steveamena/Graduacion/Solución/Diseño Mecánico/Transportadores/Transportador 3D Creativa.jpeg

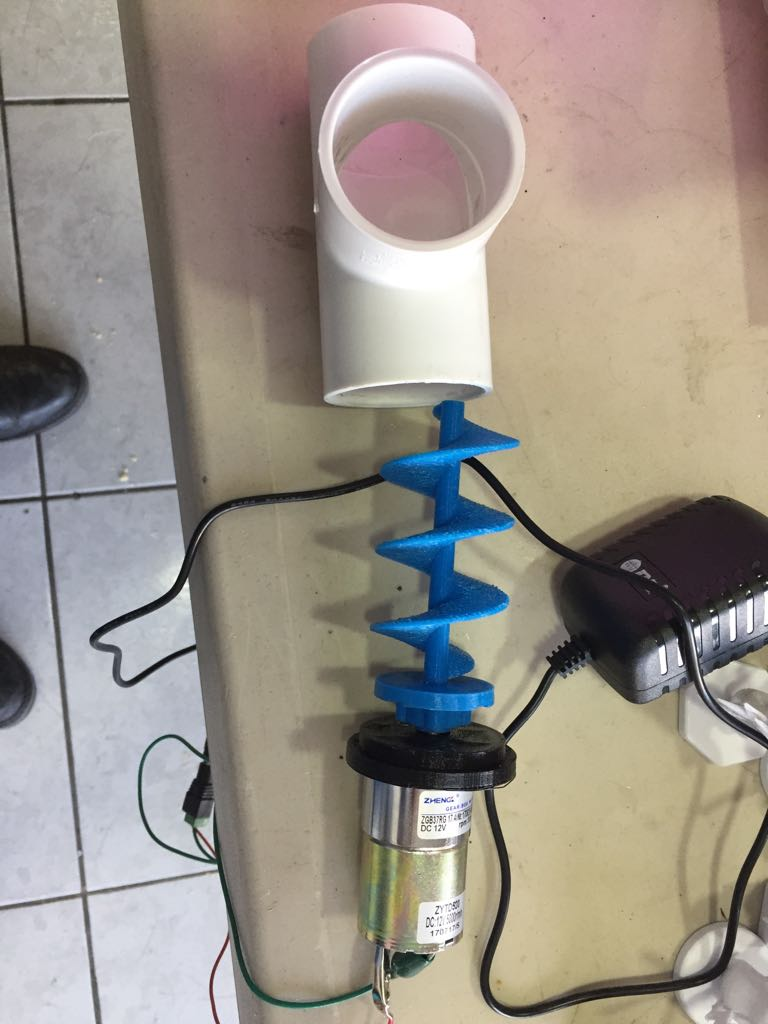
Solución/Diseño Mecánico/Transportadores/Transportador 3D Creativa.jpeg
