steveamena/Graduacion/Render1.JPG

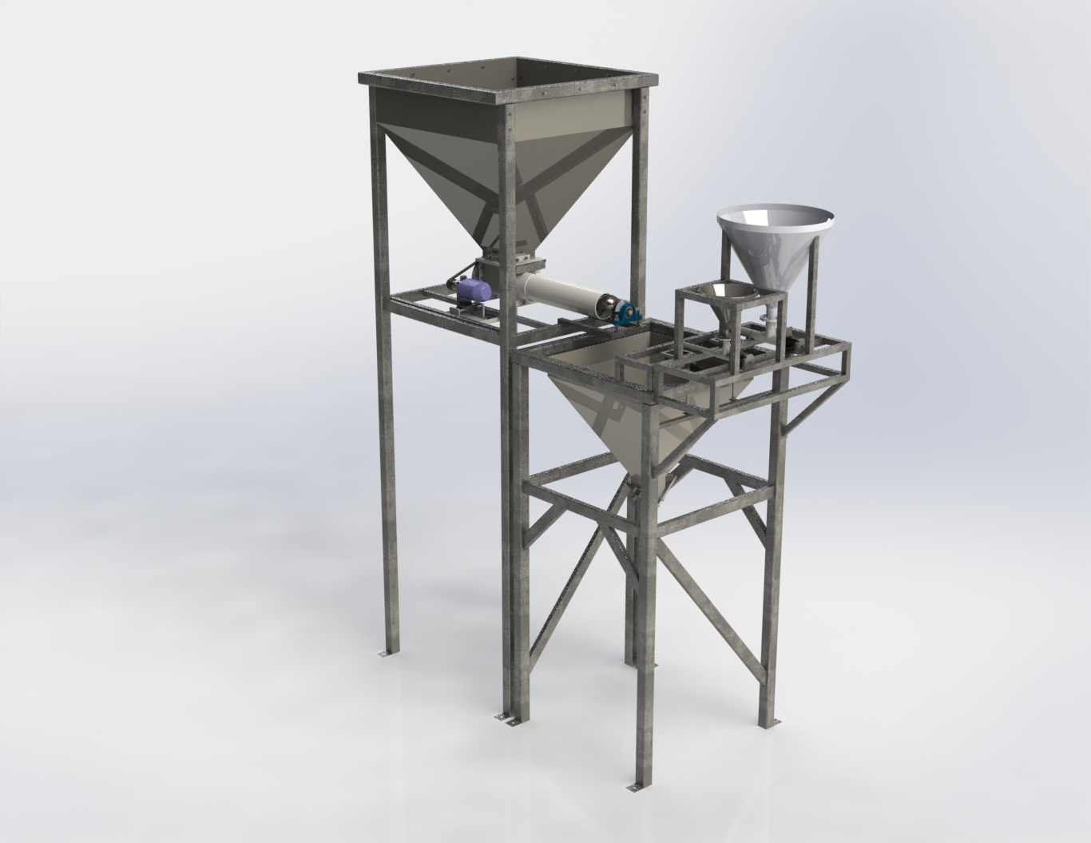
Render1.JPG
