steveamena/Graduacion/Solución/Diseño Máquina/LEEME.txt

Esta carpeta contiene los acrhivos CAD generados a partir del 
1 de Mayo de 2019.
