steveamena/Graduacion/Solución/Diseño Mecánico/Esclusas/Levadura Masas.pdf

Mass properties of asmLevEsc Configuration: Default
Coordinate system: -- default --

Mass = 52.49 grams

Volume = 47289.30 cubic millimeters

Surface area = 36973.46 square millimeters

Center of mass: ( millimeters )
X = -5.60
Y = 2.73
Z = 73.47

Principal axes of inertia and principal moments of inertia: ( grams * square millimeters ) aTken at the center of mass.
Ix = ( 0.46, 0.89, 0.00) | Px = 21502.87
Iy = (-0.89, 0.46, 0.01) | Py = 50477.72
Iz = ( 0.01, 0.00, 1.00) | Pz = 55048.71

Moments of inertia: ( grams * square millimeters )
aTken at the center of mass and aligned with the output coordinate system. Lxx = 44404.78 | Lxy = 1793.48 | Lxz = -33.11
Lyx = 1793.48 | Lyy = 27576.00 | Lyz = 0.20
Lzx = -33.11 | Lzy = 0.20Lzz = 55048.51

Moments of inertia: ( grams * square millimeters ) aTken at the output coordinate system.
Ixx = 328162.01 | Ixy = 10991.09 | Ixz = -21614.01
Iyx = 10991.09 | Iyy = 312585.08 | Iyz = 10535.84
Izx = -21614.01 | Izy = 10535.84 | Izz = 57083.81
