steveamena/Graduacion/Solución/Diseño Mecánico/Diseños conceptuales/README.txt

Carpeta contiene los diseños generados cuando se
discutieron los diseños conceptuales iniciales. 
-------------------------------------------------
Se tuvo una reunión con Don Héctor y Don Miguel para 
discutir y decantarse por uno en particular.

Propuesta 1: 	Diseño que al final fue usado como base
		para la propuesta que se ha trabajado 
		hasta el momento.
Propuesta 2: 	Diseño utilizado con cintas transportadora
Propuesta 3:	Cada alimento se pesa por separado
		y se deposita en cada recinto por separado.
--------------------------------------------------
Propuesta final:Se mejoró la propuesta 1 seleccionada
		para su presentación con el ingeniero
		Evelio experto en plantas.
		
Propuesta	Para evitar el problema del contenedor 
contenedores	de concentrado fuera tan alto, se diseñó
ángulo:		una basuca para desde el piso hasta la parte
		más alta.
		Además, para evitar tornillos sin fin de o vibradores
		se pensó en dosificar la levadura por volumen.

Propuesta	Una vez conceptualizado la idea desde su primera etapa		
prototipo	se pensó en realizar un diseño con las mejoras propuestas
construcción	para de una vez pasar a la etapa de construcción. Al final este 
		diseño no fue construido.
