steveamena/Graduacion/Solución/Diseño Mecánico/Tolva Romana/README.txt

Carpeta que contiene los diseños generados para la construcción
del modelo de la tolva romana en hierro 26 esmaltado.
