steveamena/Graduacion/Solución/Diseño Mecánico/Transportadores/README.txt

Esta carpeta contiene los intentos de hacer los tornillos sin
fin en impresión 3D.

Al final descartada la idea de hacerlo así.
