steveamena/Graduacion/Anteproyecto/Versión segundo semestre/Carta de aceptación.docx

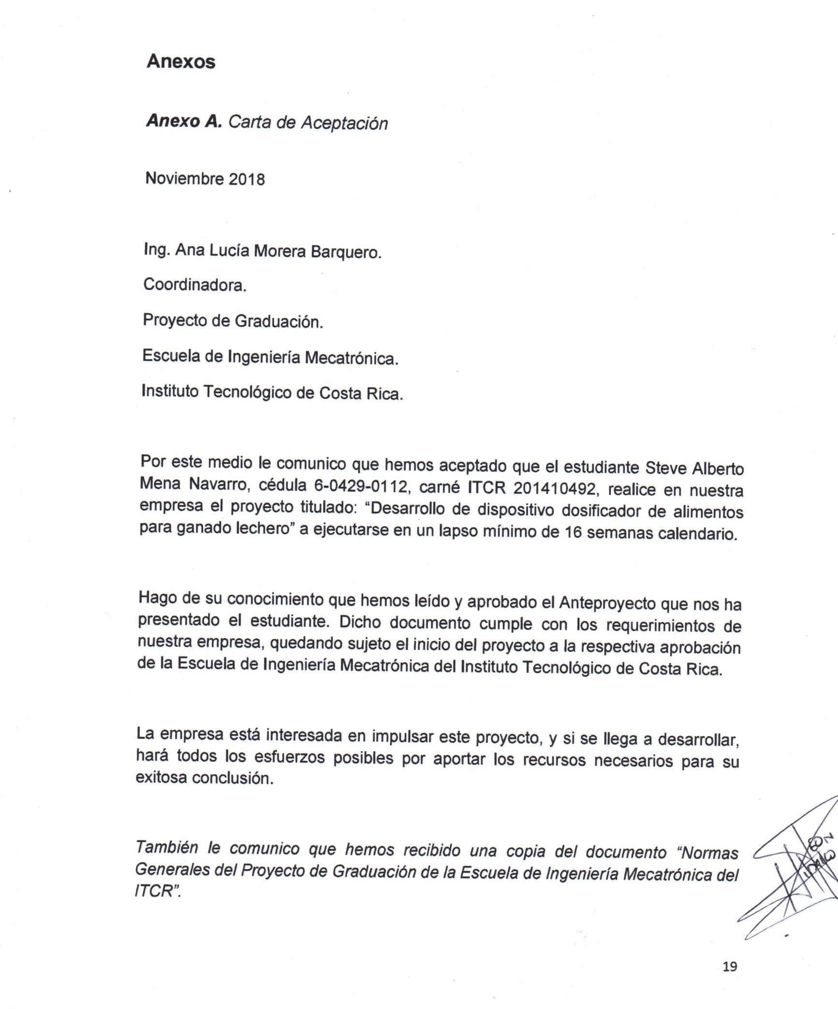
[picture p9: figure]
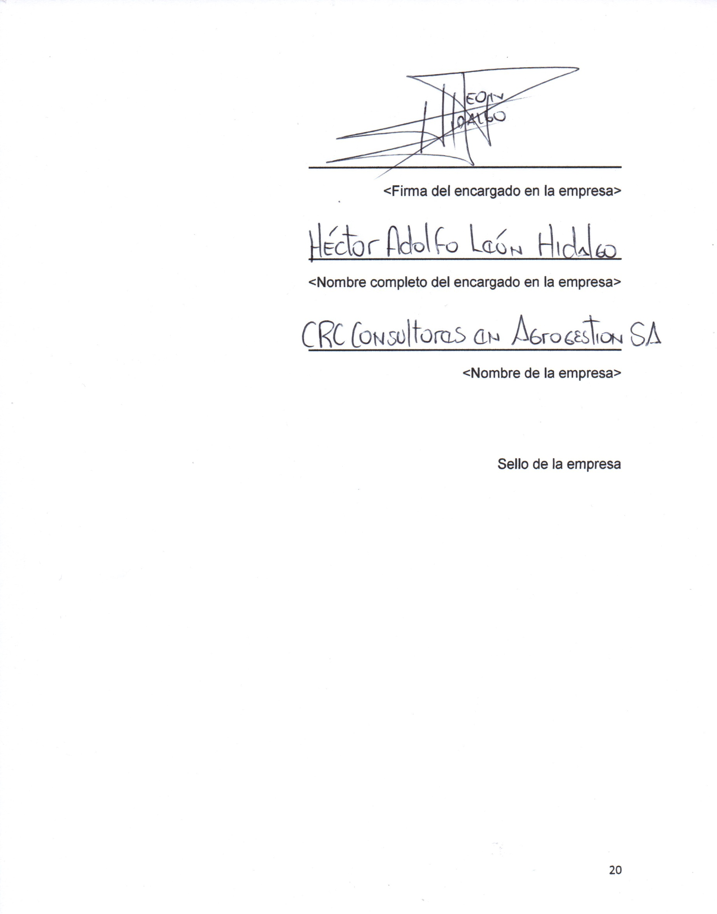
[picture p10: figure]
