steveamena/Graduacion/Anteproyecto/TEC Anteproyecto 21.pdf

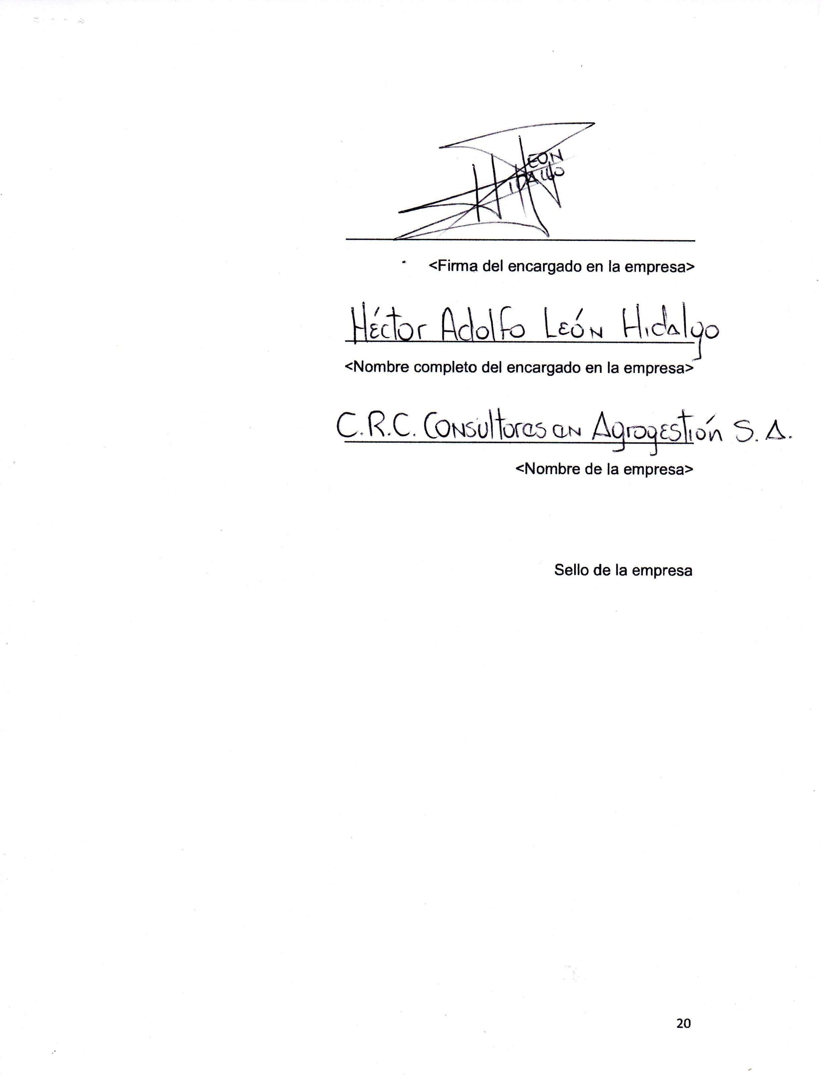
[picture p29: page 1]
