steveamena/Graduacion/Solución/Diseño Mecánico/Calculo de tolvas.xlsx

Sheet: Cálculo contenedor Concentrado
Hoja de excel requerida para calcular los tamaños de las tolvas contenedoras de alimento
El calculo se realizó con la densidad del material más pequeña encontrada.
Steve Mena Navarro
2018-11-29 | Esta es una nueva versión con unos requerimientos nuevos para el concetrado
2019-02-07 | Se realizón una revisión de los requerimientos para la tesis de graduación. Se adjunta la foto de la pizarra en el cual se tomó el diseño de esta tolva
Concentrado |  |  | Proceso de cálculo
Se va a calcular el tamaño de la tolva, con las restricciones de: |  |  | 1 | Calcular volumen requerido
1 | El volumen debe ser el requerido por un factor de seguridad |  |  | Volumen (cm3) | 1150000
2 | La cantida de material debe minizarse. |  | 2 | Calcular volumen con FS
3 | Se va a variar la altura del cuadrado, y el lado del cuadrado |  |  | Volumen (cm3) | 1380000
 |  |  | 3 | Realizar todo el proceso de cálculo tolva contenedora
 |  |  |  | Parámetros a encontrar
Parámetros |  |  |  | (a) Lado Mayor | (b) Altura del cono | © Altura del prisma | (d) Apertura de salida
Angulo (°) | 30 |  |  | 148.125946 | 119.4820141 | 20.49963802 | 10.16
Ángulo (rad) | 0.5235987756 |  |  | Ecuación 1
Apertura del tubo (cm) | 10.16 | cm |  | Volumen prisma | Area Mayor | Area Menor | Volumen pirámide | Volumen total
Densidad del material (g/cm3) | 0.44 |  |  | 449788.6234 | 21941.29589 | 81.07319666 | 930211.482 | 1380000.105
Masa requerida (g) | 506000 | Esto es 10 qq + 10% |  | Ecuación de volumen
FS | 1.2 |  |  | Objetivo | -0.1054130641
Alimento por vaca (g/vaca) | 6000
Vacas totales (vaca) | 50 |  |  | Mantener el ángulo deseado°
 |  |  |  | Objetivo | 9.748646335e-11
 |  |  |  | Minimizar la cantidad de material
 |  |  |  | Objetivo | 55822.25368

Sheet: Cálculo contenedor CC
Hoja de excel requerida para calcular los tamaños de las tolvas contenedoras de alimento |  |  |  |  |  |  |  |  |  |  |  | Hoja de excel requerida para calcular los tamaños de las tolvas contenedoras de alimento
El calculo se realizó con la densidad del material más pequeña encontrada. |  |  |  |  |  |  |  |  |  |  |  | El calculo se realizó con la densidad del material más pequeña encontrada.
Steve Mena Navarro |  |  |  |  |  |  |  |  |  |  |  | Steve Mena Navarro
2018-10-15 |  |  |  |  |  |  |  |  |  |  |  | 2018-11-29 | Esta nueva versión se realizó con las nuevas especificaciones dadas
CitroCon |  |  |  |  |  | Proceso de cálculo |  |  |  |  |  | CitroCon |  | Proceso de cálculo
Se va a calcular el tamaño de la tolva, con las restricciones de: |  |  |  |  |  | 1 | Calcular volumen requerido |  |  |  |  | Se va a calcular el tamaño de la tolva, con las restricciones de: |  | 1 | Calcular volumen requerido
1 | El volumen debe ser el requerido por un factor de seguridad |  |  |  |  |  | Volumen (cm3) | 400000 |  |  |  | 1 | El volumen debe ser el requerido por un factor de seguridad |  | Volumen (cm3) | 400000
2 | La cantida de material debe minizarse. |  |  |  |  | 2 | Calcular volumen con FS |  |  |  |  | 2 | La cantida de material debe minizarse. | 2 | Calcular volumen con FS
3 | Se va a variar la altura del cuadrado, y el lado del cuadrado |  |  |  |  |  | Volumen (cm3) | 520000 |  |  |  | 3 | Se va a variar la altura del cuadrado, y el lado del cuadrado |  | Volumen (cm3) | 480000
 |  |  |  |  |  | 3 | Realizar todo el proceso de cálculo tolva contenedora |  |  |  |  |  |  | 3 | Realizar todo el proceso de cálculo tolva contenedora
 |  |  |  |  |  |  | Parámetros a encontrar |  |  |  |  |  |  |  | Parámetros a encontrar
Parámetros |  |  |  |  |  |  | (a) Lado Mayor | (b) Altura del cono | © Altura del prisma | (d) Apertura de salida |  | Parámetros |  |  | (a) Lado Mayor | (b) Altura del cono | © Altura del prisma | (d) Apertura de salida
Angulo (°) | 30 |  |  |  |  |  | 101.1873873 | 81.03173435 | 14.10608457 | 7.62 |  | Angulo (°) | 30 |  | 104.142905 | 83.59128779 | 14.46926636 | 7.62
Ángulo (rad) | 0.5235987756 |  |  |  |  |  | Ecuación 1 |  |  |  |  | Ángulo (rad) | 0.5235987756 |  | Ecuación 1
Apertura del tubo (cm) | 7.62 |  |  |  |  |  | Volumen prisma | Area Mayor | Area Menor | Volumen pirámide | Volumen total | Apertura del tubo (cm) | 7.62 |  | Volumen prisma | Area Mayor | Area Menor | Volumen pirámide | Volumen total
Densidad del material (g/cm3) | 0.345 |  |  |  |  |  | 144430.6107 | 10238.88734 | 45.60367312 | 296247.0081 | 440677.6189 | Densidad del material (g/cm3) | 0.345 |  | 156929.9684 | 10845.74466 | 45.60367312 | 323070.0316 | 480000
Masa requerida (g) | 138000 |  |  |  |  |  | Ecuación de volumen |  |  |  |  | Masa requerida (g) | 138000 |  | Ecuación de volumen
FS | 1.3 |  |  |  |  |  | Objetivo | 79322.38113 |  |  |  | FS | 1.2 |  | Objetivo | -1.222360879e-09
Alimento por vaca (g/vaca) | 2000 |  |  |  |  |  |  |  |  |  |  | Alimento por vaca (g/vaca) | 2000
Vacas totales | 50 |  |  |  |  |  | Mantener el ángulo deseado° |  |  |  |  | Vacas totales | 50 |  | Mantener el ángulo deseado°
 |  |  |  |  |  |  | Objetivo | 1.691091711e-12 |  |  |  |  |  |  | Objetivo | 0
 |  |  |  |  |  |  | Minimizar la cantidad de material |  |  |  |  |  |  |  | Minimizar la cantidad de material
 |  |  |  |  |  |  | Objetivo | 26071.07726 |  |  |  |  |  |  | Objetivo | 27602.84626
Modo 1 Dada una altura, calcular un lado |  |  |  | Modo 2: Dado un lado, calcular una altura
Altura deseada |  |  |  | Altura inicial
9 | cm |  |  | 16.46038685 | cm
Volumen deseado |  |  |  | Volumen deseado
5597 | cm3 |  |  | 5597 | cm3
Angulo deseado (respecto a la vertical) |  |  |  | Angulo deseado (respecto a la vertical)
30 | ° |  |  | 25 | °
0.5235987756 | rad |  |  | 0.436332313
Lado inicial |  |  |  | Lado deseado
7.668492943 | cm |  |  | 10.22384276 | cm
 |  |  |  | Razon aurea
 |  |  |  | 1.61
Area menor | Area mayor | Volumen total | Error | Area menor | Area mayor | Volumen total | Error
58.80578402 | 326.1924168 | 1570.491903 | 4026.508097 | 104.5269608 | 654.0832668 | 5597.000838 | -0.0008377049635

Sheet: Cálculo de fuerza
Material | Adicional |  | Cálculo de presión
Densidad |  |  | Exponencial | Factor | Factor 2
533 | kg/m3 |  | -0.2574444357 | 0.2269754223 | 3312.455114
Coef. Fricción
0.25 | adim |  | Total
Gravedad |  |  | 751.8458984 | Pa
9.72 | m/s2 |  | Fuerza
Altura |  |  | 7.858816677 | N
0.1646038685 | m |  | 0.8011026175 | kgf
Lado mayor |  | Dimátero hidráulico
0.2557505165 | m | 0.2557505165
K
0.4 | adim
Lado menor
0.1022384276

Sheet: Calculo tolva romana
Determinación de volumen de la tolva romana |  |  |  |  |  |  |  |  | Cálculo de tolva romana versión 2
En esta hoja se intentó determinar el tamaño de la tolva romana, sujeto a 7 ecuaciones contemplando el factor de seguridad. |  |  |  |  |  |  |  |  | Esta parte de la hoja de calculo pretende es para hacer el diseño de la tolva con las modificaciones pertinentes.
Los cálculos previos están en la hoja del 1 de Octubre, consecutivo 5. |  |  |  |  |  |  |  |  | 2018-10-18
Verificación realizada el 5/4/2019 por S Mena |  |  |  |  |  |  |  |  | Verificado por S Mena | 2019-04-05
Tolva general |  |  |  |  | Tolva mineral |  |  |  | Tolva que recoge todos los puntos
Volumen deseado |  | Factor de seguridad |  | Volumen total | Volumen deseado |  | Factor de seguridad | Volumen total | Espeficicaciones de diseño |  |  | Parámetros a determinar |  |  | Parámetros de diseño
13939 | cm3 | 1.3 |  | 18120.7 | 160.6 | cm3 | 1.3 | 208.78 | 1. La tolva tiene que sostener hasta 15 kg del alimento más ligero. |  |  | a (cm) | Largo de la boca de ingreso |  | Masa concentrado (g) | Masa del concentrado a contener
 |  |  |  |  |  |  |  |  | 2. Debe alojar 4 celdas de carga |  |  | b (cm) | Largo de la boca de salida |  | Masa adicional (g) | Masa del adicional
Parámetros a encontrar |  |  |  |  | Parámetros a encontrar |  |  |  | 3. Debe minizar la cantidad de material necesario. |  |  | c (cm) | Altura de la parte recta |  | Densidad conc. (g/cm3) | Menor Densidad del concentrado menos denso según los datos de DP
a | b | c | d |  | a | b |  |  | 4. El ángulo de reposo del material debe ser de 60° con las paredes |  |  | d (mm) | Altura de la parte menor |  | Densidad adic. (g/cm3) | Menor Densidad del adicional según Evelio
41.47045797 | 20.73922138 | 12.42693967 | 10.36961069 |  | 5.050985283 | 8.182596159 |  |  | 5. El actuador debe estar a 90° |  |  |  |  |  | Masa total permitida (g) | Masa máxima que es capaz de soportar la tolva
Ecuación 1 |  |  |  |  | Ecuación 1 |  |  |  | 6. Debe ser simétrico. |  |  | h (cm) | Altura de la parte cónica de la tolva |  | Angulo vertical (°)
Volumen cubo | Area Mayor | Area Menor | Volumen pirámide |  | Volumen cubo |  |  |  | 7. La apertura debe ser de 10 cm. Para entrar en un tubo de 5 in sanitario.
1601.366843 | 1719.798885 | 154.4288297 | 16519.33316 |  | 208.7580945 |  |  |  | 8. El factor de seguridad es de 1,5
Objetivo | 5.115293789e-08 |  |  |  | Objetivo | 0.0219055258 |  |  | Proceso de cálculo
 |  |  |  |  |  |  |  |  | Paso 1 |  |  |  |  | Paso 2
Ecuación 2 |  |  |  |  | Ecuación 2 |  |  |  | Determinar el volumen máximo y la masa de cada uno de los alimentos guardando una proporción entre el adicional y el concentrado |  |  |  |  | Determinar los parámetros de diseño.
Objetivo | 0 |  |  |  | Objetivo | 3.803179993e-12 |  |  | Se aplicó SOLVER PARA DETERMINAR LA MASA MÁXIMA DE CADA ALIMENTO. |  |  |  |  | Determinar las ecuaciones de diseño
 |  |  |  |  |  |  |  |  | Se fijó la masa total como ecuación y se fue variando la cantidad de concentrado |  |  |  |  | Paso 2.1
Ecuación 3 |  |  |  |  |  |  |  |  | el volumen final se tomó como citerio de diseño |  |  |  |  | Convertir el ángulo a radianes
Objetivo | 0 |  |  |  |  |  |  |  |  |  |  |  |  | Angulo vertical (°) | 30
 |  |  |  |  |  |  |  |  | Entrada |  |  |  |  | Angulo vertidal (rad) | 0.5235987756
 |  |  |  |  |  |  |  |  | Relación (con./adic.) | 3
 |  |  |  |  |  |  |  |  |  |  |  |  |  | Parámetros
 |  |  |  |  |  |  |  |  | Tabla con resultados |  |  |  |  | a (cm) | b (cm) | c (cm) | d (cm) | h (cm) | Area mayor (cm2) | Area Menor (cm2)
 |  |  |  |  |  |  |  |  |  | Masa (g) | Densidad (g/cm3) | Volumen (cm3) |  | 60 | 10 | 8 | 5 | 43.30127019 | 3600 | 100
 |  |  |  |  |  |  |  |  | Conc. | 11250.006 | 0.44022 | 25555.41775
 |  |  |  |  |  |  |  |  | Adic. | 3750.002 | 0.295 | 12711.87119 |  | Minimización de material (ecuación objetivo) (cm2)
 |  |  |  |  |  |  |  |  | Total | 15000.008 | 0.3919798977 | 38267.28893 |  | 9120
 |  |  |  |  |  |  |  |  | Volumen de diseño | 22500.012 |  | 57400.9334 |  | Delta
 |  |  |  |  |  |  |  |  | F.S. | 1.5 |  |  |  | Volumen requerido (cm3)
 |  |  |  |  |  |  |  |  |  |  |  |  |  | -5263.753841
 |  |  |  |  |  |  |  |  |  |  | Volumen | 62664.68724
 |  |  |  |  |  |  |  |  |  |  | Delta | 9.17015374
 |  |  |  |  |  |  |  |  |  |  | Masa nueva | 24563.29769
 |  |  |  |  |  |  |  |  |  |  | Delta | 9.17015374

Sheet: Calculo de esfuerzos tolva
Objetivo: Calcula espesor de pared para la tolva romana.
Calculo de esfuerzos en la tolva asumir concentrado como material, despreciar el resto.
Steve Mena Navarro
2019-02-20
Comentario: Se utilizó el método de Jannsen para cálculo de esfuero en Parte A y C, mientras que el código europeo para el esfuero en B
Método Jannsen | http://www.dietmar-schulze.de/spanne.html
Norma Europea: | http://fgg-web.fgg.uni-lj.si/~/pmoze/esdep/master/wg15c/l0200.htm
Parte A: |  |  |  |  | Parte b |  |  |  |  | Cálculo de pandeo
Constantes del sistema |  |  |  |  | Constantes del sistema |  |  |  |  | Constantes del sistema
Constante | Valor | Unidad |  |  | Cb | 1.2 |  |  |  | h | 0.5001158906 | m
g | 9.81 | N/kg |  |  | alfa | 0.524 | rad | Equivale a 30° |  | a1 | 0.1 | m
densidad | 529.86 | kg/m3 | Se utilizó el promedio mayor de los datos de DT y MP, concentrado Lechera NPP |  | pv0 | 398.7574986 | Pa |  |  | a2 | 0.6 | m
Área | 0.343396 | m2 | Primero se diseñó por volumen y luego se verificó. |  | L | 50.01158906 |  |  |  | E | 200000000000
Perímetro | 2.344 | cm |  |  |  |  |  |  |  | k | 1
angulo fricción | 0.3 |  | http://citeseerx.ist.psu.edu/viewdoc/download?doi=10.1.1.1033.4612&rep=rep1&type=pdf |  |  |  |  |  |  | Cálculo de b eq
lambda | 0.5 |  | Asumido | http://www.dietmar-schulze.de/spanne.html | Calculo de presiones |  |  | Cortante |  | b eq | 0.2501158906
z | 0.08 | cm |  |  | p1 | 508.4573873 | Pa | 309.1629075 | Pa
 |  |  |  |  | p2 | 358.7154425 | Pa |  |  | Calculo de t
 |  |  |  |  | p3 | 522.0856377 | Pa | Esfuerzo von Mises |  | 72784293.43
Cálculo de esfuerzo horizontal |  |  | Calculo esfuerzo cortante |  | Pperpendiular | 1030.543025 | Pa | 1161.363008
1 Calcular factores |  |  | 61.67507457 | Pa |  |  |  |  |  | Espesor
2461.710349 | Pa |  |  |  |  |  |  | Esfuerzo de descarga |  | 2.931719728e-05
 |  |  |  |  |  |  |  | 2322.726016
Calcular exponencial
0.9190080387
Calcular esfuerzo
199.3787493 | Pa
0.0001993787493 | Mpa

Sheet: Cálculo contenedor
Determinación de volumen de los contenedores
En esta hoja se intentó determinar el tamaño de los contenedores para cada alimento sujeto a 3 ecuaciones contemplando el factor de seguridad.
Los cálculos previos están en la hoja del 1 de Octubre, consecutivo 6.
Concentrado |  |  |  |  | CitroCon
Volumen deseado |  | Factor de seguridad |  | Volumen total | Volumen deseado |  | Factor de seguridad |  | Volumen total | Volumen deseado |  | Factor de seguridad |  | Volumen total
253376.9231 | cm3 | 1.3 |  | 329390 | 163284.6154 | cm3 | 1.3 |  | 212270 | 704.7 | cm3 | 1.3 |  | 329390
Parámetros a encontrar |  |  |  |  | Parámetros a encontrar |  |  |  |  | Parámetros a encontrar
a | b | c | d |  | a | b | c | d |  | a | b | c | d
92.04049826 | 41.02024913 | 30 | 10 |  | 66.95278367 | 28.47639183 | 46.13175477 | 10 |  | 77.05655347 | 33.52827673 | 54.31580831 | 10
Ecuación 1 |  |  |  |  | Ecuación 1 |  |  |  |  | Ecuación 1
Volumen cilindro | Area Mayor | Area Menor | Volumen pirámide |  | Volumen cilindro | Area Mayor | Area Menor | Volumen pirámide |  | Volumen cilindro | Area Mayor | Area Menor | Volumen pirámide
199603.9164 | 8471.45332 | 100 | 129786.1308 |  | 162415.3725 | 4482.675241 | 100 | 49854.59761 |  | 253300.0578 | 5937.712432 | 100 | 76089.94258
Objetivo | -0.04713864543 |  |  |  | Objetivo | 0.02989572255 |  |  |  | Objetivo | -0.0003638823691
Ecuación 2 |  |  |  |  | Ecuación 2 |  |  |  |  | Ecuación 2
Objetivo | 0 |  |  |  | Objetivo | 0 |  |  |  | Objetivo | -6.394884622e-13
Ecuación 3 |  |  |  |  | Ecuación 3 |  |  |  |  | Ecuación 3
Objetivo | 71.02024913 |  |  |  | Objetivo | 0 |  |  |  | Objetivo | 0
Mineral |  |  |  |  | Levadura
Volumen deseado |  | Factor de seguridad |  | Volumen total | Volumen deseado |  | Factor de seguridad |  | Volumen total
253380 | cm3 | 1.3 |  | 329394 | 704.7 | cm3 | 1.3 |  | 916.11
Parámetros a encontrar |  |  |  |  | Parámetros a encontrar
a | b | c | d |  | a | b | c | d
41.47045797 | 20.73922138 | 12.42693967 | 4 |  | 10.51551509 | 4.652559944 | 7.537147109 | 4
Ecuación 1 |  |  |  |  | Ecuación 1
Volumen cilindro | Area Mayor | Area Menor | Volumen pirámide |  | Volumen cilindro | Area Mayor | Area Menor | Volumen pirámide
16785.40152 | 1719.798885 | 16 | 13146.45913 |  | 654.5728306 | 110.5760576 | 16 | 261.5329842
Objetivo | 299462.1394 |  |  |  | Objetivo | 0.004185262984
Ecuación 2 |  |  |  |  | Ecuación 2
Objetivo | -8.426939674 |  |  |  | Objetivo | 3.144151606e-13
Ecuación 3 |  |  |  |  | Ecuación 3
Objetivo | 21.17059897 |  |  |  | Objetivo | 0

Sheet: Dimensionado tolva mineral
Hoja de excel requerida para calcular los tamaños de las tolvas contenedoras de alimento
El calculo se realizó con la densidad del material más pequeña encontrada.
Steve Mena Navarro
2018-11-29
Mineral |  |  | Proceso de cálculo
Se va a calcular el tamaño de la tolva, con las restricciones de: |  |  | 1 | Calcular volumen requerido
1 | El volumen debe ser el requerido por un factor de seguridad |  |  | Volumen (cm3) | 16064.25703
2 | La cantida de material debe minizarse. |  | 2 | Calcular volumen con FS
3 | Se eligió utilizar tolvas con forma circular en acero inoxidable |  |  | Volumen (cm3) | 19277.10843
 |  |  | 3 | Realizar todo el proceso de cálculo tolva contenedora en este caso será una tolva cónica
 |  |  |  | Parámetros a encontrar
Parámetros |  |  |  | (a) Diámetro mayor | (b) Altura del cono | © Altura del prisma | (d) Apertura de salida
Angulo (°) | 30 | Medido repecto a la vertical |  | 43.97529644 | 35.88401933 | 0 | 2.54
Ángulo (rad) | 0.5235987756 |  |  | Ecuación 1
Apertura del tubo (cm) | 2.54 | cm |  | Volumen prisma | Area Mayor | Area Menor | Volumen cono | Volumen total
Densidad del material (g/cm3) | 1.245 |  |  | 0 | 1518.823936 | 5.067074791 | 19277.10843 | 19277.10843
Masa requerida (g) | 20000 |  |  | Ecuación de volumen
FS | 1.2 |  |  | Objetivo | -2.92857294e-09
Alimento por vaca (g/vaca) | 100
Vacas totales (vaca) | 50 |  |  | Mantener el ángulo deseado°
 |  |  |  | Objetivo | 0
 |  |  |  | Minimizar la cantidad de material
 |  |  |  | Generatriz | 41.43529644
 |  |  |  | Area cónica | 3027.513723
 |  |  |  | Area total | 3027.513723

Sheet: Dimensionado tolva levadura
Hoja de excel requerida para calcular los tamaños de las tolvas contenedoras de alimento
El calculo se realizó con la densidad del material más pequeña encontrada.
Steve Mena Navarro
2018-11-29
Levadura |  |  | Proceso de cálculo
Se va a calcular el tamaño de la tolva, con las restricciones de: |  |  | 1 | Calcular volumen requerido
1 | El volumen debe ser el requerido por un factor de seguridad |  |  | Volumen (cm3) | 704.2253521
2 | La cantida de material debe minizarse. |  | 2 | Calcular volumen con FS
3 | Se eligió utilizar tolvas con forma circular en acero inoxidable |  |  | Volumen (cm3) | 1408.450704
 |  |  | 3 | Realizar todo el proceso de cálculo tolva contenedora en este caso será una tolva cónica
 |  |  |  | Parámetros a encontrar
Parámetros |  |  |  | (a) Diámetro mayor | (b) Altura del cono | © Altura del prisma | (d) Apertura de salida
Angulo (°) | 30 | Medido repecto a la vertical |  | 18.38506955 | 14.79610426 | 0 | 1.3
Ángulo (rad) | 0.5235987756 |  |  | Ecuación 1
Apertura del tubo (cm) | 1.3 | cm |  | Volumen prisma | Area Mayor | Area Menor | Volumen cono | Volumen total
Densidad del material (g/cm3) | 0.71 | g/cm3 |  | 0 | 265.4730477 | 1.327322896 | 1408.45029 | 1408.45029
Masa requerida (g) | 500 |  |  | Ecuación de volumen
FS | 2 |  |  | Objetivo | 0.0004139712655
Alimento por vaca (g/vaca) | 10 | g/cm3
Vacas totales (vaca) | 50 |  |  | Mantener el ángulo deseado°
 |  |  |  | Objetivo | -6.75015599e-14
 |  |  |  | Minimizar la cantidad de material
 |  |  |  | Generatriz | 17.08506955
 |  |  |  | Area cónica | 528.2914496
 |  |  |  | Area total | 528.2914496
