steveamena/Graduacion/Solución/Diseño Mecánico/Transportadores/Calculo de cilindros.xlsx

Calculo del tambor para el concentrado |  |  |  |  | Calculo del tambor para el adicional
Variable | valor | Unidad |  |  | Variable | valor | Unidad
Masa requerida | 25.00 | g |  |  | Masa requerida | 5.00 | g
Densidad requerida | 0.66 | g/cm2 |  |  | Densidad requerida | 0.54 | g/cm2
Volumen requerido | 37.82 | cm3 |  |  | Volumen requerido | 9.33 | cm3
Medidas calculadas |  |  |  |  | Medidas calculadas
Radio | 2.89 | cm |  |  | Radio | 1.95 | cm
Diametro | 5.78 | cm |  |  | Diametro | 3.90 | cm
Diámetro | 2.27 | in |  |  | Diámetro | 1.54 | in
Multiplo más cercano | 2.25 | in |  |  | Multiplo más cercano | 1.50 | in
Medidas comerciales |  |  |  |  | Medidas comerciales
Radio del tubo | 2.50 | in |  |  | Radio del tubo | 2.00 | in
Ancho del cilindro | 2.00 | in |  |  | Ancho del cilindro | 1.50 | in
Volumen total | 2.45 | in3 | 40.22 | cm3 | Volumen total | 1.00 | in3 | 16.39
Diámetro varilla calibrada | 0.50 | in |  |  | Diámetro varilla calibrada | 0.50 | in
Volumen del cuarto de la varilla | 0.10 | in3 |  |  | Volumen del cuarto de la varilla | 0.07 | in3
Volumen neto del cuarto de cilindro | 2.36 | in3 | 38.61110991 | cm3 | Volumen neto del cuarto de cilindro | 0.93 | in3 | 15.18046682
Masa neta por descarga | 25.52 | g |  |  | Masa neta por descarga | 8.14 | g
