steveamena/Graduacion/Solución/Diseño Mecánico/Esclusas/Adicional/Calculo de tolva de adicional.xlsx

Sheet: Cálculo por volumen
Modo 1 Dada una altura, calcular un lado |  |  |  | Modo 2: Dado un lado, calcular una altura
Altura deseada |  |  |  | Altura inicial
9 | cm |  |  | 16.46038255 | cm
Volumen deseado |  |  |  | Volumen deseado
5597 | cm3 |  |  | 5597 | cm3
Angulo deseado (horizontal) |  |  |  | Angulo deseado (horizontal)
30 | ° |  |  | 25 | °
0.5235987756 |  |  |  | 0.436332313
Lado inicial |  |  |  | Lado deseado
7.668492943 | cm |  |  | 10.22384684 | cm
 |  |  |  | Razon aurea
 |  |  |  | 1.609998938
Area menor | Area mayor | Volumen total | Error | Area menor | Area mayor | Volumen total | Error
58.80578402 | 326.1924168 | 1570.491903 | 4026.508097 | 104.5270442 | 654.0832703 | 5597.000428 | -0.0004282342798

Sheet: Cálculo de fuerza
Material | Adicional |  | Cálculo de presión
Densidad |  |  | Exponencial | Factor | Factor 2
533 | kg/m3 |  | -0.2574443678 | 0.2269753698 | 3312.455123
Coef. Fricción
0.25 | adim |  | Total
Gravedad |  |  | 751.8457266 | Pa
9.72 | m/s2 |  | Fuerza
Altura |  |  | 7.858821146 | N
0.1646038255 | m |  | 0.801103073 | kgf
Lado mayor |  | Dimátero hidráulico
0.2557505172 | m | 0.2557505172
K
0.4 | adim
Lado menor
0.1022384684
