steveamena/Graduacion/Anteproyecto/Old Versions/Steve Mena Navarro Anteproyecto Final 20.pdf

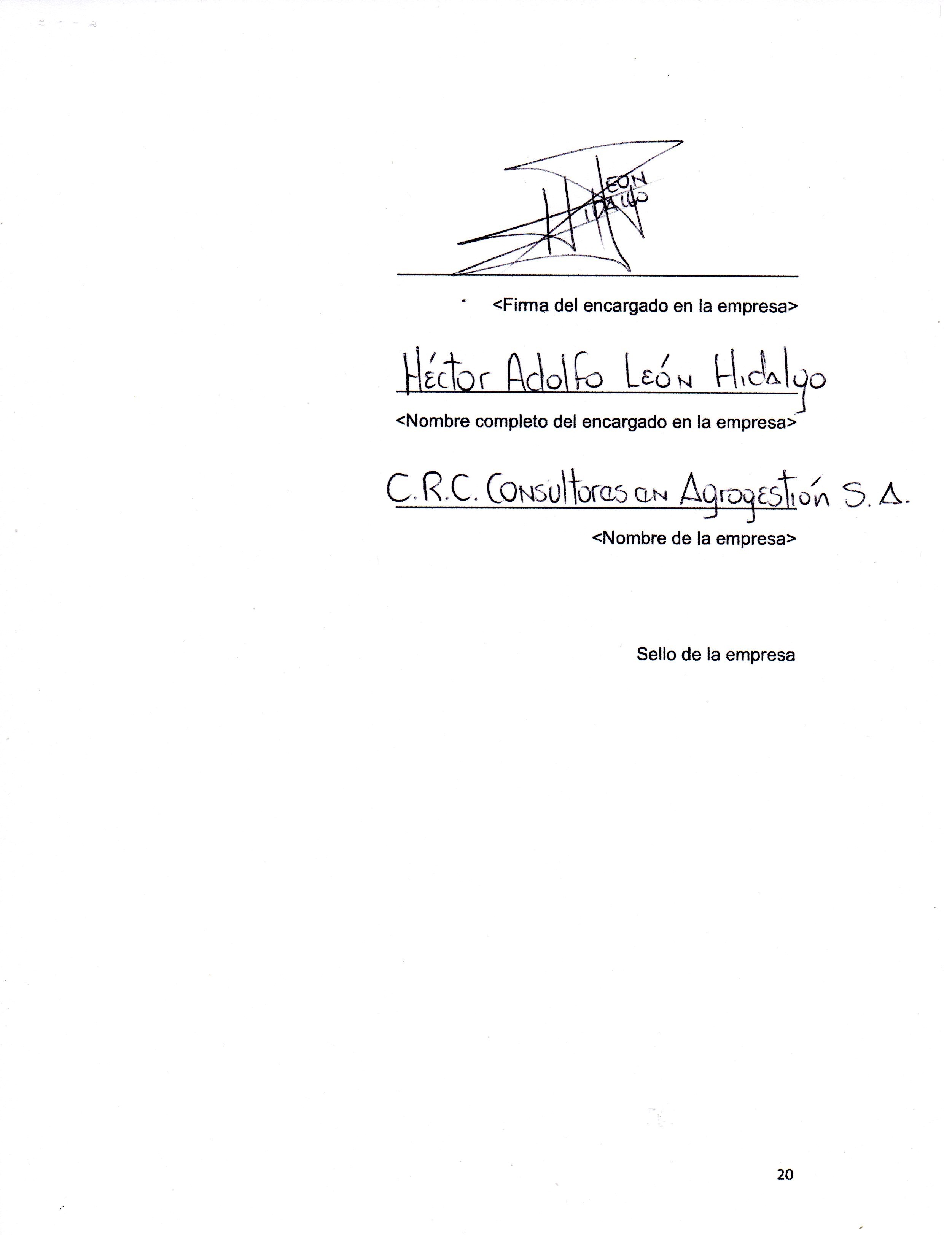
[picture p32: page 1]
