steveamena/Graduacion/Documentación/Conexión de internet.PNG

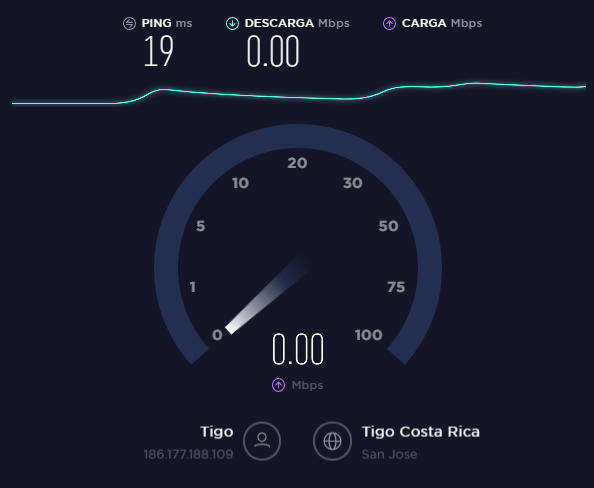
Documentación/Conexión de internet.PNG
