steveamena/Graduacion/Proyecto Graduación.bmp

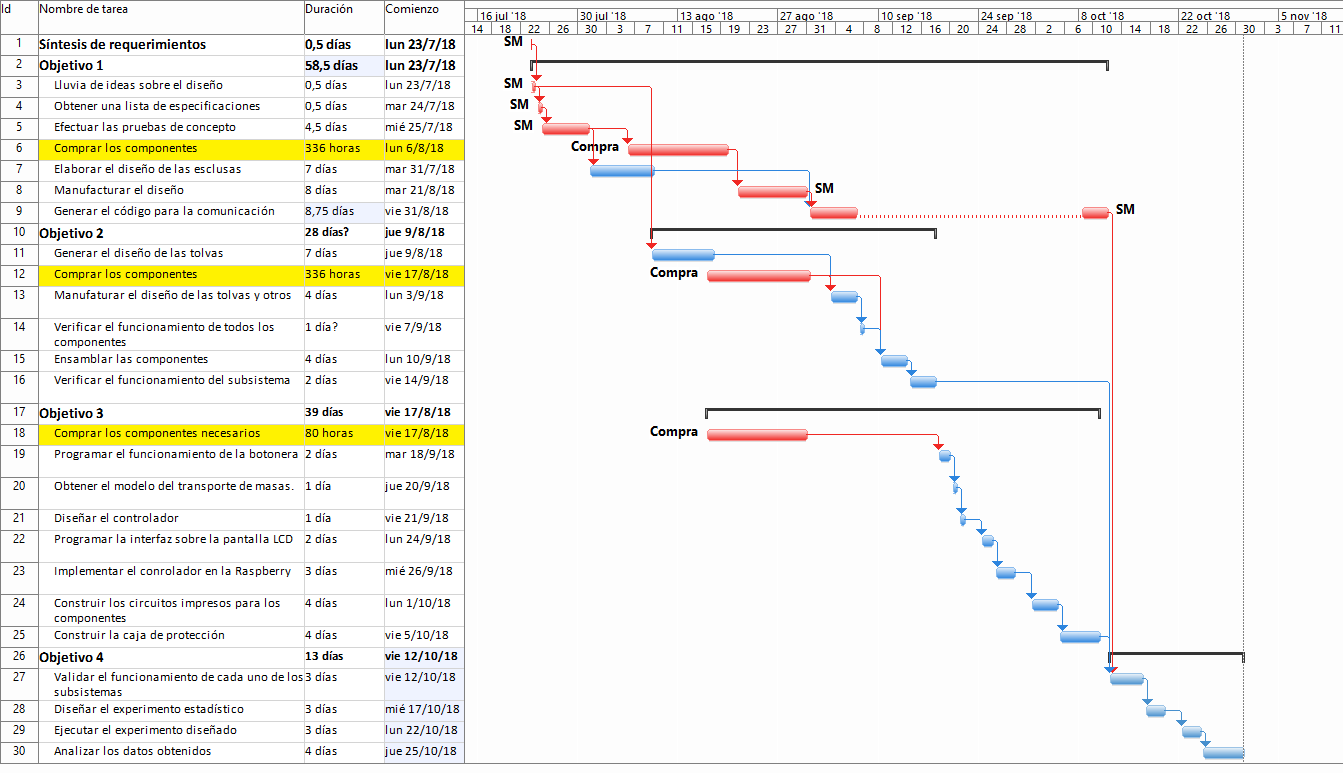
Proyecto Graduación.bmp
