steveamena/Graduacion/Requerimento Alimento Empresa.PNG

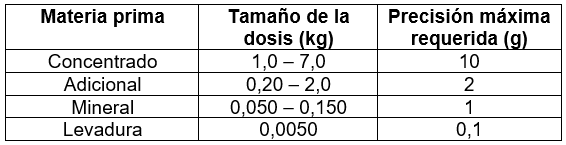
Requerimento Alimento Empresa.PNG
