steveamena/Graduacion/Solución/Diseño Mecánico/Transportadores/200um-Solid-Honeycomb.PNG

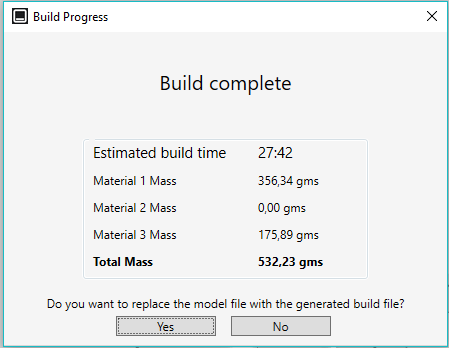
Solución/Diseño Mecánico/Transportadores/200um-Solid-Honeycomb.PNG
