steveamena/Graduacion/Solución/Diseño Mecánico/Transportadores/200um-Strong-Cross.PNG

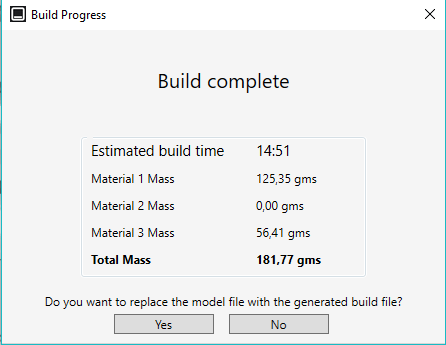
Solución/Diseño Mecánico/Transportadores/200um-Strong-Cross.PNG
