steveamena/Graduacion/Solución/Diseño Mecánico/Transportadores/Concentrado/Impresion 3D/TSF 1 200 um Solid Honeycomb.PNG

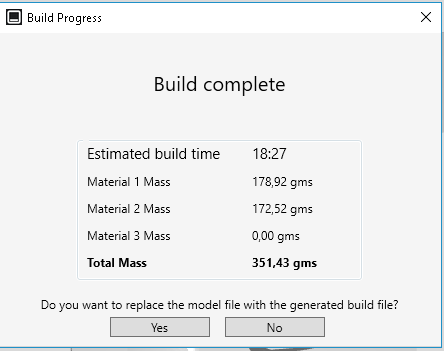
Solución/Diseño Mecánico/Transportadores/Concentrado/Impresion 3D/TSF 1 200 um Solid Honeycomb.PNG
