steveamena/Graduacion/Solución/Diseño Mecánico/Transportadores/Concentrado/Impresion 3D/TSF 1 300 um SOlid Honeycomb.PNG

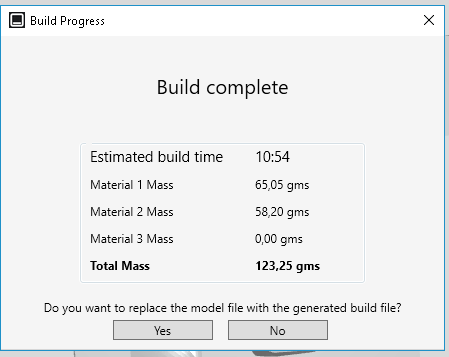
Solución/Diseño Mecánico/Transportadores/Concentrado/Impresion 3D/TSF 1 300 um SOlid Honeycomb.PNG
