steveamena/Graduacion/Solución/Diseño Mecánico/Transportadores/Concentrado/Impresion 3D/TSF 2 300 um Solid honeyComb.PNG

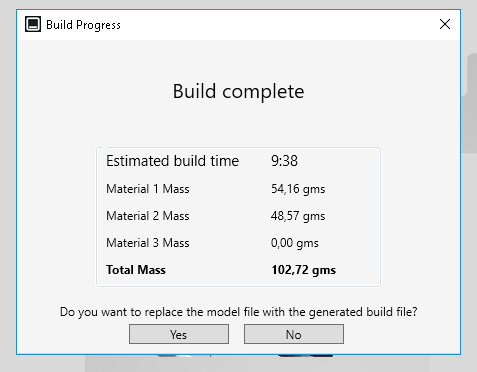
Solución/Diseño Mecánico/Transportadores/Concentrado/Impresion 3D/TSF 2 300 um Solid honeyComb.PNG
