steveamena/Graduacion/Solución/Diseño Mecánico/Transportadores/Concentrado/Impresion 3D/TSF 3 300 Solid Honeycomb.PNG

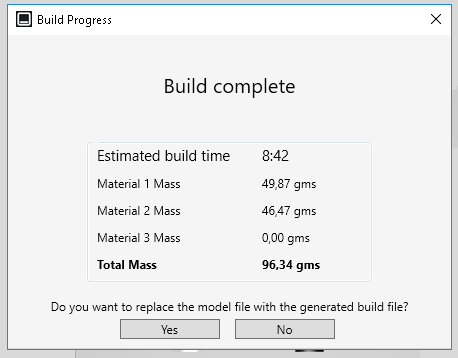
Solución/Diseño Mecánico/Transportadores/Concentrado/Impresion 3D/TSF 3 300 Solid Honeycomb.PNG
