steveamena/Graduacion/Solución/Diseño Mecánico/Diseños conceptuales/Propuesta 2/Idea 2.SLDASM

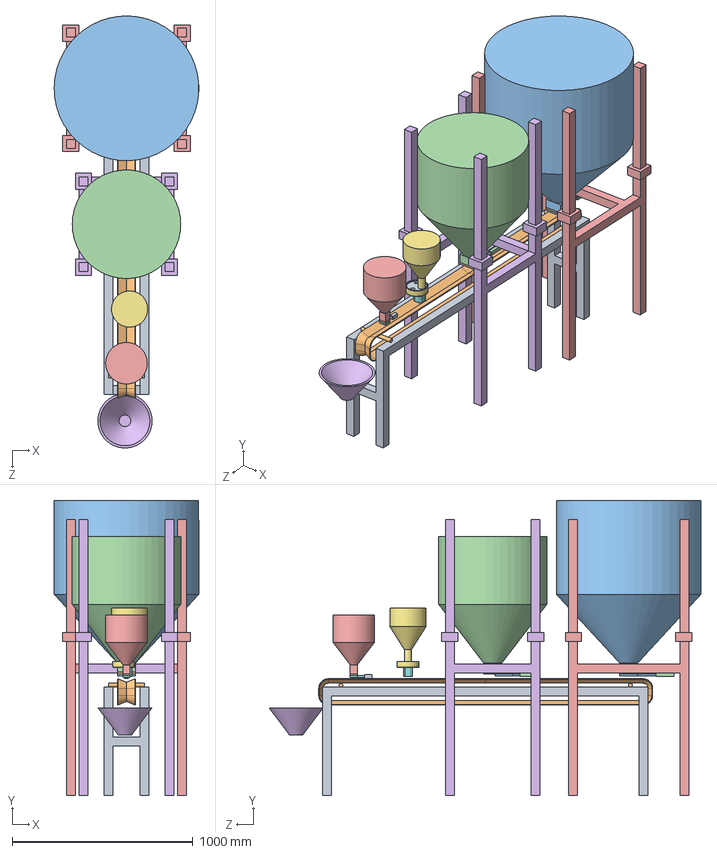
[picture p42: CAD file, 2018-11-02]
Solución/Diseño Mecánico/Diseños conceptuales/Propuesta 2/Idea 2.SLDASM
800.0 x 1633.0 x 2387.5 mm
Soporte Banda
Banda Transportadora
Tolva Concentrado
Tolva Adicional
Tolva Mineral
Cono
Tolva Levadura
Stepper Motor
Carrete Medidas Levadura
Compuerta Fija x 2
Compuerta Deslizante x 2
Piston x 2
Bastidor concentrado
Bastidor adicional
Compuerta Fija Pequeña
Compuerta Deslizante Pequeña
Piston pequeño
