steveamena/Graduacion/Solución/Diseño Mecánico/Diseños conceptuales/Propuesta 3/Idea 3.SLDASM

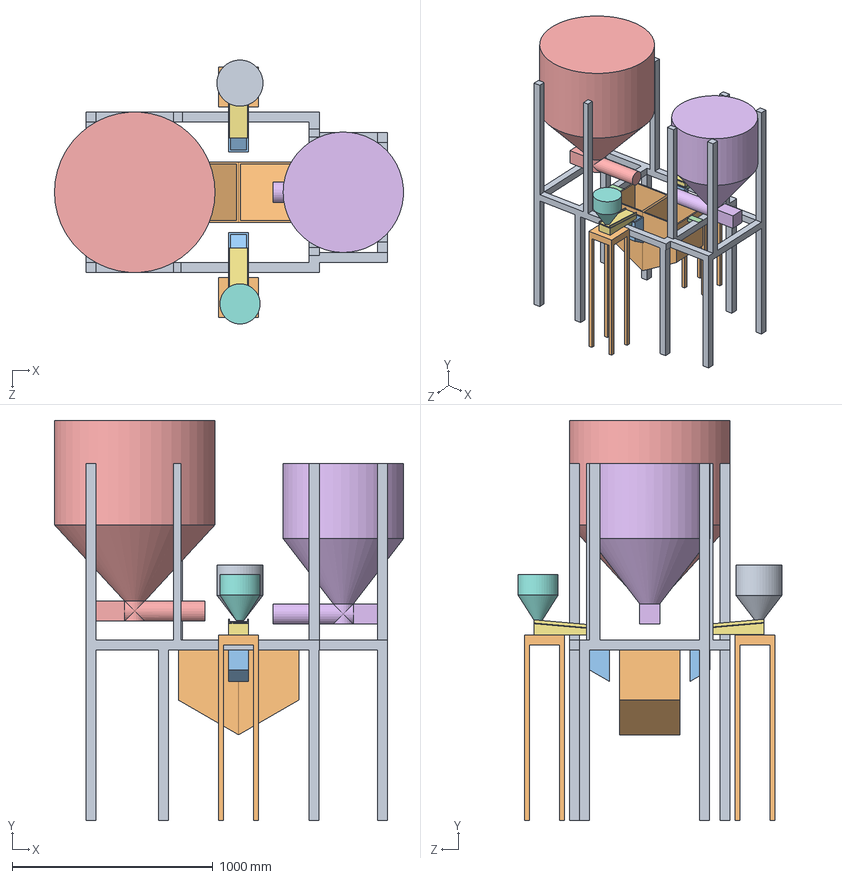
[picture p43: CAD file, 2018-11-02]
Solución/Diseño Mecánico/Diseños conceptuales/Propuesta 3/Idea 3.SLDASM
1739.2 x 1992.7 x 1314.9 mm
Mesa de Trabajo
Esclusa Concentrado x 2
Esclusa Mineral x 2
Celda de Carga x 4
Tolva Concentrado
Tolva Adicional
Vibrador x 2
Tolva Levadura
Tolva Mineral
Mesa Vibrador x 2
