steveamena/Graduacion/Solución/Diseño Mecánico/Diseños conceptuales/Propuesta prototipo construcción/Dosificador Citrocon/Tornillo sin Fin Citrocon.SLDASM

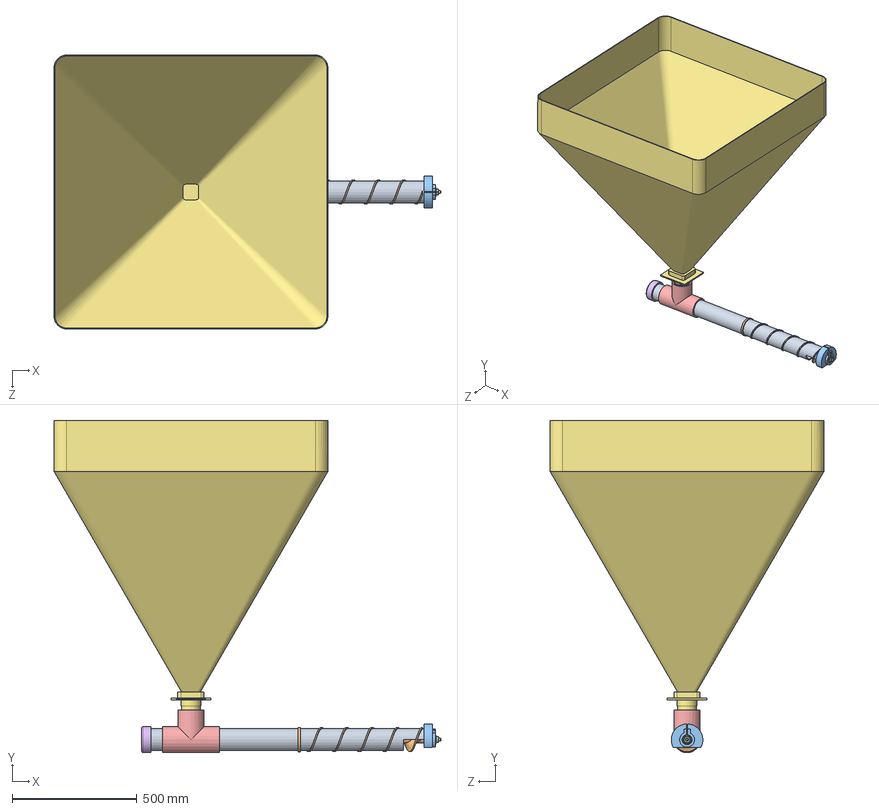
[picture p45: CAD file, 2019-02-25]
Solución/Diseño Mecánico/Diseños conceptuales/Propuesta prototipo construcción/Dosificador Citrocon/Tornillo sin Fin Citrocon.SLDASM
1552.0 x 1333.0 x 1098.6 mm
Tubo Principal 3in
YAR 203_12-2F-24 CC
Union Tee SCH40 3 in
Tapa PVC 3 in SCH40
Tolva Adicional
