steveamena/Graduacion/Solución/Diseño Mecánico/Diseños conceptuales/Propuesta prototipo construcción/Dosificador Mineral/Asm Dosificador Mineral.SLDASM

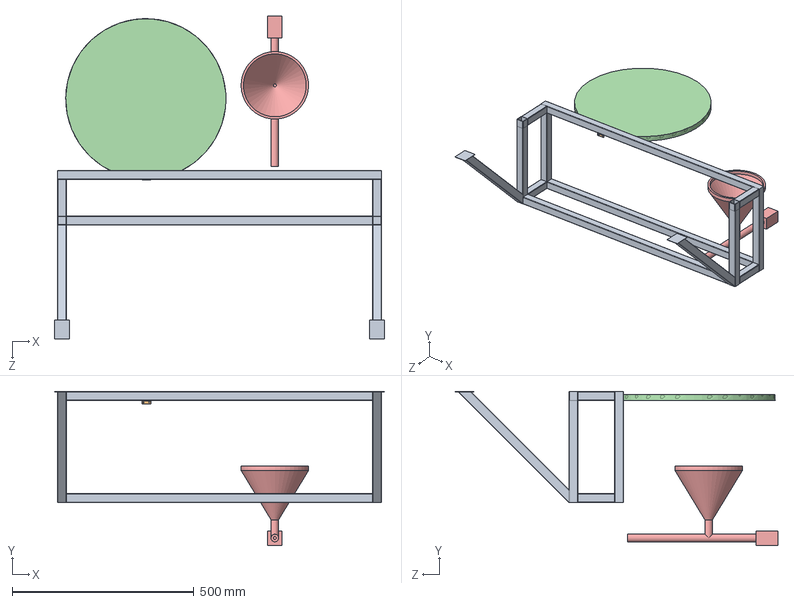
[picture p46: CAD file, 2019-04-17]
Solución/Diseño Mecánico/Diseños conceptuales/Propuesta prototipo construcción/Dosificador Mineral/Asm Dosificador Mineral.SLDASM
907.5 x 423.4 x 887.5 mm
Bastidor Mineral
Hinger1
Hinger2
Tapa
Tolva Levadura
