steveamena/Graduacion/Solución/Diseño Mecánico/Diseños conceptuales/Propuesta prototipo construcción/Tolva Romana/Asm Tolva Romana.SLDASM

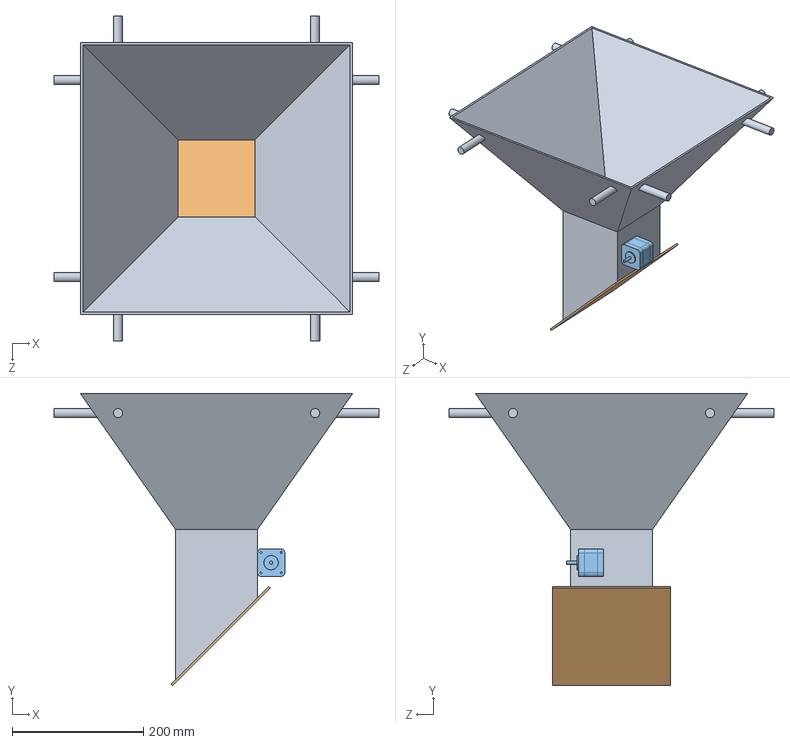
[picture p47: CAD file, 2018-11-02]
Solución/Diseño Mecánico/Diseños conceptuales/Propuesta prototipo construcción/Tolva Romana/Asm Tolva Romana.SLDASM
494.7 x 444.7 x 494.7 mm
Tolva Romana
Base Romana
Stepper Motor
