steveamena/Graduacion/Solución/Diseño Mecánico/Esclusas/Mineral/asmMinEsc.SLDASM

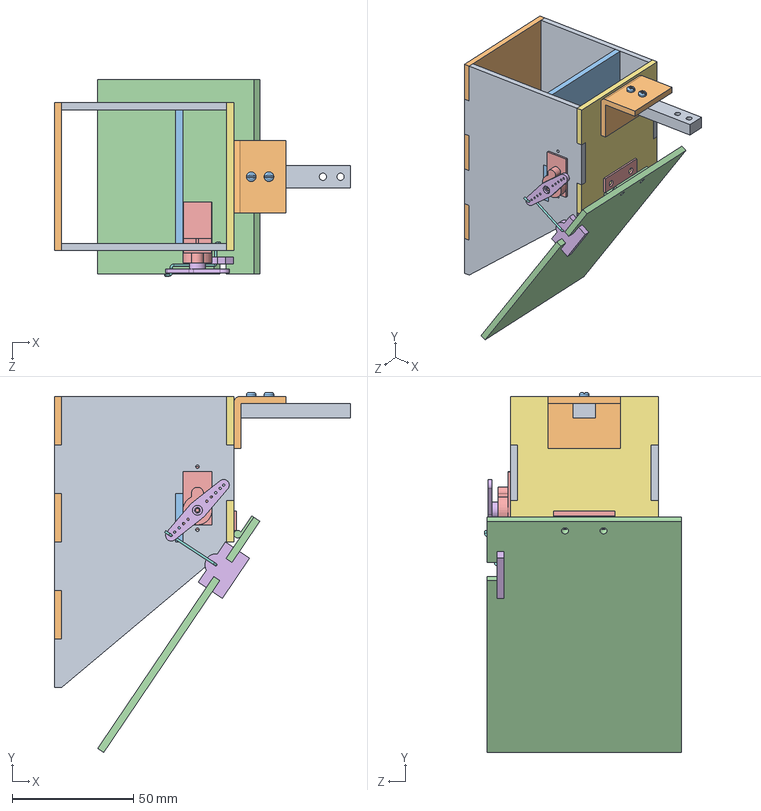
[picture p48: CAD file, 2019-02-25]
Solución/Diseño Mecánico/Esclusas/Mineral/asmMinEsc.SLDASM
122.2 x 148.4 x 81.0 mm
MinEscLateral x 2
MinEscFrontal
MinEscAtras
MinEscCompuerta
micro servo
ServoHorn
MinEscAtras2
MinEscPin
MinEscLoadCell
MinEscSoporte
pan slot head_am x 2
Hinger1
Hinger2
