steveamena/Graduacion/Solución/Diseño Máquina/Esclusas finos/E Min Esclusa.SLDASM

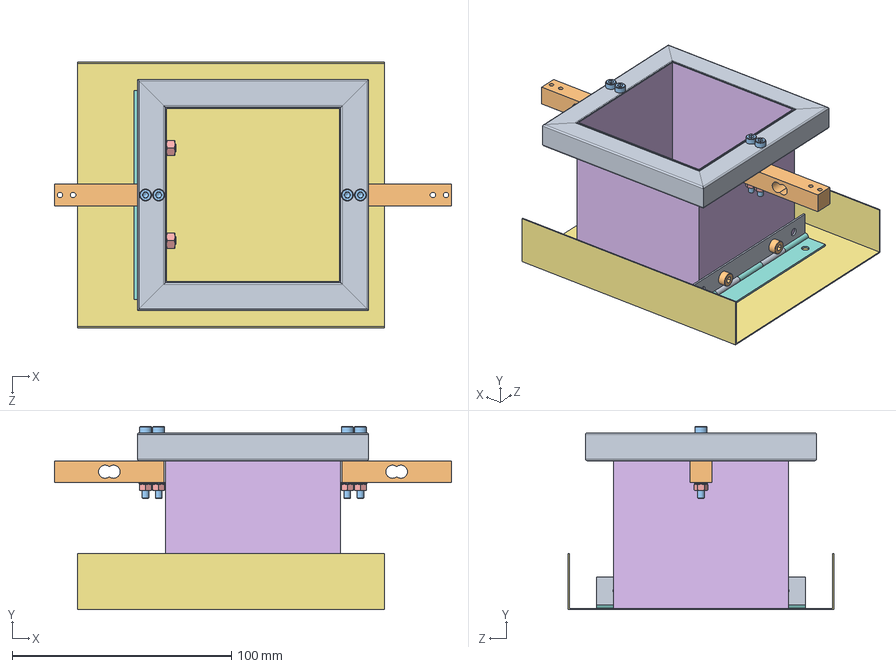
[picture p49: CAD file, 2019-05-14]
Solución/Diseño Máquina/Esclusas finos/E Min Esclusa.SLDASM
181.0 x 83.6 x 121.2 mm
Min Bastidor
uxCell x 2
socket head cap screw_am x 4
spring lock washer 2_din2 x 4
hex nut style 2_am x 6
Min Contenedor
Min Tapa
Hinge1
Hinge2
socket head cap screw_iso x 2
