steveamena/Graduacion/Solución/Diseño Máquina/Tolvas Romana/Cilindro/Piston.SLDASM

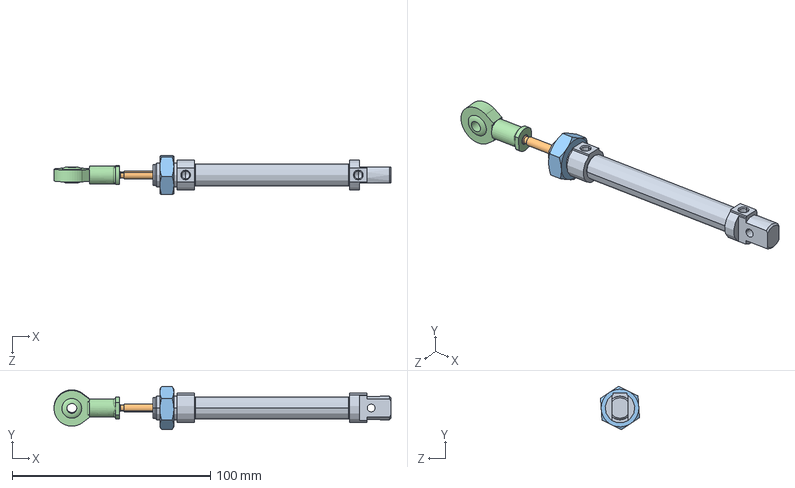
[picture p50: CAD file, 2019-05-08]
Solución/Diseño Máquina/Tolvas Romana/Cilindro/Piston.SLDASM
169.9 x 21.9 x 19.7 mm
16N2A10A050 Cilindro
16N2A10A050 Piston
Tuerca Piston
Rotula para vástago
