steveamena/Graduacion/Solución/Diseño Mecánico/Diseños conceptuales/Propuesta final Contenedores Angulo/A General Angulo.SLDASM

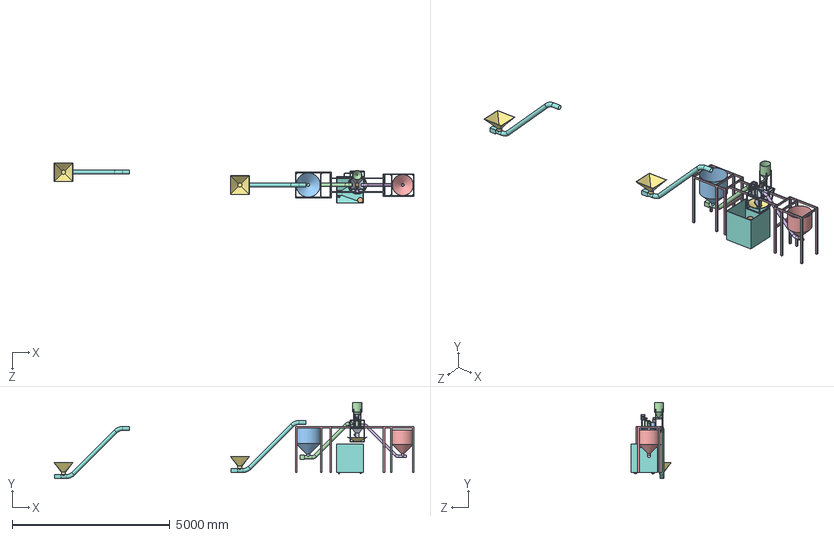
[picture p51: CAD file, 2018-11-02]
Solución/Diseño Mecánico/Diseños conceptuales/Propuesta final Contenedores Angulo/A General Angulo.SLDASM
11395.3 x 2408.8 x 1281.3 mm
Tolva Romana
Base Romana
Stepper Motor
Tolva Mineral
Vibrador
Contenedor Levadura
Superior Marco
Superior Stop
Tolva Levadura
Bastidor
Almohadilla x 4
LevCelCarga
Armazon Angulo
Celda de Carga x 5
Cono
BaseCarro
Ruedas x 4
Tolva Concentrado Angulo
TSF Angulo
Tolva Adicional Angulo
TSF Angulo Adicional
Recibidor x 2
Basuca x 2
TSF Mineral
Esclusa Mineral
Tubo mineral
Tubo Levadura
