steveamena/Graduacion/Solución/Diseño Mecánico/Diseños conceptuales/Propuesta final Contenedores Angulo/Adicional/A Adicional Angulo.SLDASM

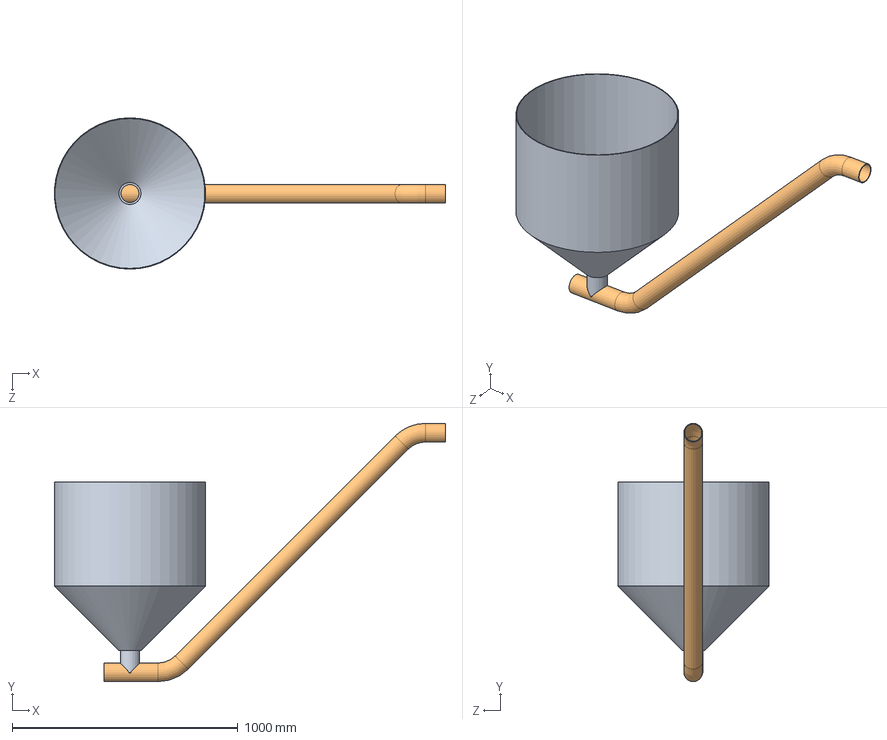
[picture p52: CAD file, 2018-11-02]
Solución/Diseño Mecánico/Diseños conceptuales/Propuesta final Contenedores Angulo/Adicional/A Adicional Angulo.SLDASM
1730.5 x 1143.2 x 669.6 mm
Tolva Adicional Angulo
TSF Angulo Adicional
