steveamena/Graduacion/Solución/Diseño Mecánico/Diseños conceptuales/Propuesta prototipo construcción/Alternativa levadura/Dosificadora Levadura.SLDASM

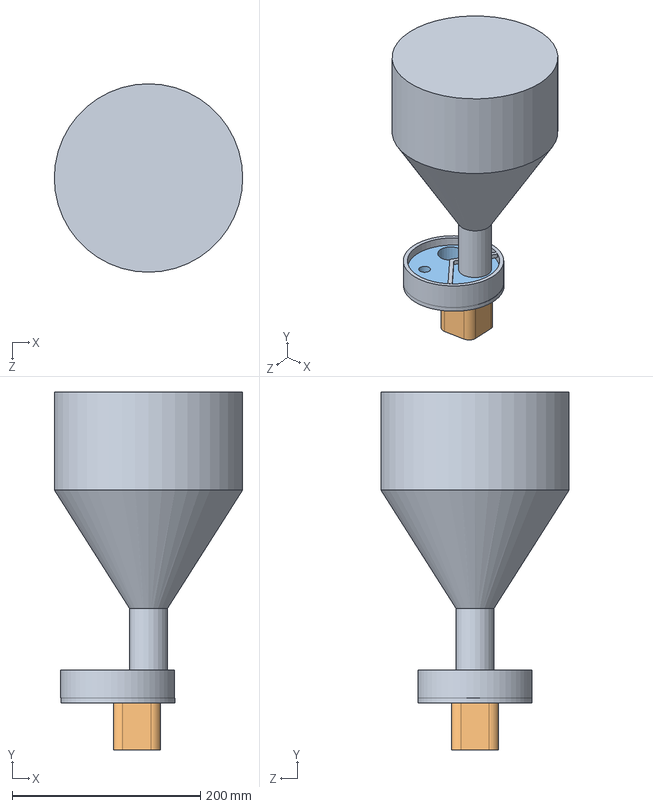
[picture p53: CAD file, 2018-10-02]
Solución/Diseño Mecánico/Diseños conceptuales/Propuesta prototipo construcción/Alternativa levadura/Dosificadora Levadura.SLDASM
200.0 x 380.0 x 200.0 mm
Tolva Levadura
Stepper Motor
Carrete Medidas Levadura
