steveamena/Graduacion/Solución/Diseño Máquina/Concentrado/A Concentrado.SLDASM

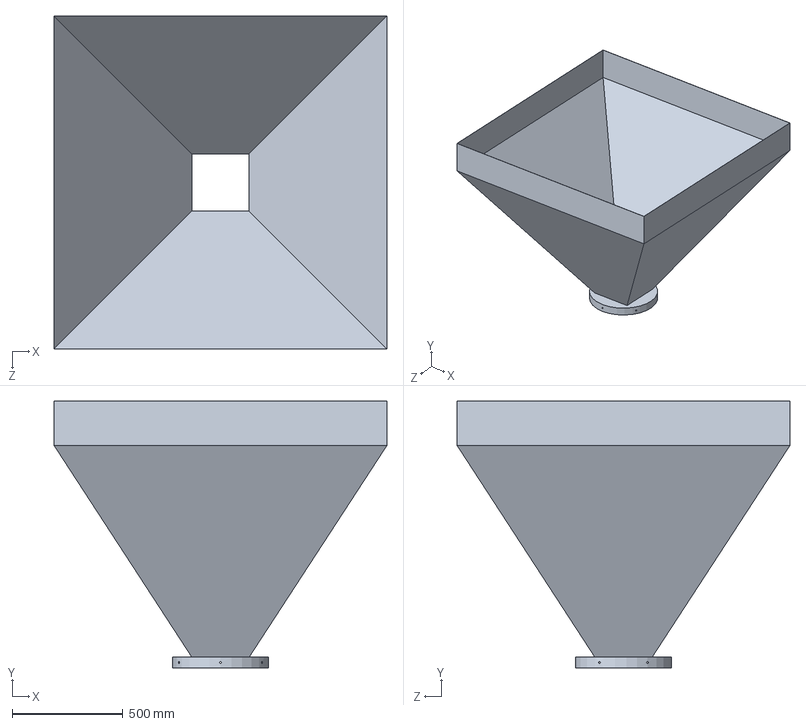
[picture p54: CAD file, 2019-05-12]
Solución/Diseño Máquina/Concentrado/A Concentrado.SLDASM
1500.0 x 1202.6 x 1500.0 mm
