steveamena/Graduacion/Solución/Diseño Máquina/Tolvas Romana/Cilindro/Piston 3 & 4.SLDASM

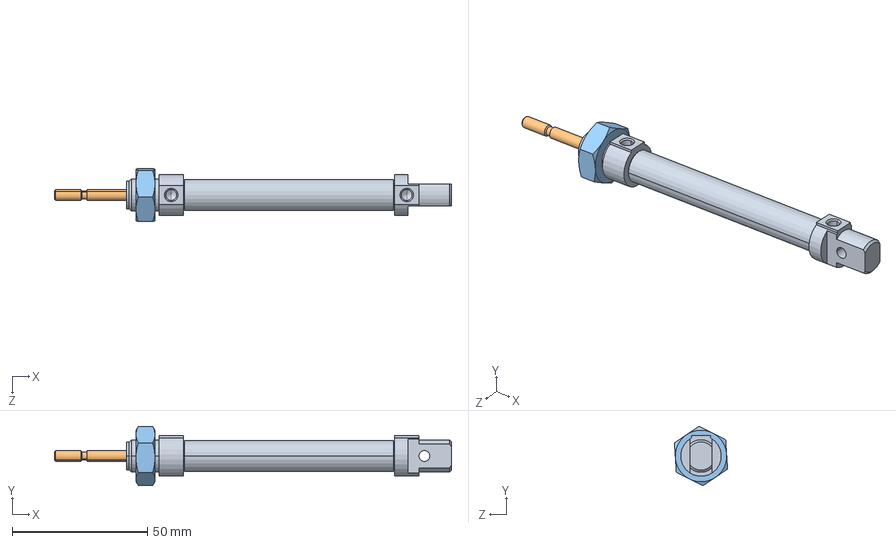
[picture p55: CAD file, 2019-05-08]
Solución/Diseño Máquina/Tolvas Romana/Cilindro/Piston 3 & 4.SLDASM
146.6 x 21.9 x 19.7 mm
16N2A10A050 Cilindro
16N2A10A050 Piston
Tuerca Piston
