steveamena/Graduacion/Solución/Diseño Mecánico/Diseños conceptuales/Propuesta prototipo construcción/Mesa de trabajo.SLDASM

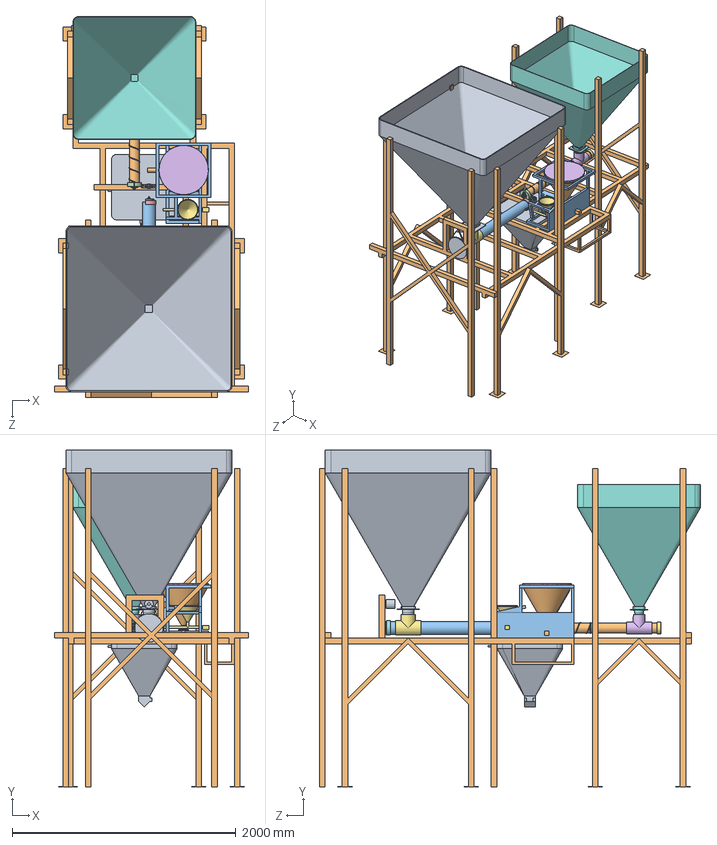
[picture p56: CAD file, 2019-02-25]
Solución/Diseño Mecánico/Diseños conceptuales/Propuesta prototipo construcción/Mesa de trabajo.SLDASM
1738.2 x 3012.5 x 3406.2 mm
Tolva Romana
Bastidor
Tubo Principal
Union Tee SCH40 4 in
Tapa PVC 4 in SCH40
Tolva Concentrado
Tubo Principal 3in
YAR 203_12-2F-24 CC
Union Tee SCH40 3 in
Tapa PVC 3 in SCH40
Tolva Adicional
10 kg Load cell
Tolva Mineral
Bastidor Mineral
Hinger1
Hinger2
Tapa
Tolva Levadura
Motor Polea
