steveamena/Graduacion/Solución/Diseño Mecánico/Diseños conceptuales/Propuesta prototipo construcción/Suministrador/A Suministrador.SLDASM

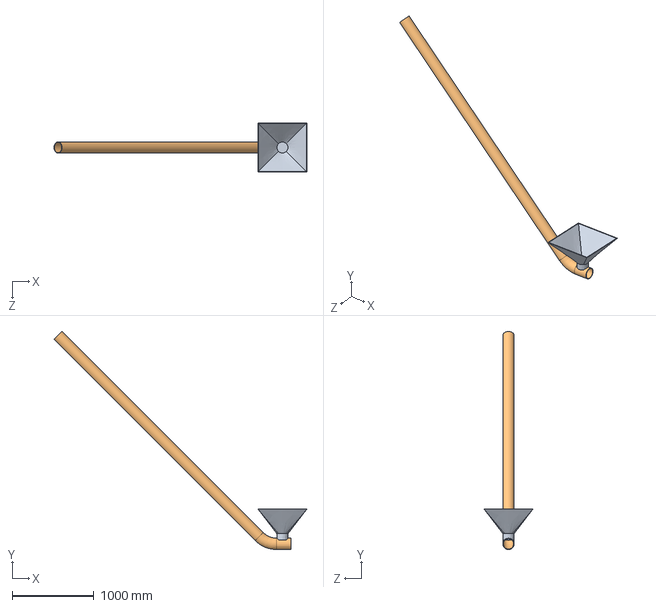
[picture p57: CAD file, 2018-10-03]
Solución/Diseño Mecánico/Diseños conceptuales/Propuesta prototipo construcción/Suministrador/A Suministrador.SLDASM
3089.9 x 2664.8 x 600.0 mm
Recibidor
Basuca
