steveamena/Graduacion/Solución/Diseño Mecánico/Diseños conceptuales/Propuesta prototipo construcción/UberCow/A UberCow.SLDASM

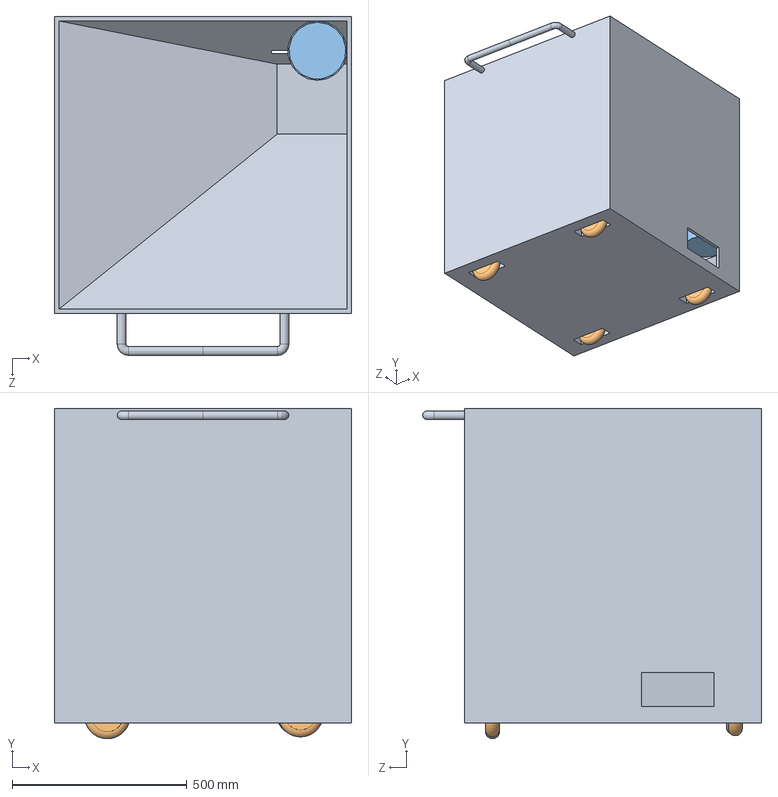
[picture p58: CAD file, 2018-10-03]
Solución/Diseño Mecánico/Diseños conceptuales/Propuesta prototipo construcción/UberCow/A UberCow.SLDASM
850.0 x 945.3 x 969.7 mm
BaseCarro
Ruedas x 4
Tubo Contenedor
