steveamena/Graduacion/Solución/Diseño Máquina/Tolvas Romana/Hinge/HingeAsm.SLDASM

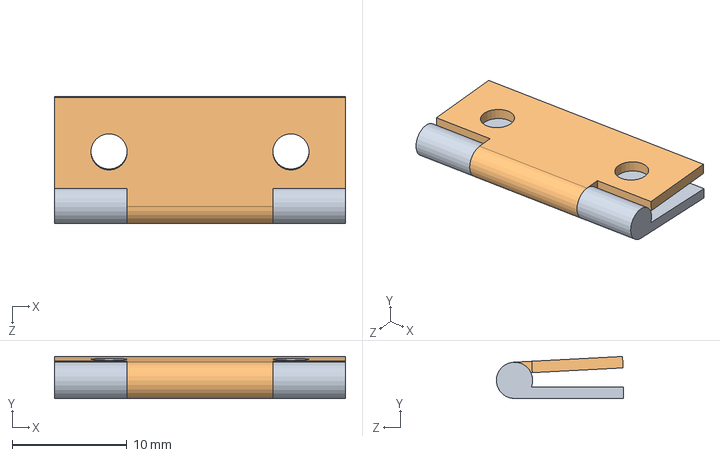
[picture p59: CAD file, 2019-03-11]
Solución/Diseño Máquina/Tolvas Romana/Hinge/HingeAsm.SLDASM
25.4 x 3.67 x 11.1 mm
Hinger1
Hinger2
