steveamena/Graduacion/Solución/Diseño Mecánico/Diseños conceptuales/Propuesta 1/Idea1.SLDASM

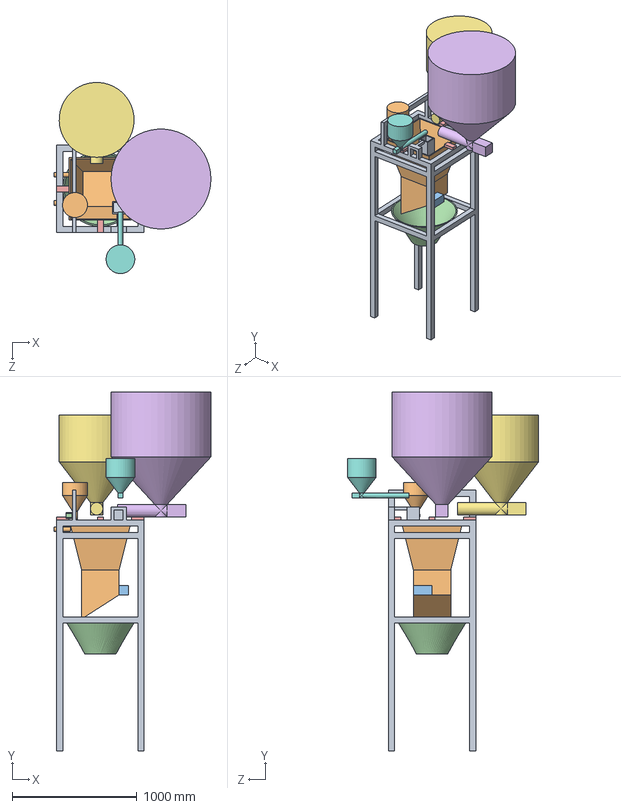
[picture p60: CAD file, 2018-10-02]
Solución/Diseño Mecánico/Diseños conceptuales/Propuesta 1/Idea1.SLDASM
1256.3 x 2874.9 x 1530.8 mm
Bastidor
TolvaGeneral
MotorCompuerta
Cono
Celda de Carga x 4
Tolva Concentrado
Tolva Adicional
Tolva Mineral
Esclusa Mineral
Tolva Levadura
Tambor Rotatorio
Stepper Motor
