steveamena/Graduacion/Solución/Diseño Mecánico/Diseños conceptuales/Propuesta 2/Piston/Piston Ensamble.SLDASM

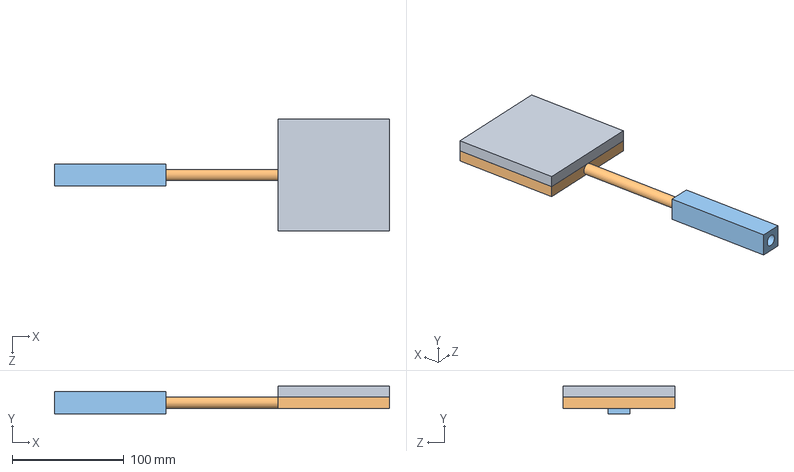
[picture p61: CAD file, 2018-10-02]
Solución/Diseño Mecánico/Diseños conceptuales/Propuesta 2/Piston/Piston Ensamble.SLDASM
300.0 x 25.0 x 100.0 mm
Compuerta Fija
Compuerta Deslizante
Piston
