steveamena/Graduacion/Solución/Diseño Máquina/Esclusas finos/A Hinge.SLDASM

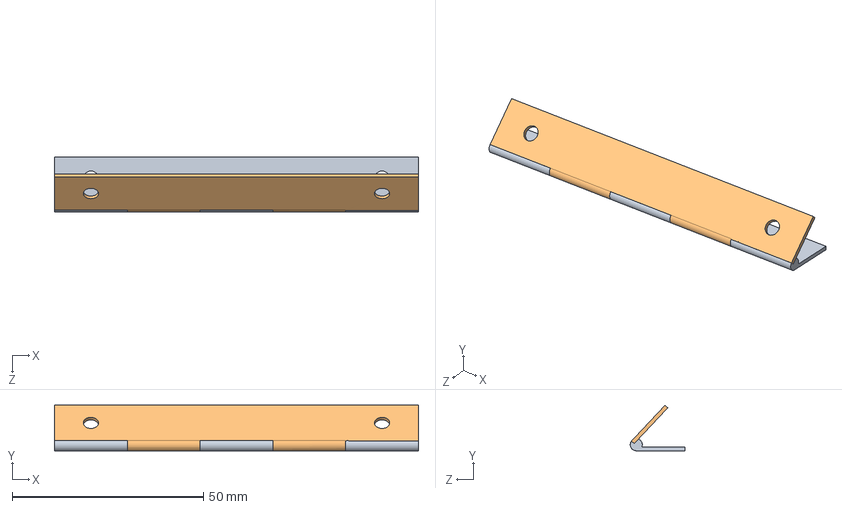
[picture p62: CAD file, 2019-05-12]
Solución/Diseño Máquina/Esclusas finos/A Hinge.SLDASM
95.3 x 11.9 x 14.3 mm
Hinge1
Hinge2
