steveamena/Graduacion/Solución/Diseño Máquina/Tolvas Romana/HingeAsm.SLDASM

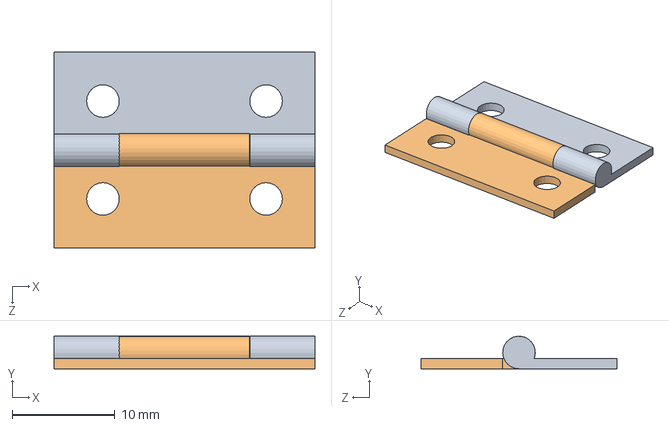
[picture p63: CAD file, 2019-05-08]
Solución/Diseño Máquina/Tolvas Romana/HingeAsm.SLDASM
25.4 x 3.17 x 19.1 mm
Hinger1
Hinger2
