steveamena/Graduacion/Solución/Diseño Mecánico/Caja Neumatica/Esclusa mineral.SLDASM

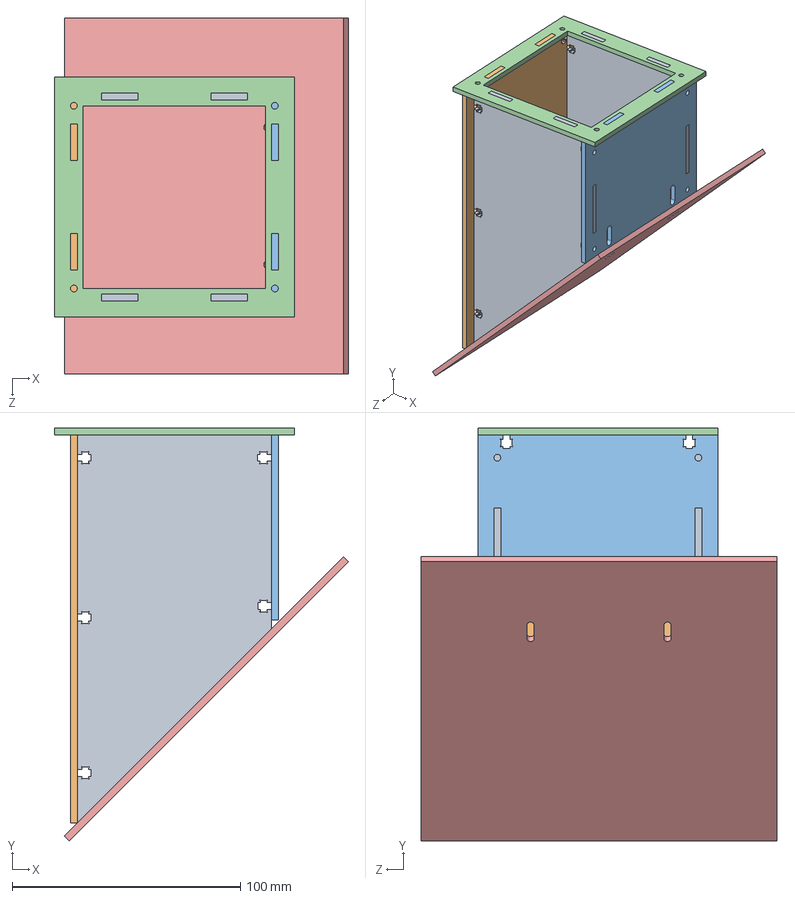
[picture p64: CAD file, 2019-02-25]
Solución/Diseño Mecánico/Caja Neumatica/Esclusa mineral.SLDASM
128.8 x 180.8 x 156.0 mm
Frente x 2
Derecha
Izquierda
Superior
Piso
