steveamena/Graduacion/Solución/Diseño Mecánico/Diseños conceptuales/Propuesta prototipo construcción/Dosificador concentrado/Tornillo sin Fin Concentrado.SLDASM

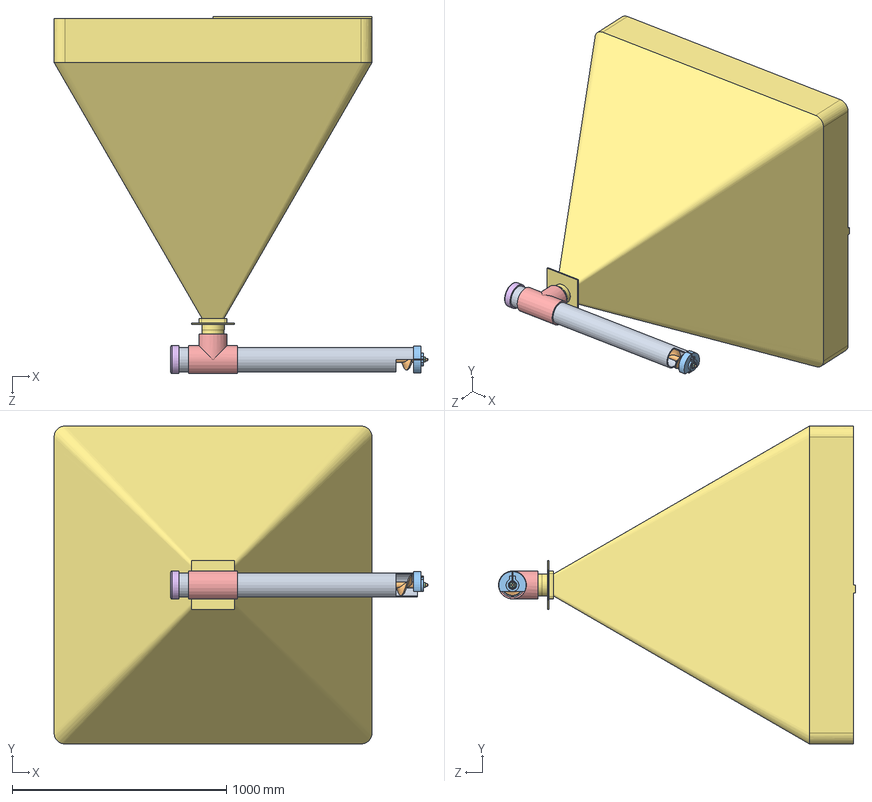
[picture p65: CAD file, 2019-02-25]
Solución/Diseño Mecánico/Diseños conceptuales/Propuesta prototipo construcción/Dosificador concentrado/Tornillo sin Fin Concentrado.SLDASM
1744.5 x 1483.6 x 1665.9 mm
Tubo Principal
TSF Concentrado
YAR 203_12-2F-24
Union Tee SCH40 4 in
Tapa PVC 4 in SCH40
Tolva Concentrado
