steveamena/Graduacion/Solución/Diseño Mecánico/Esclusas/Concentrado/asmConc.SLDASM

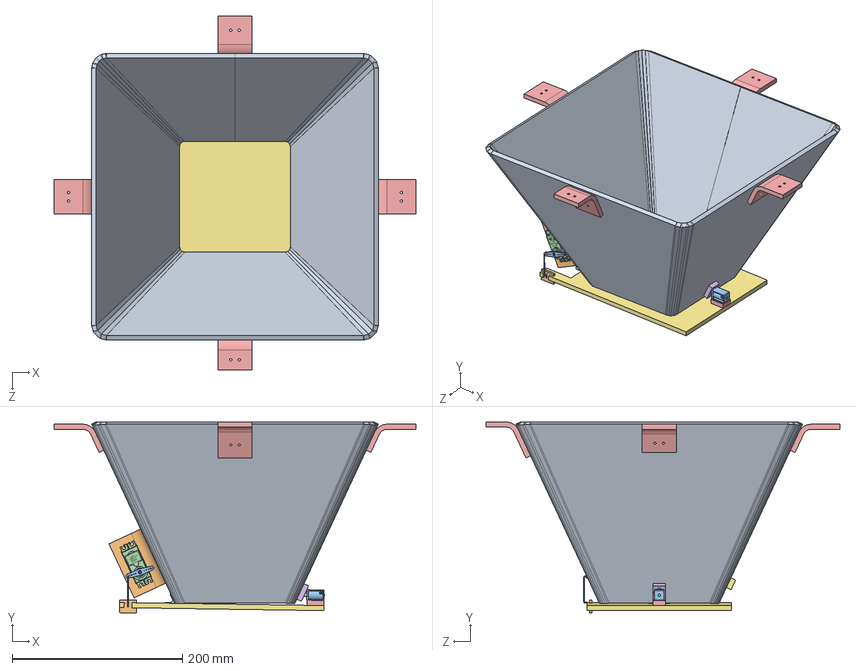
[picture p66: CAD file, 2018-09-04]
Solución/Diseño Mecánico/Esclusas/Concentrado/asmConc.SLDASM
424.5 x 224.3 x 415.7 mm
EscConc
EscConcSujecionServo
ServoHorn
EscConcServo
EscConcSoporteCelda x 4
EscConcPin
EscConcCompuerta
Hinger1
Hinger2
MinEscUnion
Solenoid A Body
Solenoid A Shaft PLastic Tip Wide
EscConcSoporteSolenoide
EscConcIngresoSolenoide
EscConcUnionTolva
