steveamena/Graduacion/Solución/Diseño Mecánico/Transportadores/Concentrado/Tornillo sin Fin Concentrado.SLDASM

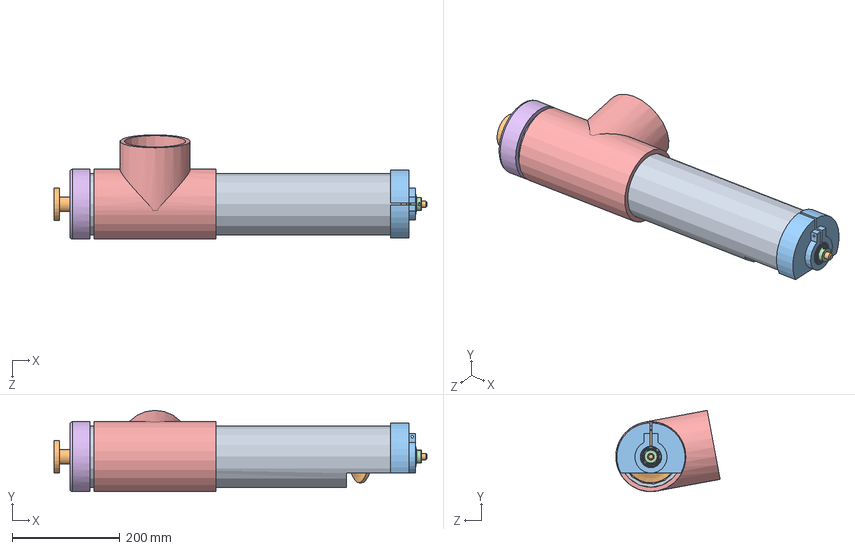
[picture p67: CAD file, 2018-11-02]
Solución/Diseño Mecánico/Transportadores/Concentrado/Tornillo sin Fin Concentrado.SLDASM
694.0 x 151.3 x 194.1 mm
Tubo Principal
TSF Concentrado
Tapa Tubo
YAR 203_12-2F-24
Union Tee SCH40 4 in
Tapa PVC 4 in SCH40
