steveamena/Graduacion/Solución/Diseño Mecánico/Esclusas/Caja Rosita/EnsamblajeCaja.SLDASM

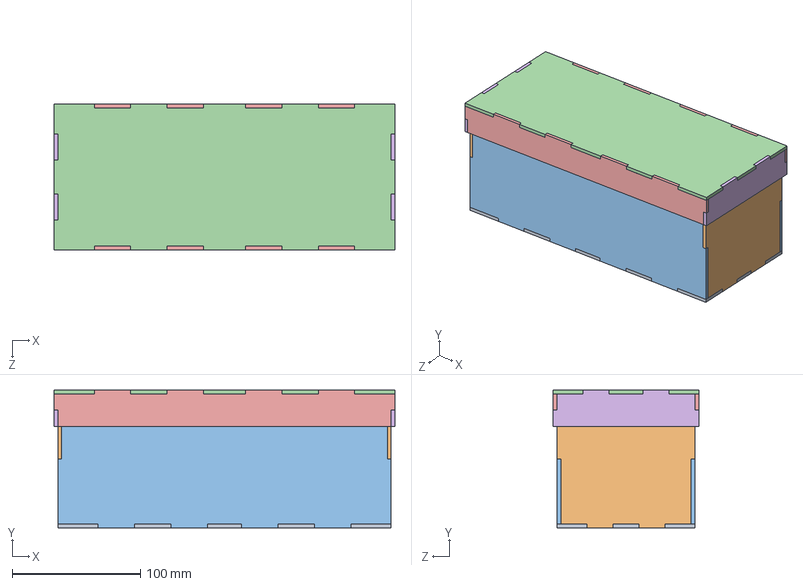
[picture p68: CAD file, 2018-09-20]
Solución/Diseño Mecánico/Esclusas/Caja Rosita/EnsamblajeCaja.SLDASM
266.0 x 107.6 x 113.6 mm
CajaInferior
FrontalCaja x 2
LateralCaja x 2
TapaSuperior
LateralTapa x 2
FrontalTapa x 2
