steveamena/Graduacion/Solución/Diseño Mecánico/Caja Neumatica/cAJA ENSAMBLE.SLDASM

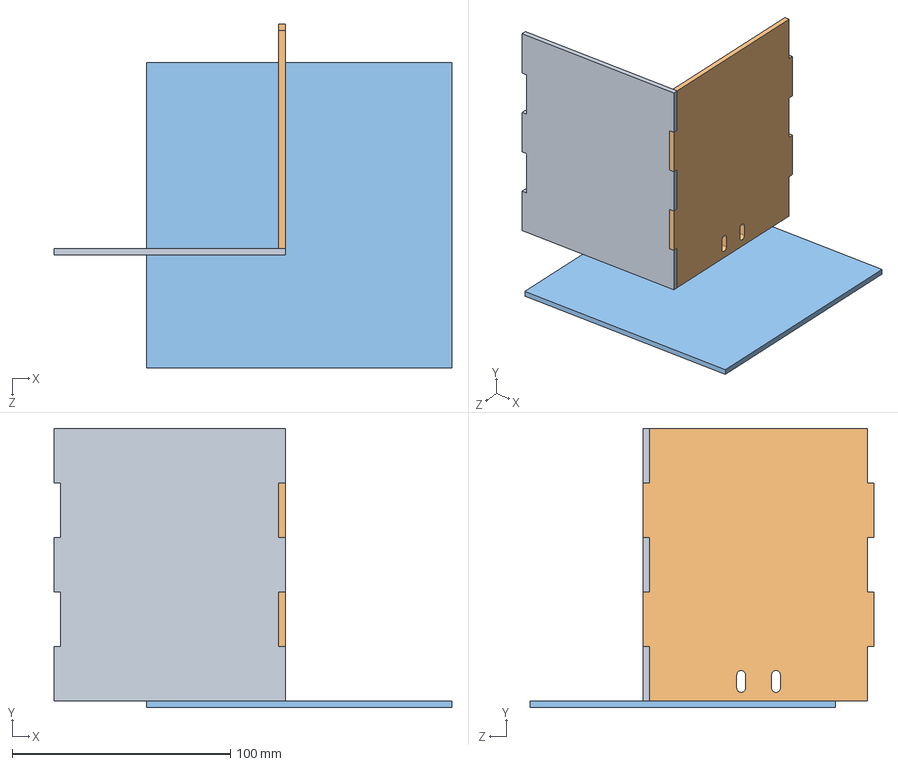
[picture p69: CAD file, 2019-02-25]
Solución/Diseño Mecánico/Caja Neumatica/cAJA ENSAMBLE.SLDASM
182.4 x 128.0 x 157.8 mm
Frente
Lados
Tapa
