steveamena/Graduacion/Solución/Diseño Mecánico/Diseños conceptuales/Propuesta final Contenedores Angulo/A Concentrado.SLDASM

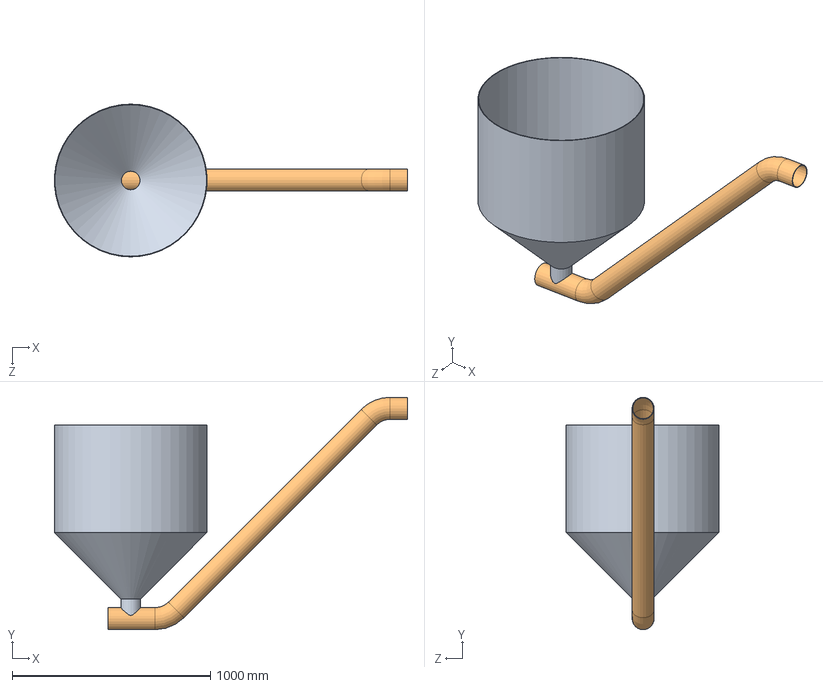
[picture p70: CAD file, 2018-11-02]
Solución/Diseño Mecánico/Diseños conceptuales/Propuesta final Contenedores Angulo/A Concentrado.SLDASM
1780.2 x 1171.8 x 770.6 mm
Tolva Concentrado Angulo
TSF Angulo
