steveamena/Graduacion/Solución/Diseño Mecánico/Esclusas/Adicional/asmAdic.SLDASM

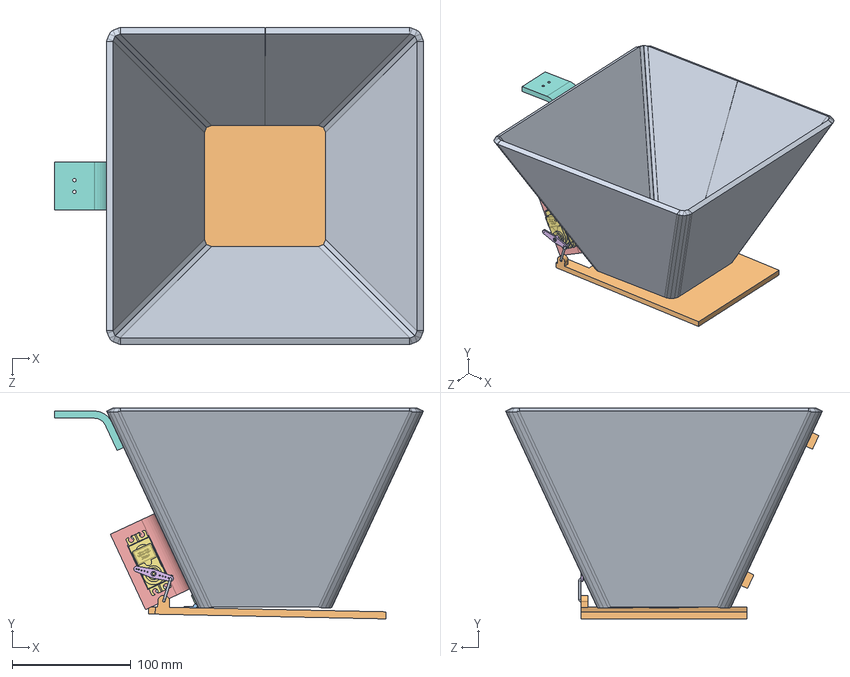
[picture p71: CAD file, 2018-09-04]
Solución/Diseño Mecánico/Esclusas/Adicional/asmAdic.SLDASM
310.7 x 177.5 x 266.9 mm
EscAdic
EscAdicCompuerta
Hinger1
Hinger2
EscAdicSujecionServo
ServoHorn
EscAdicServo
EscAdicSoporteCelda
EscAdicPin
EscAdicUnionTolva x 2
