steveamena/Graduacion/Solución/Diseño Mecánico/Esclusas/Levadura/asmLevEsc.SLDASM

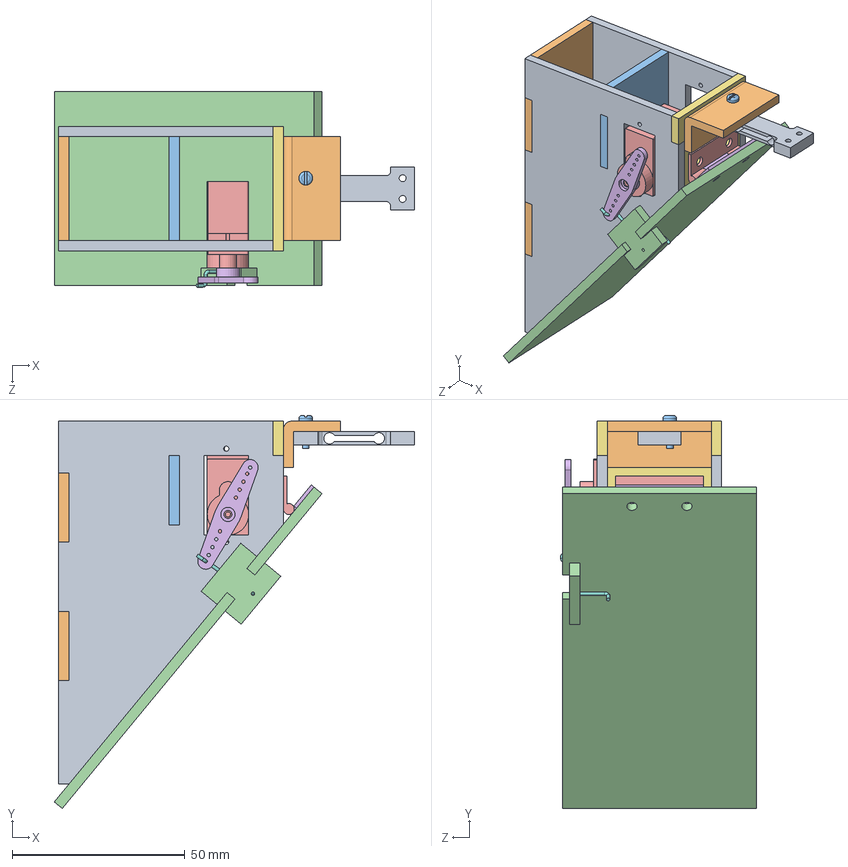
[picture p72: CAD file, 2018-09-20]
Solución/Diseño Mecánico/Esclusas/Levadura/asmLevEsc.SLDASM
104.2 x 113.6 x 56.5 mm
LevEscLateral x 2
LevEscFrontal
LevEscCompuerta
micro servo
ServoHorn
LevEscPin
LevCelCarga
LevEscSoporte
LevEscUnion
Hinger1
Hinger2
