steveamena/Graduacion/Solución/Diseño Mecánico/Transportadores/Transportador.SLDASM

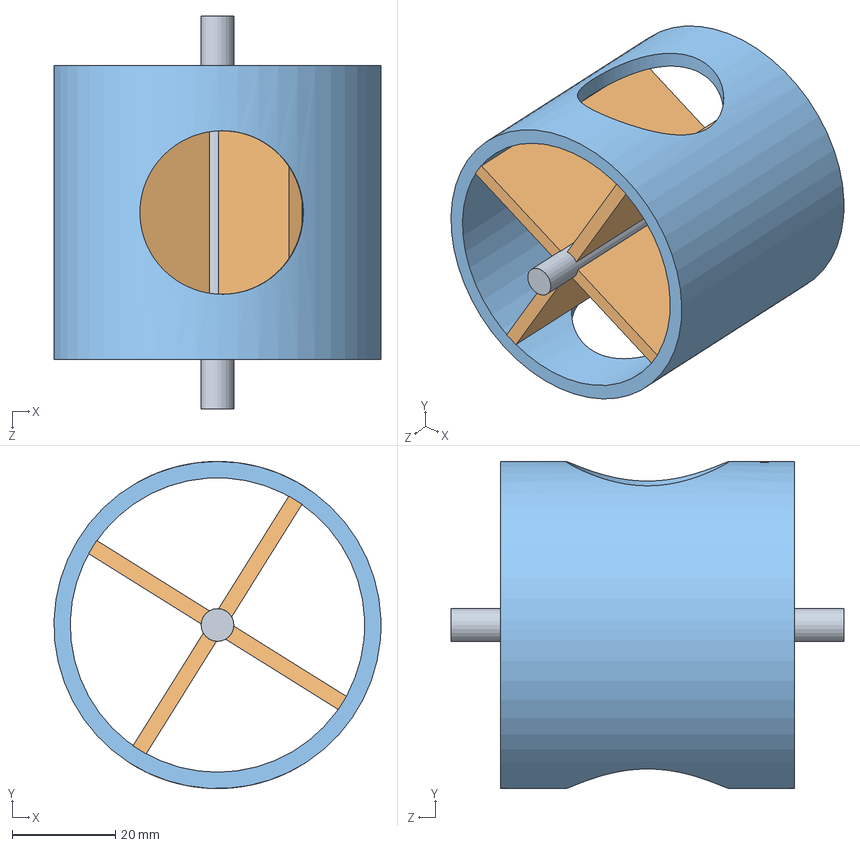
[picture p73: CAD file, 2018-09-04]
Solución/Diseño Mecánico/Transportadores/Transportador.SLDASM
63.5 x 63.5 x 76.2 mm
ConcArbol
ConcPaleta x 4
ConcCarcasa
