steveamena/Graduacion/Solución/Diseño Máquina/Tolvas Romana/E Tolva Romana.SLDASM

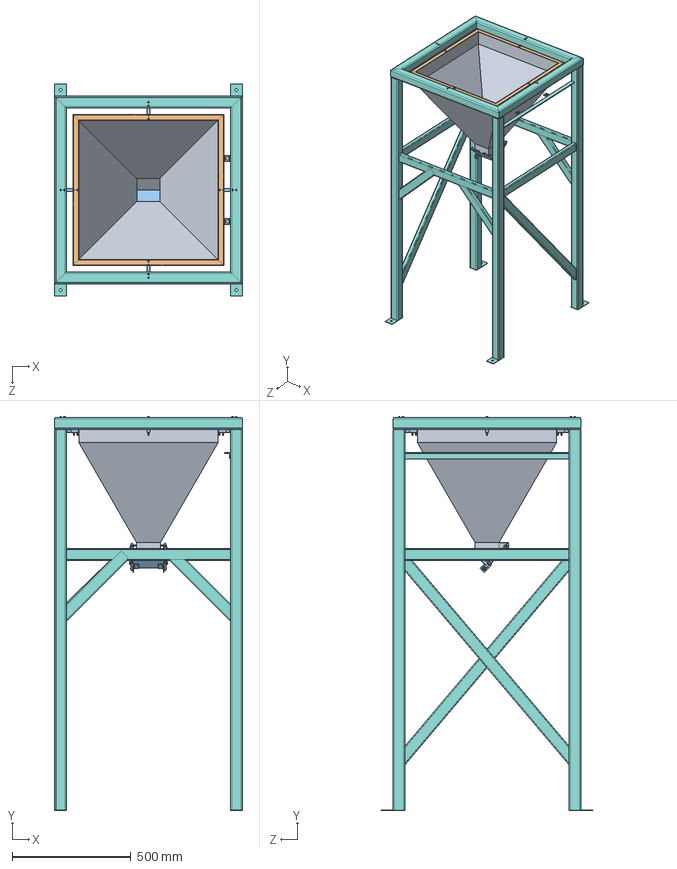
[picture p74: CAD file, 2019-05-08]
Solución/Diseño Máquina/Tolvas Romana/E Tolva Romana.SLDASM
790.6 x 1656.8 x 892.2 mm
Tolva Romana
Marco Superior
Tapa Inferior
16N2A10A050 Cilindro x 2
16N2A10A050 Piston x 2
Tuerca Piston x 2
Rotula para vástago x 2
Bastidor
Pasador Pistón x 2
basic external retaining ring_am x 10
Tal 220 x 4
socket head cap screw_am x 16
spring lock washer 2_din2 x 17
hex nut style 1_am2 x 16
Hinger1 x 2
Hinger2 x 2
