steveamena/Graduacion/Solución/Diseño Mecánico/Diseños conceptuales/Propuesta prototipo construcción/Ensamble levadura/A Levadura.SLDASM

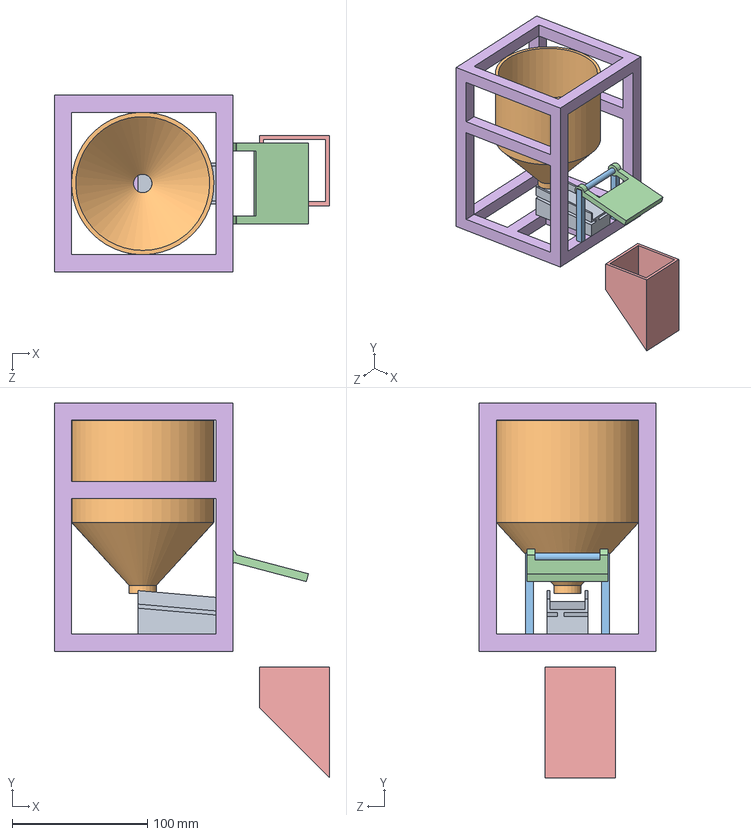
[picture p75: CAD file, 2018-10-02]
Solución/Diseño Mecánico/Diseños conceptuales/Propuesta prototipo construcción/Ensamble levadura/A Levadura.SLDASM
203.4 x 277.0 x 130.6 mm
Vibrador
Contenedor Levadura
Superior Marco
Superior Stop
Tolva Levadura
Bastidor
