steveamena/Graduacion/Solución/Diseño Mecánico/Esclusas/Mineral 2/CompuertaAsm.SLDASM

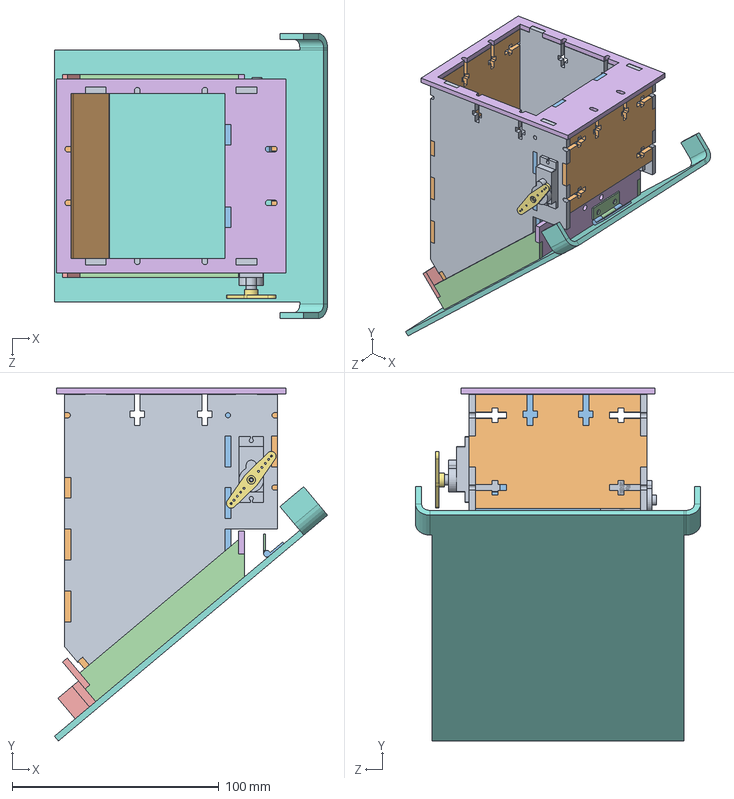
[picture p76: CAD file, 2019-02-25]
Solución/Diseño Mecánico/Esclusas/Mineral 2/CompuertaAsm.SLDASM
132.2 x 170.8 x 138.0 mm
Lateral x 2
Frontal
Trasera
O-ring Collar lateral x 2
O-ring Collar Frontal
O-ring collar trasero
Base O-ring x 4
micro servo x 2
Servo Trasero
Hinger1
Hinger2
Resbalon MAgnético
Tapa Superior
ServoHorn 2
