steveamena/Graduacion/Solución/Diseño Mecánico/Diseños conceptuales/Propuesta prototipo construcción/Plumber Block Assembly.SLDPRT

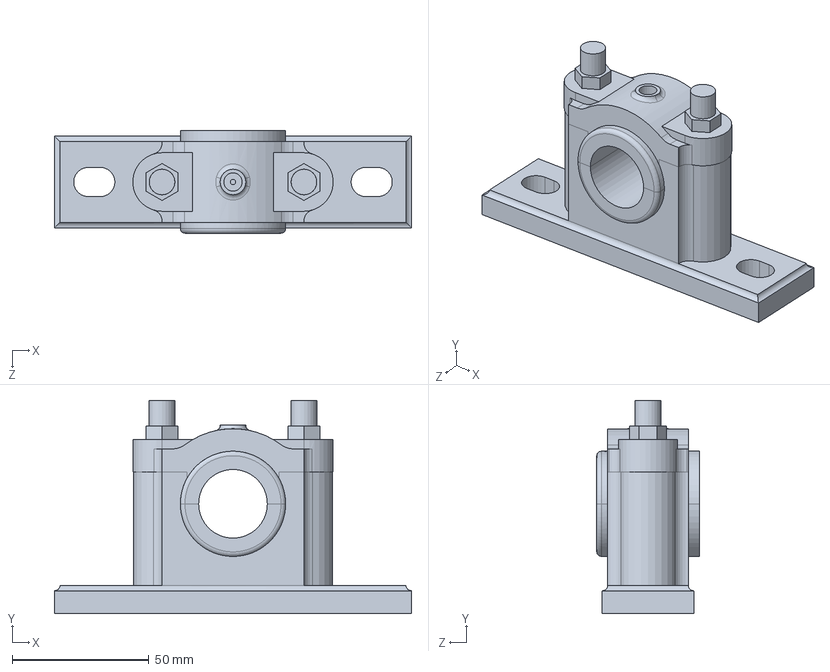
[picture p77: CAD file, 2019-02-25]
Solución/Diseño Mecánico/Diseños conceptuales/Propuesta prototipo construcción/Plumber Block Assembly.SLDPRT
130.3 x 77.9 x 37.4 mm
