steveamena/Graduacion/Solución/Diseño Máquina/Esclusas finos/E Lev Esclusa.SLDASM

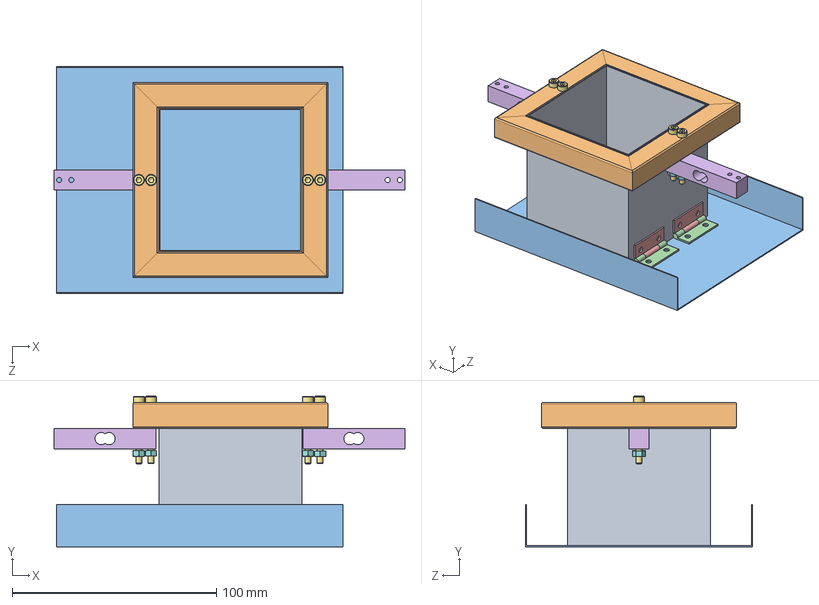
[picture p78: CAD file, 2019-05-08]
Solución/Diseño Máquina/Esclusas finos/E Lev Esclusa.SLDASM
171.7 x 73.6 x 111.2 mm
Lev Contenedor
Lev Bastidor
Lev Tapa
Hinger1 x 2
Hinger2 x 2
uxCell x 2
socket head cap screw_am x 4
hex nut style 2_am x 4
