steveamena/Graduacion/Solución/Diseño Mecánico/Esclusas/Mineral 2/O-ring collas asm.SLDASM

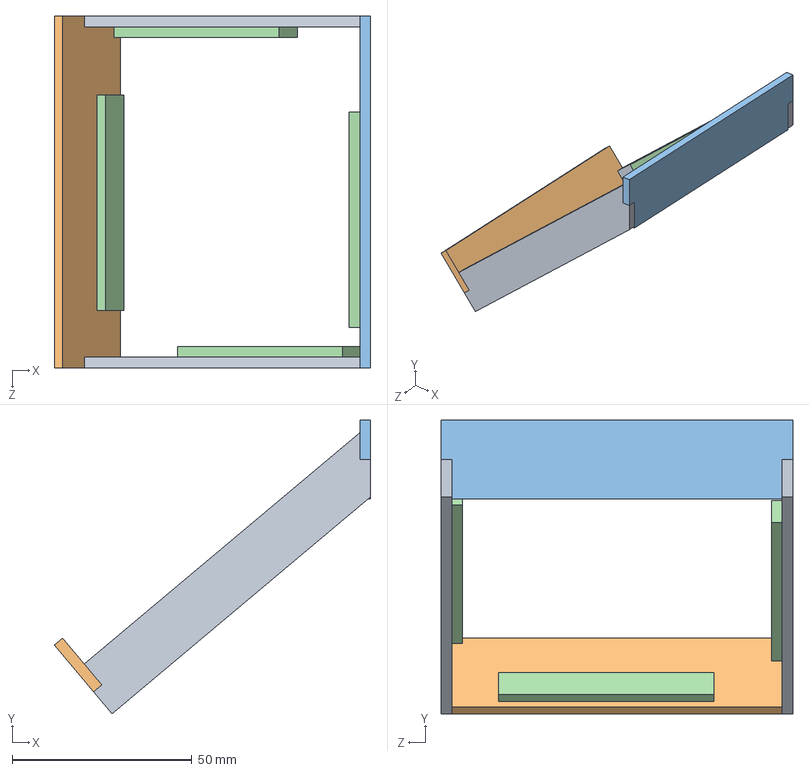
[picture p79: CAD file, 2019-02-25]
Solución/Diseño Mecánico/Esclusas/Mineral 2/O-ring collas asm.SLDASM
88.1 x 81.8 x 98.0 mm
O-ring Collar lateral x 2
O-ring Collar Frontal
O-ring collar trasero
Base O-ring x 4
