steveamena/Graduacion/Solución/Diseño Mecánico/Diseños conceptuales/Propuesta prototipo construcción/A General.SLDASM

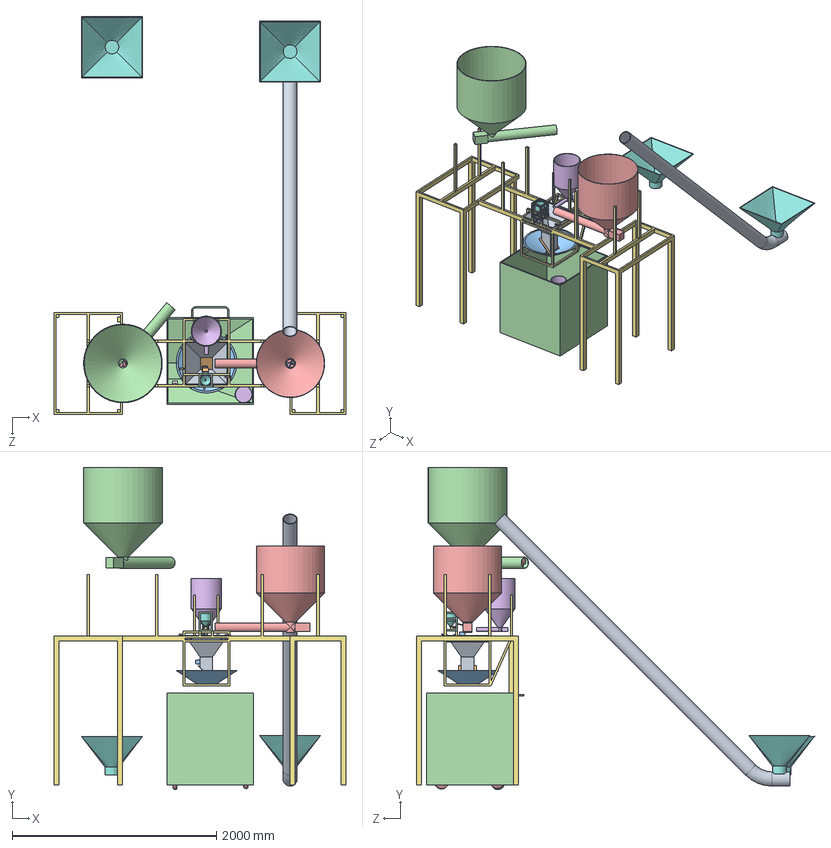
[picture p80: CAD file, 2018-11-02]
Solución/Diseño Mecánico/Diseños conceptuales/Propuesta prototipo construcción/A General.SLDASM
2858.0 x 3156.2 x 3897.4 mm
Tolva Romana
Base Romana
Stepper Motor
Tolva Concentrado
Tolva Adicional
Tolva Mineral
Vibrador
Contenedor Levadura
Superior Marco
Superior Stop
Tolva Levadura
Bastidor
TSF Concentrado
TSF Adicional
Armazon
Recibidor x 2
Celda de Carga x 4
Cono
BaseCarro
Ruedas x 4
Tubo Contenedor
