steveamena/Graduacion/Solución/Diseño Mecánico/Diseños conceptuales/Propuesta prototipo construcción/Dosificadora Levadura.SLDASM

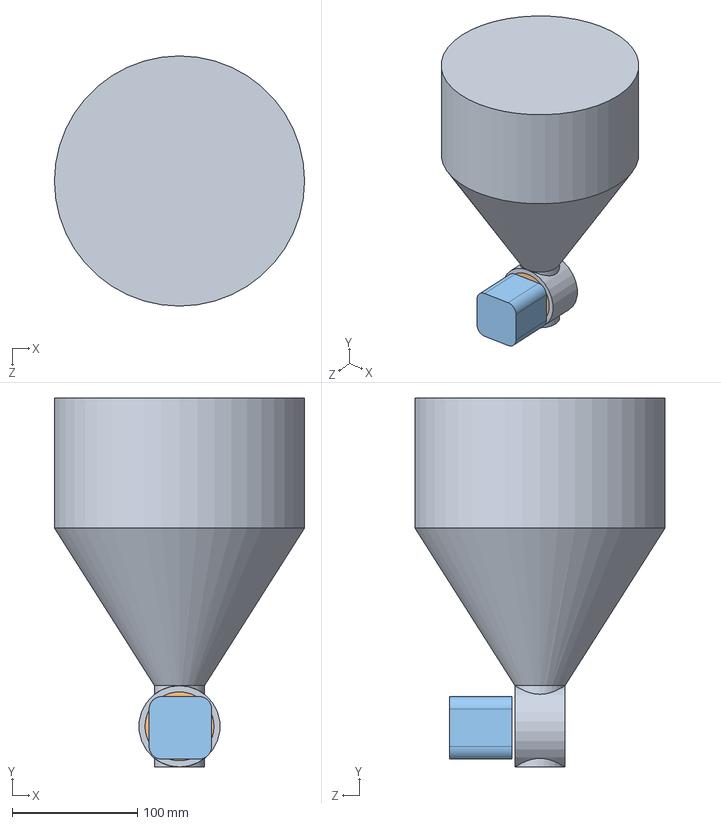
[picture p81: CAD file, 2018-10-02]
Solución/Diseño Mecánico/Diseños conceptuales/Propuesta prototipo construcción/Dosificadora Levadura.SLDASM
200.0 x 295.0 x 200.0 mm
Tolva Levadura
Tambor Rotatorio
Stepper Motor
