steveamena/Graduacion/Resultados/Tolva Romana/Tolva Romana.SLDPRT

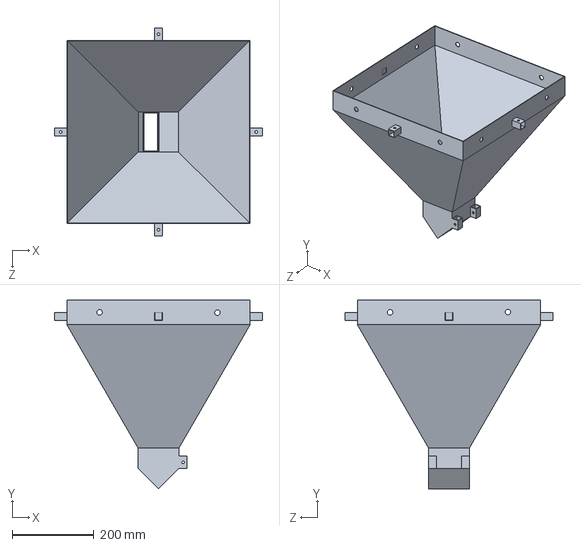
[picture p82: CAD file, 2019-02-25]
Resultados/Tolva Romana/Tolva Romana.SLDPRT
507.9 x 461.3 x 507.9 mm
