steveamena/Graduacion/Solución/Diseño Mecánico/Caja Neumatica/Tolva Acero Inoxidable.SLDPRT

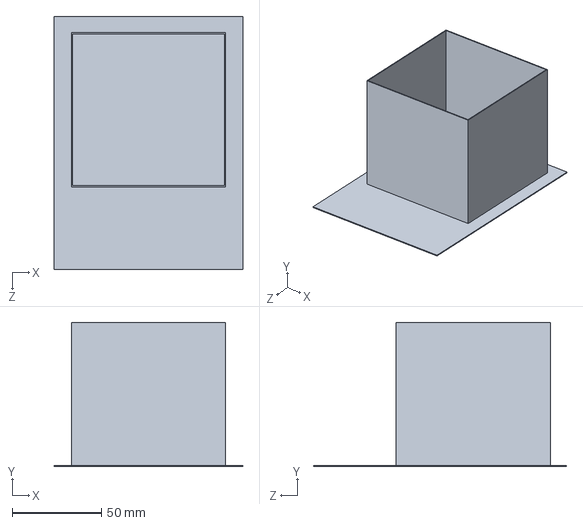
[picture p83: CAD file, 2019-03-14]
Solución/Diseño Mecánico/Caja Neumatica/Tolva Acero Inoxidable.SLDPRT
105.5 x 80.6 x 141.6 mm
