steveamena/Graduacion/Solución/Diseño Mecánico/Diseños conceptuales/Propuesta 2/Piston Pequeño/Compuerta Fija Pequeña.SLDPRT

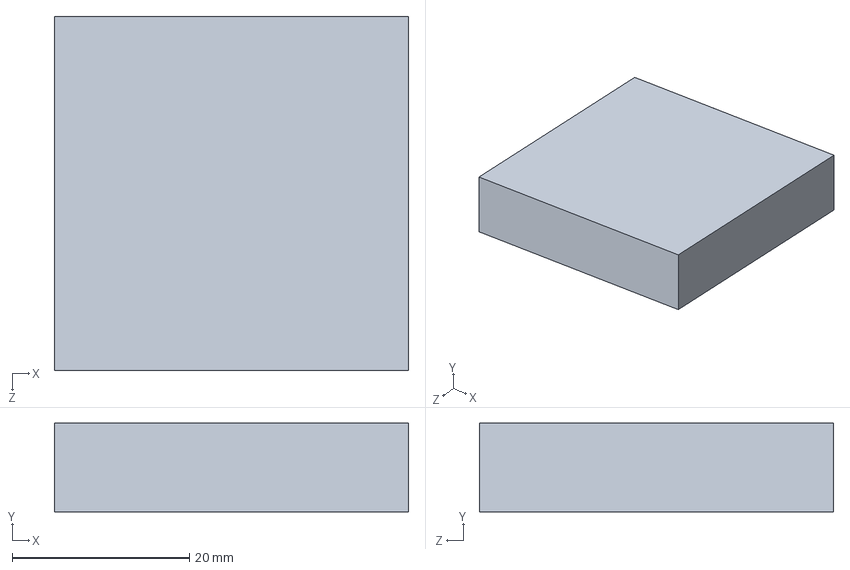
[picture p84: CAD file, 2018-10-02]
Solución/Diseño Mecánico/Diseños conceptuales/Propuesta 2/Piston Pequeño/Compuerta Fija Pequeña.SLDPRT
40.0 x 10.0 x 40.0 mm
