steveamena/Graduacion/Solución/Diseño Mecánico/Diseños conceptuales/Propuesta 2/Piston/Piston.SLDPRT

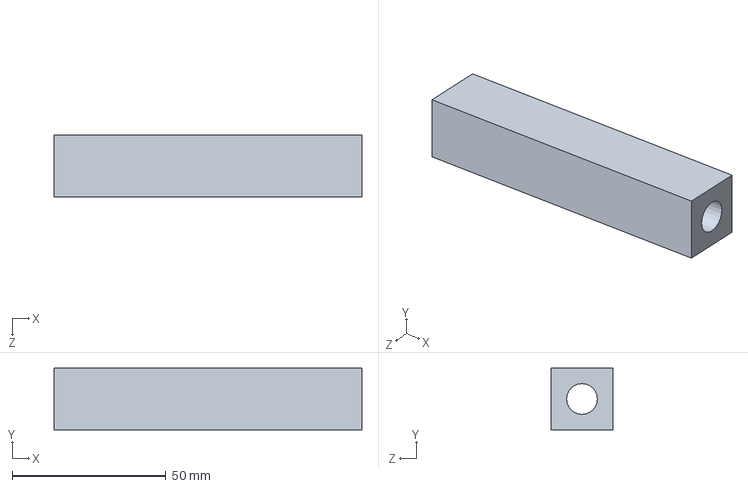
[picture p85: CAD file, 2018-10-02]
Solución/Diseño Mecánico/Diseños conceptuales/Propuesta 2/Piston/Piston.SLDPRT
100.0 x 20.0 x 20.0 mm
