steveamena/Graduacion/Solución/Diseño Mecánico/Diseños conceptuales/Propuesta final Contenedores Angulo/Adicional/TSF Angulo Adicional.SLDPRT

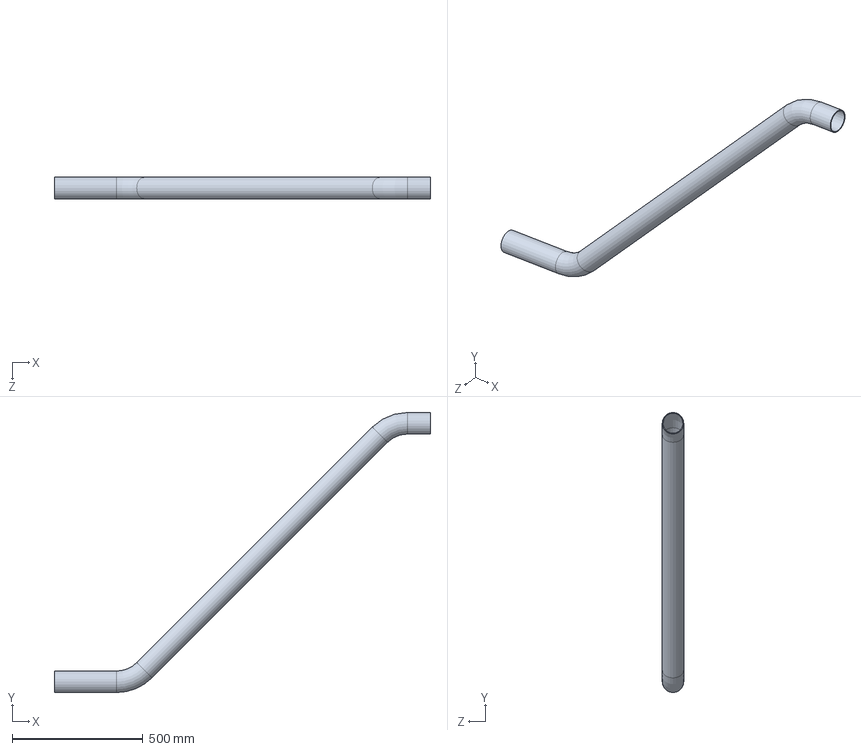
[picture p86: CAD file, 2018-11-02]
Solución/Diseño Mecánico/Diseños conceptuales/Propuesta final Contenedores Angulo/Adicional/TSF Angulo Adicional.SLDPRT
1439.9 x 1072.5 x 82.5 mm
