steveamena/Graduacion/Solución/Diseño Mecánico/Diseños conceptuales/Propuesta final Contenedores Angulo/Concentrado/TSF Angulo.SLDPRT

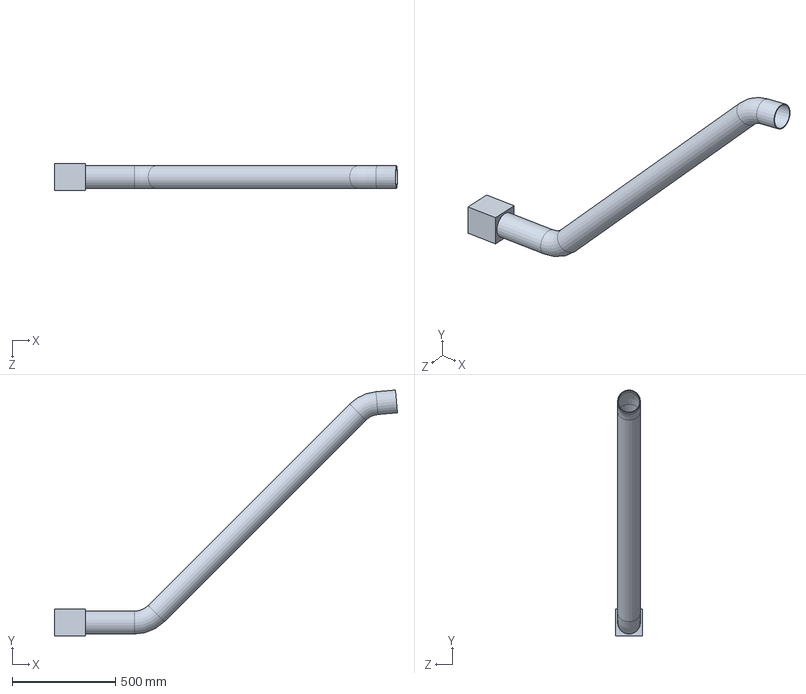
[picture p87: CAD file, 2018-11-02]
Solución/Diseño Mecánico/Diseños conceptuales/Propuesta final Contenedores Angulo/Concentrado/TSF Angulo.SLDPRT
1664.9 x 1194.1 x 130.0 mm
