steveamena/Graduacion/Solución/Diseño Mecánico/Diseños conceptuales/Propuesta final Contenedores Angulo/Tolva Mineral.SLDPRT

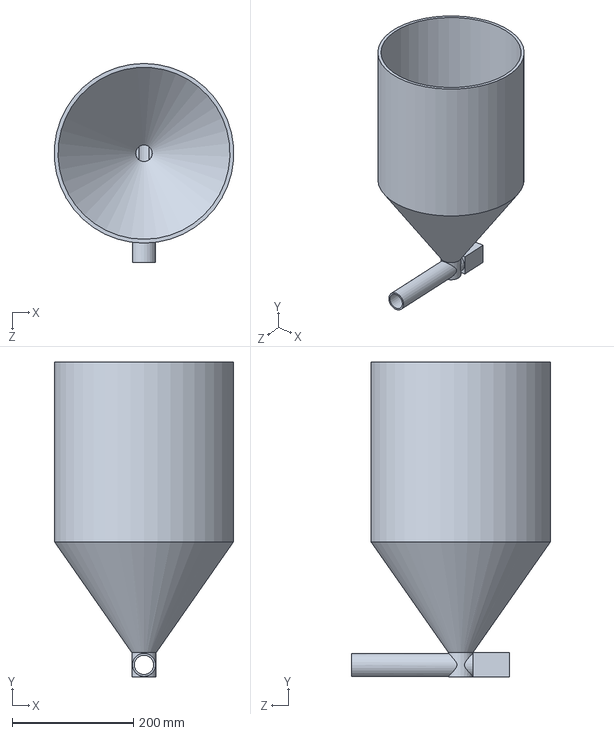
[picture p88: CAD file, 2018-11-02]
Solución/Diseño Mecánico/Diseños conceptuales/Propuesta final Contenedores Angulo/Tolva Mineral.SLDPRT
295.2 x 519.0 x 328.0 mm
