steveamena/Graduacion/Solución/Diseño Mecánico/Diseños conceptuales/Propuesta prototipo construcción/Alternativa levadura/Carrete Medidas Levadura.SLDPRT

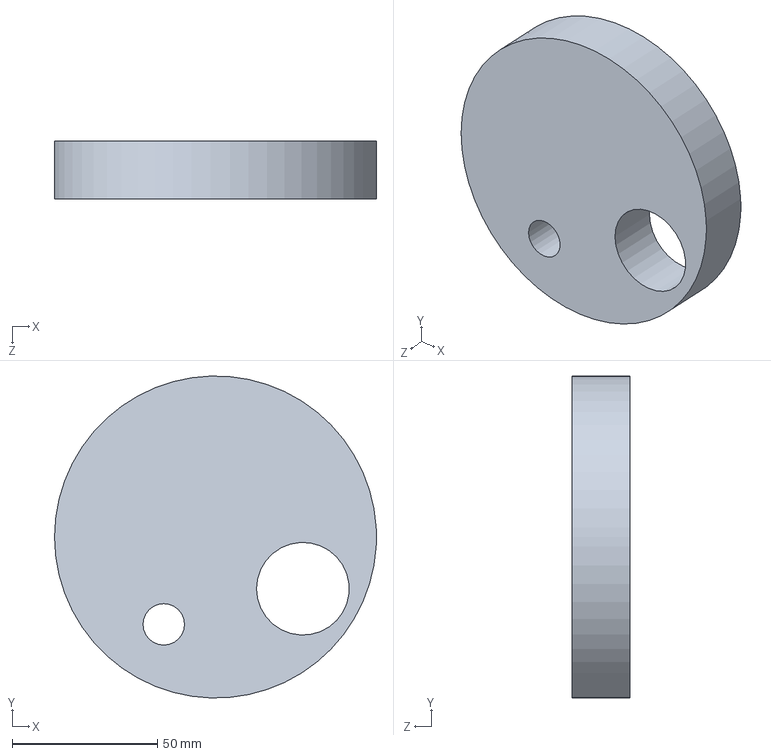
[picture p89: CAD file, 2018-10-02]
Solución/Diseño Mecánico/Diseños conceptuales/Propuesta prototipo construcción/Alternativa levadura/Carrete Medidas Levadura.SLDPRT
111.0 x 111.0 x 20.0 mm
