steveamena/Graduacion/Solución/Diseño Mecánico/Diseños conceptuales/Propuesta prototipo construcción/Dosificador concentrado/Tapa PVC 4 in SCH40.SLDPRT

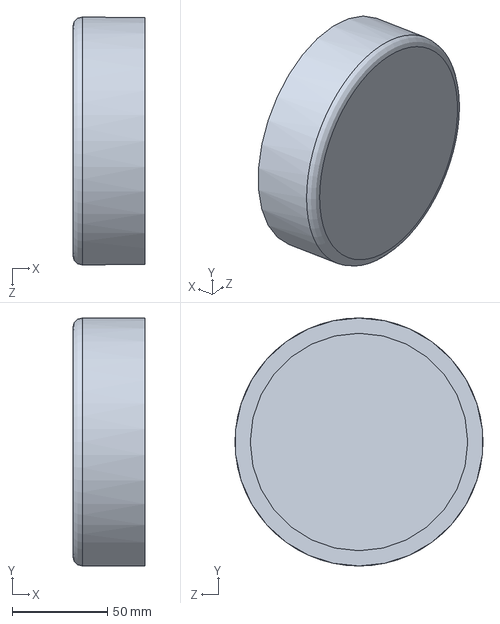
[picture p90: CAD file, 2019-02-25]
Solución/Diseño Mecánico/Diseños conceptuales/Propuesta prototipo construcción/Dosificador concentrado/Tapa PVC 4 in SCH40.SLDPRT
38.0 x 130.3 x 130.3 mm
