steveamena/Graduacion/Solución/Diseño Mecánico/Diseños conceptuales/Propuesta prototipo construcción/Ensamble levadura/Resorte Superior.SLDPRT

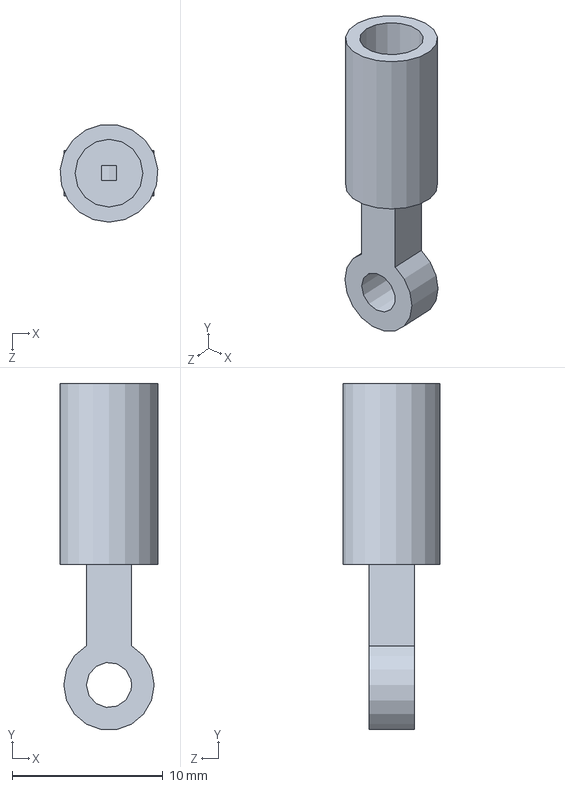
[picture p91: CAD file, 2018-10-02]
Solución/Diseño Mecánico/Diseños conceptuales/Propuesta prototipo construcción/Ensamble levadura/Resorte Superior.SLDPRT
6.48 x 23.0 x 6.46 mm
