steveamena/Graduacion/Solución/Diseño Mecánico/Diseños conceptuales/Propuesta prototipo construcción/Suministrador/Basuca.SLDPRT

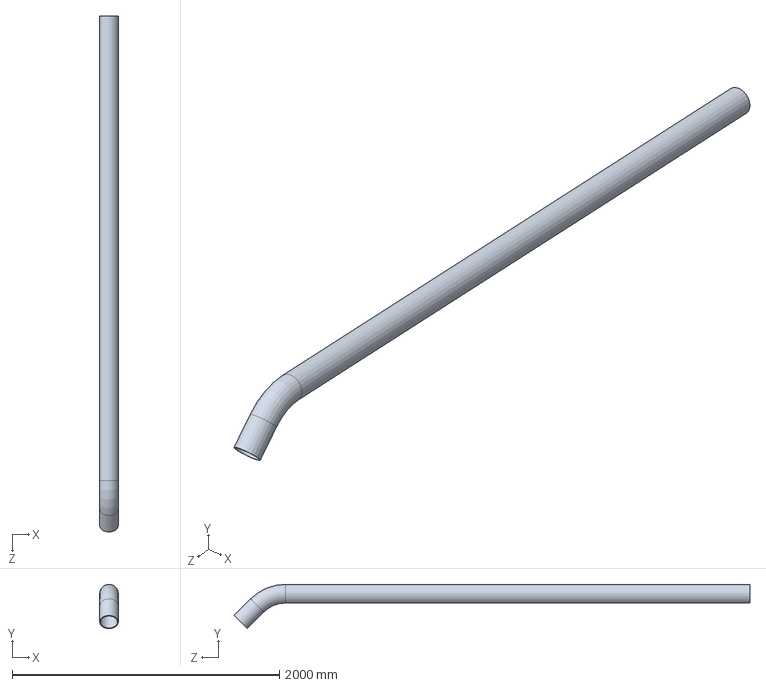
[picture p92: CAD file, 2018-10-03]
Solución/Diseño Mecánico/Diseños conceptuales/Propuesta prototipo construcción/Suministrador/Basuca.SLDPRT
139.7 x 331.4 x 3861.5 mm
