steveamena/Graduacion/Solución/Diseño Mecánico/Diseños conceptuales/Propuesta prototipo construcción/Tolva Adicional.SLDPRT

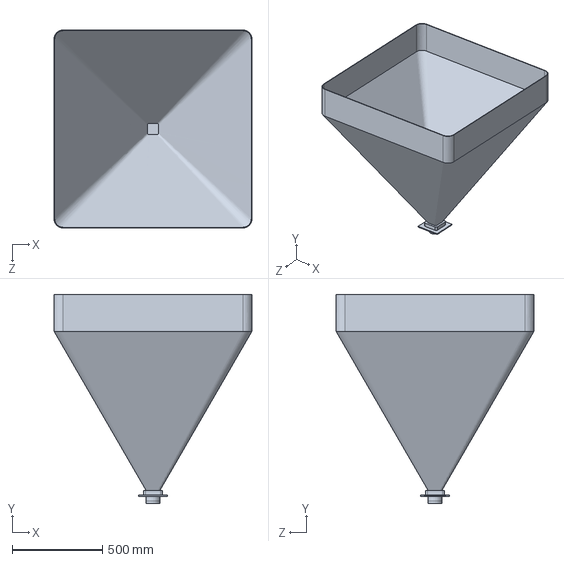
[picture p93: CAD file, 2019-02-25]
Solución/Diseño Mecánico/Diseños conceptuales/Propuesta prototipo construcción/Tolva Adicional.SLDPRT
1098.6 x 1161.6 x 1098.6 mm
