steveamena/Graduacion/Solución/Diseño Mecánico/Diseños conceptuales/Propuesta prototipo construcción/UberCow/BaseCarro.SLDPRT

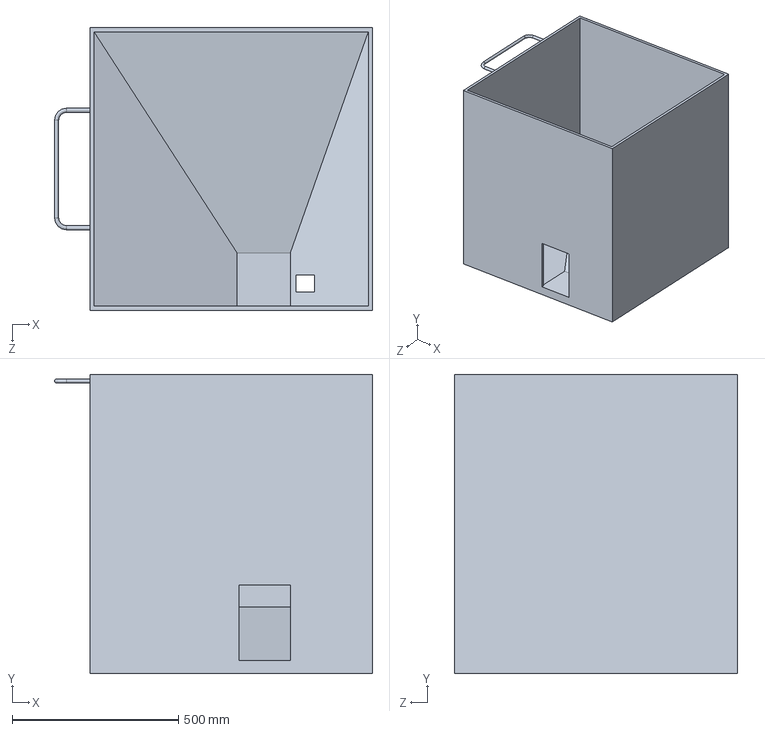
[picture p94: CAD file, 2018-10-03]
Solución/Diseño Mecánico/Diseños conceptuales/Propuesta prototipo construcción/UberCow/BaseCarro.SLDPRT
956.4 x 900.0 x 850.0 mm
