steveamena/Graduacion/Solución/Diseño Mecánico/Esclusas/Adicional/EscAdic.SLDPRT

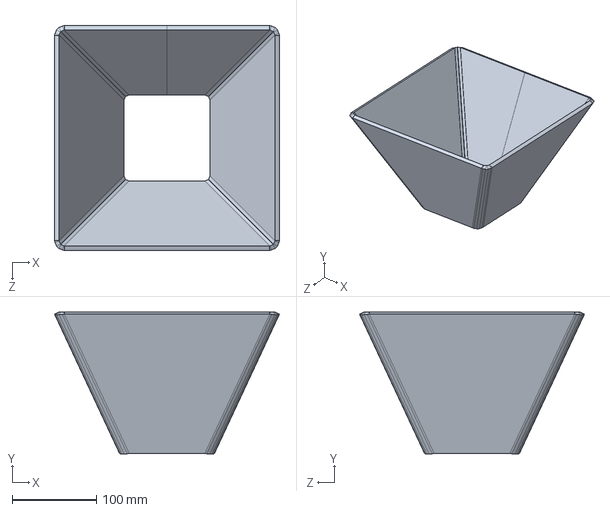
[picture p95: CAD file, 2018-09-04]
Solución/Diseño Mecánico/Esclusas/Adicional/EscAdic.SLDPRT
266.9 x 168.3 x 266.9 mm
