steveamena/Graduacion/Solución/Diseño Mecánico/Esclusas/Caja Rosita/CajaInferior.SLDPRT

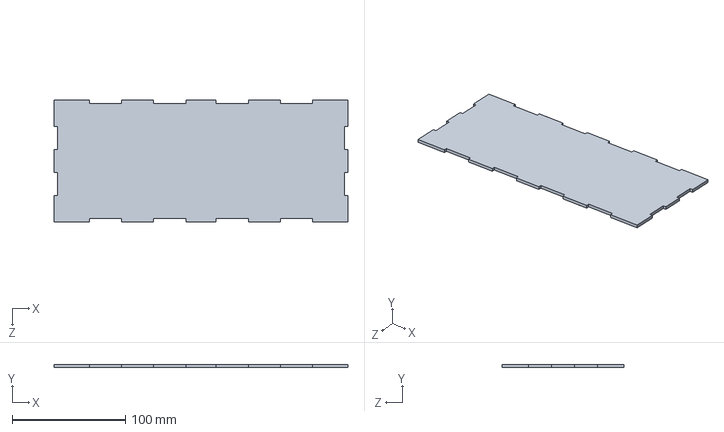
[picture p96: CAD file, 2018-09-20]
Solución/Diseño Mecánico/Esclusas/Caja Rosita/CajaInferior.SLDPRT
260.0 x 3.00 x 107.6 mm
