steveamena/Graduacion/Solución/Diseño Mecánico/Esclusas/Concentrado/EscConcDesarrollo.SLDPRT

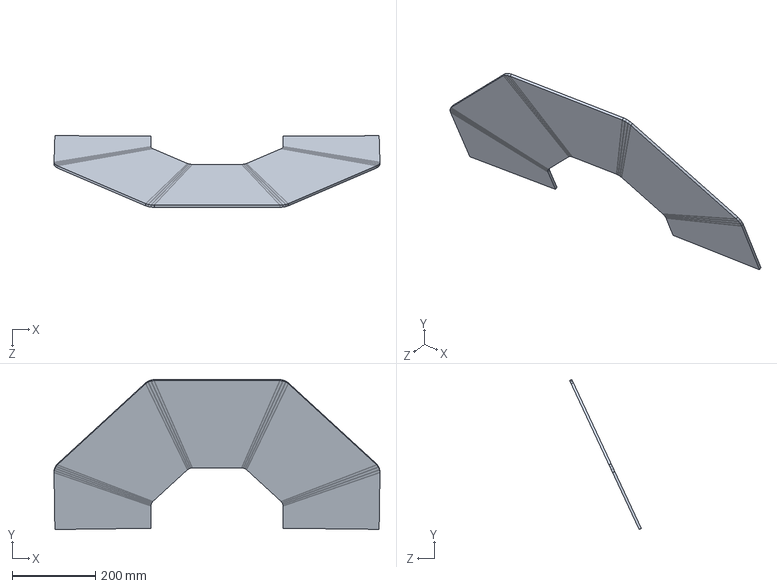
[picture p97: CAD file, 2018-09-04]
Solución/Diseño Mecánico/Esclusas/Concentrado/EscConcDesarrollo.SLDPRT
784.0 x 360.8 x 172.6 mm
