steveamena/Graduacion/Solución/Diseño Mecánico/Esclusas/Levadura/LevEscUnion.SLDPRT

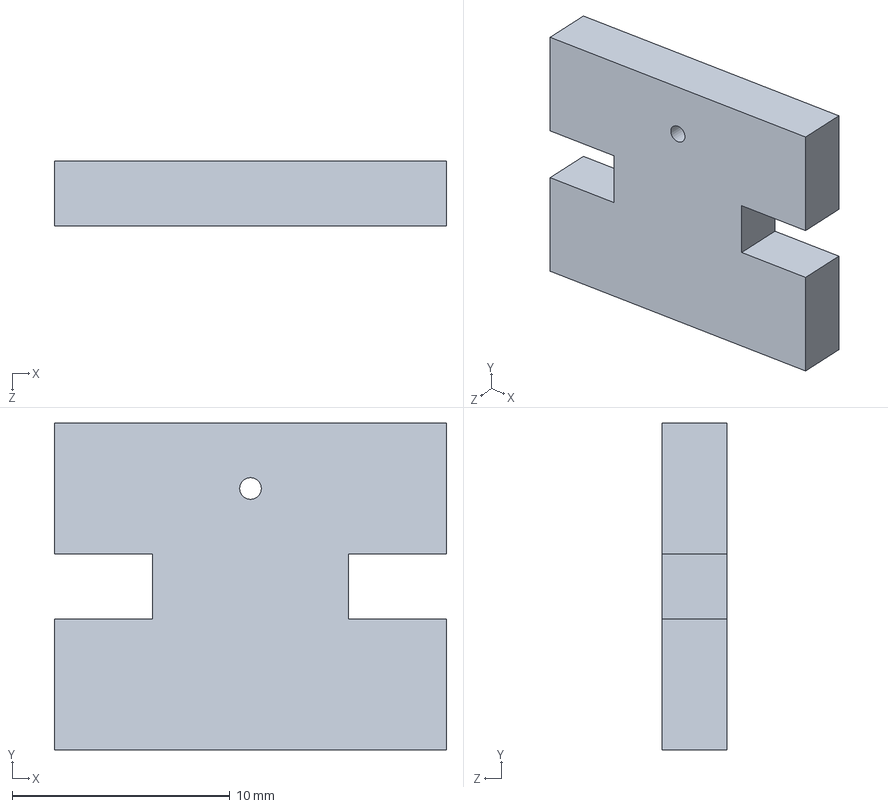
[picture p98: CAD file, 2018-09-20]
Solución/Diseño Mecánico/Esclusas/Levadura/LevEscUnion.SLDPRT
18.0 x 15.0 x 3.00 mm
