steveamena/Graduacion/Solución/Diseño Mecánico/Esclusas/Mineral 2/Trasera.SLDPRT

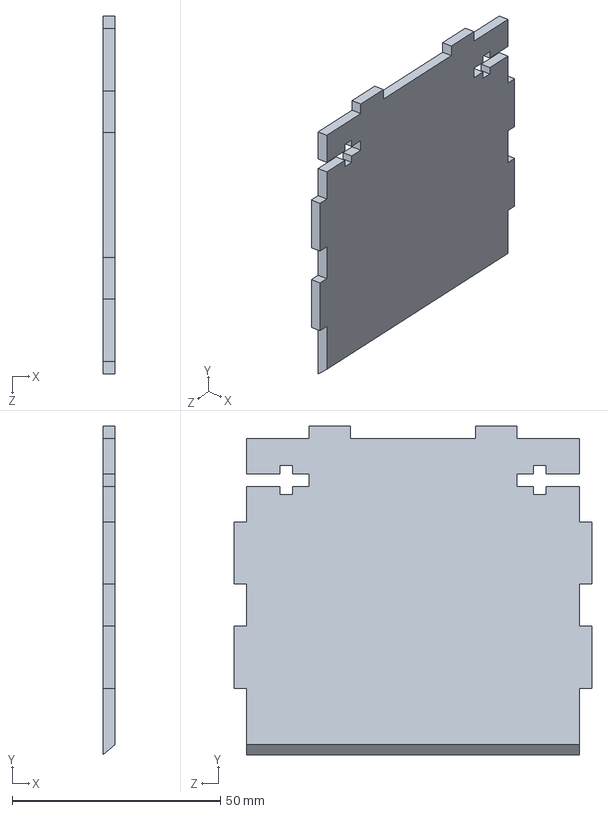
[picture p99: CAD file, 2019-02-25]
Solución/Diseño Mecánico/Esclusas/Mineral 2/Trasera.SLDPRT
3.00 x 79.0 x 86.0 mm
