steveamena/Graduacion/Solución/Diseño Mecánico/Transportadores/Adicional/4 TSF Adicional.SLDPRT

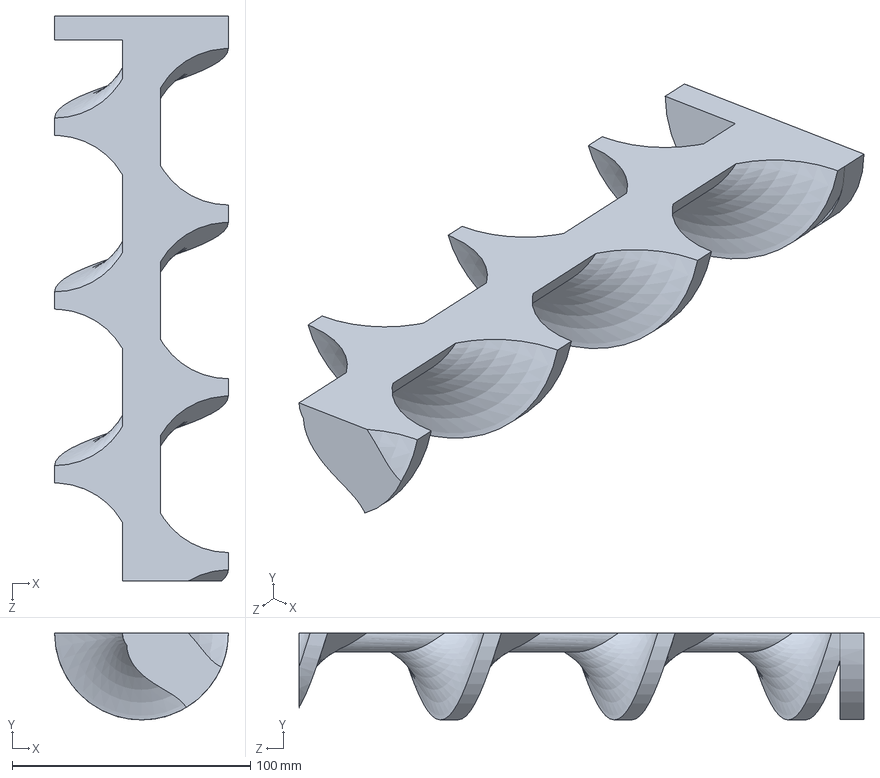
[picture p100: CAD file, 2018-11-02]
Solución/Diseño Mecánico/Transportadores/Adicional/4 TSF Adicional.SLDPRT
73.0 x 36.4 x 237.0 mm
