steveamena/Graduacion/Solución/Diseño Mecánico/Transportadores/Concentrado/Impresion 3D/Ensamble del TSF Concentrado/Acople TSF Concentrado.SLDPRT

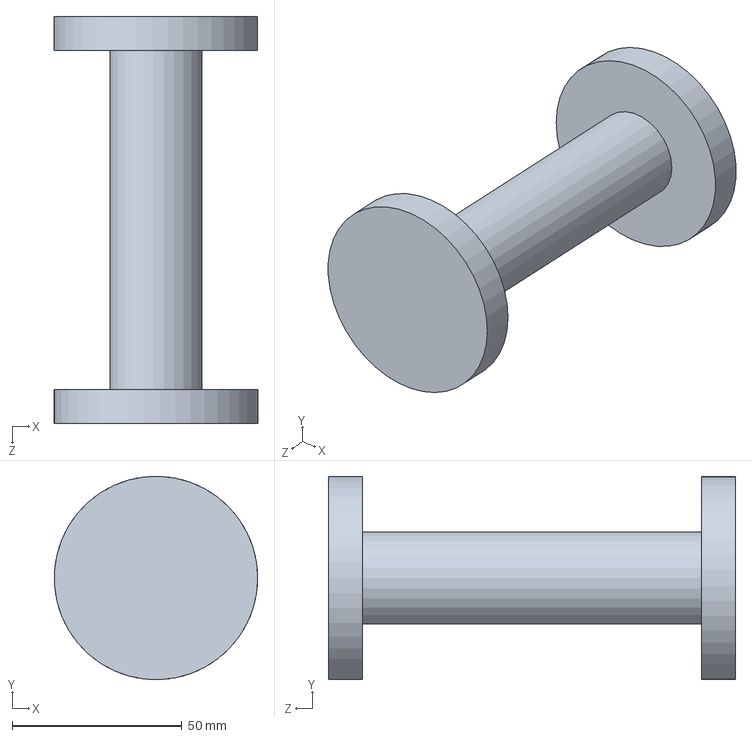
[picture p101: CAD file, 2018-11-02]
Solución/Diseño Mecánico/Transportadores/Concentrado/Impresion 3D/Ensamble del TSF Concentrado/Acople TSF Concentrado.SLDPRT
60.0 x 60.0 x 120.0 mm
