steveamena/Graduacion/Solución/Diseño Mecánico/Transportadores/Concentrado/Impresion 3D/TSF Concentrado 3.STL

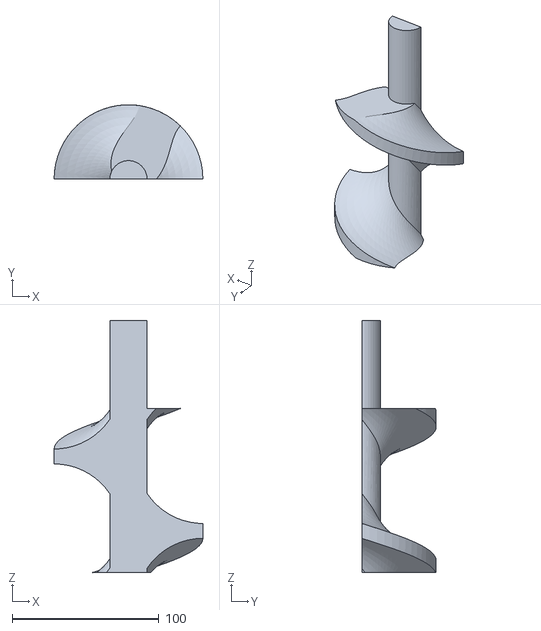
[picture p102: CAD file, 2018-11-02]
Solución/Diseño Mecánico/Transportadores/Concentrado/Impresion 3D/TSF Concentrado 3.STL
101.6 x 50.8 x 172.0
