steveamena/Graduacion/Solución/Diseño Mecánico/Transportadores/Concentrado/YAR 203_12-2F-24.SLDPRT

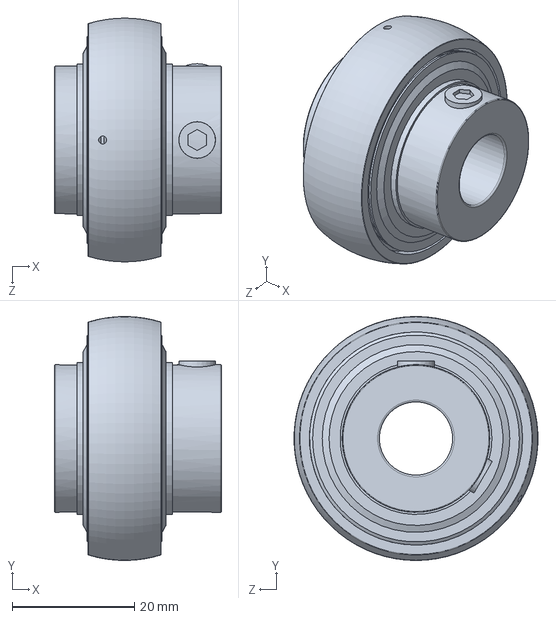
[picture p103: CAD file, 2018-11-02]
Solución/Diseño Mecánico/Transportadores/Concentrado/YAR 203_12-2F-24.SLDPRT
27.4 x 40.0 x 40.0 mm
