steveamena/Graduacion/Solución/Diseño Mecánico/Transportadores/Mineral/TSF Mineral Inferior.STL

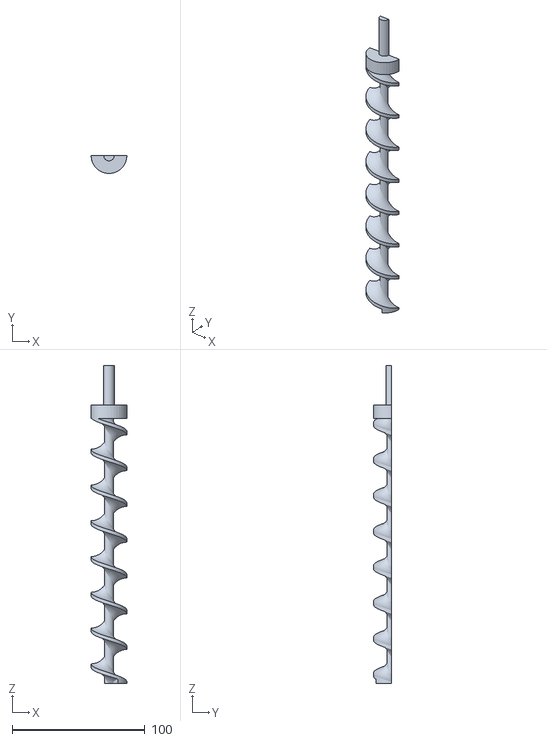
[picture p104: CAD file, 2018-11-02]
Solución/Diseño Mecánico/Transportadores/Mineral/TSF Mineral Inferior.STL
27.0 x 13.5 x 240.0
