steveamena/Graduacion/Solución/Diseño Mecánico/Transportadores/TSF A Part.STL

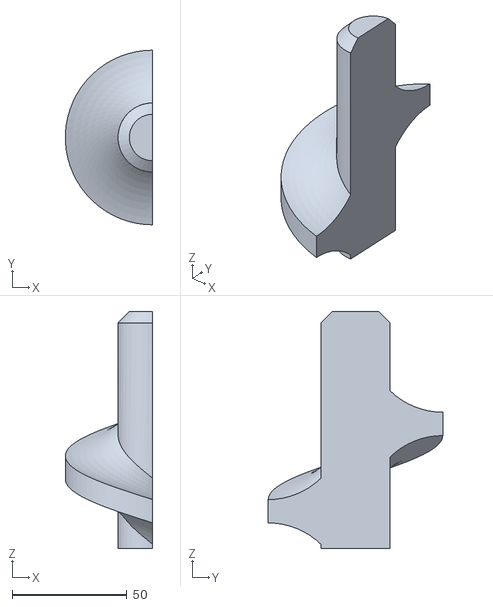
[picture p105: CAD file, 2018-09-20]
Solución/Diseño Mecánico/Transportadores/TSF A Part.STL
38.1 x 76.2 x 103.4
