steveamena/Graduacion/Solución/Diseño Máquina/Citrocom/Tolva CC.SLDPRT

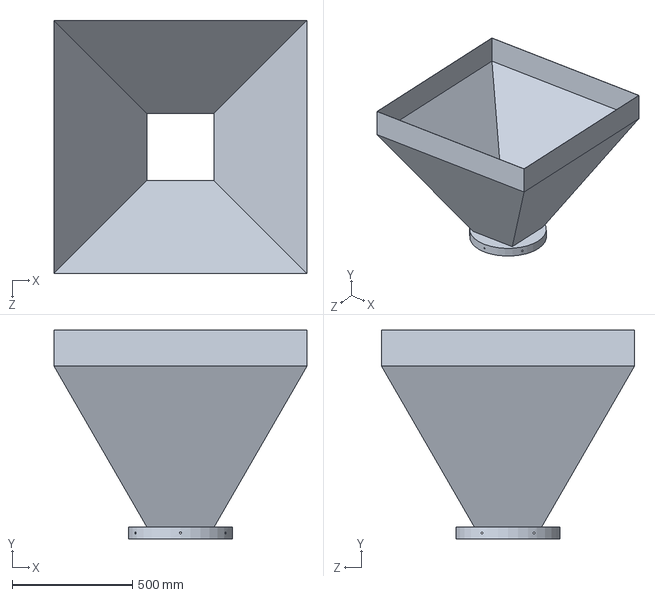
[picture p106: CAD file, 2019-05-12]
Solución/Diseño Máquina/Citrocom/Tolva CC.SLDPRT
1050.0 x 866.8 x 1050.0 mm
