steveamena/Graduacion/Solución/Diseño Máquina/Concentrado/Tolva Con Conico.SLDPRT

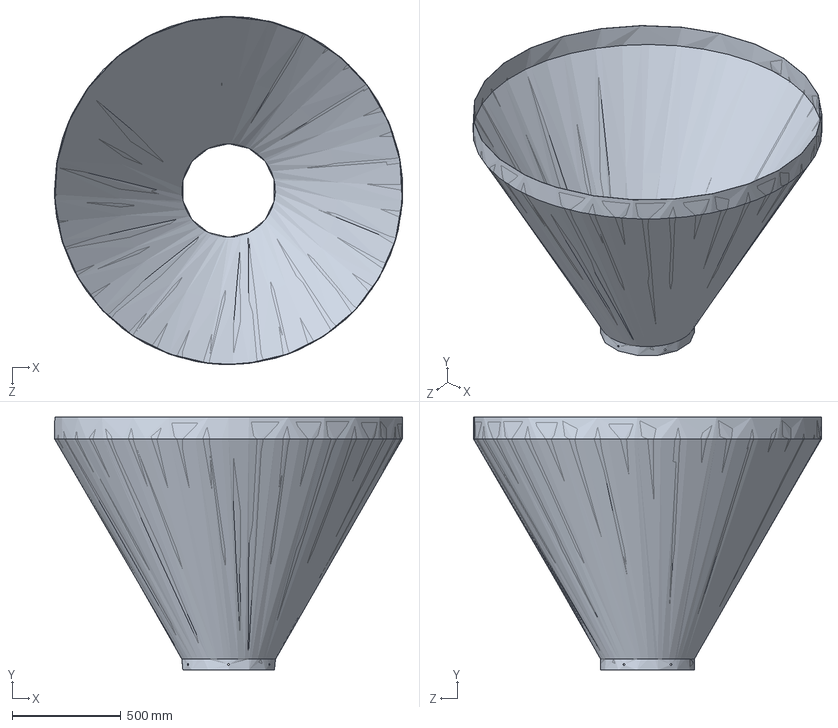
[picture p107: CAD file, 2019-05-14]
Solución/Diseño Máquina/Concentrado/Tolva Con Conico.SLDPRT
1600.8 x 1163.2 x 1602.0 mm
