steveamena/Graduacion/Solución/Diseño Máquina/Mineral y Levadura/Tolva Min.SLDPRT

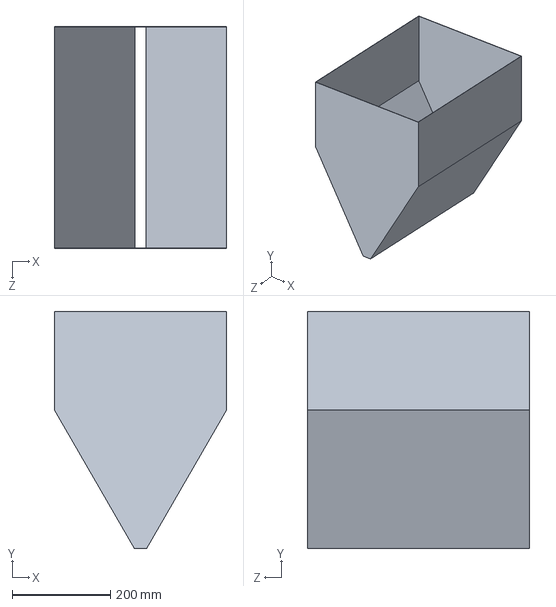
[picture p108: CAD file, 2019-05-14]
Solución/Diseño Máquina/Mineral y Levadura/Tolva Min.SLDPRT
350.0 x 481.5 x 450.0 mm
