steveamena/Graduacion/Solución/Diseño Máquina/Prueba Vertical/Descarga Concentrado.SLDPRT

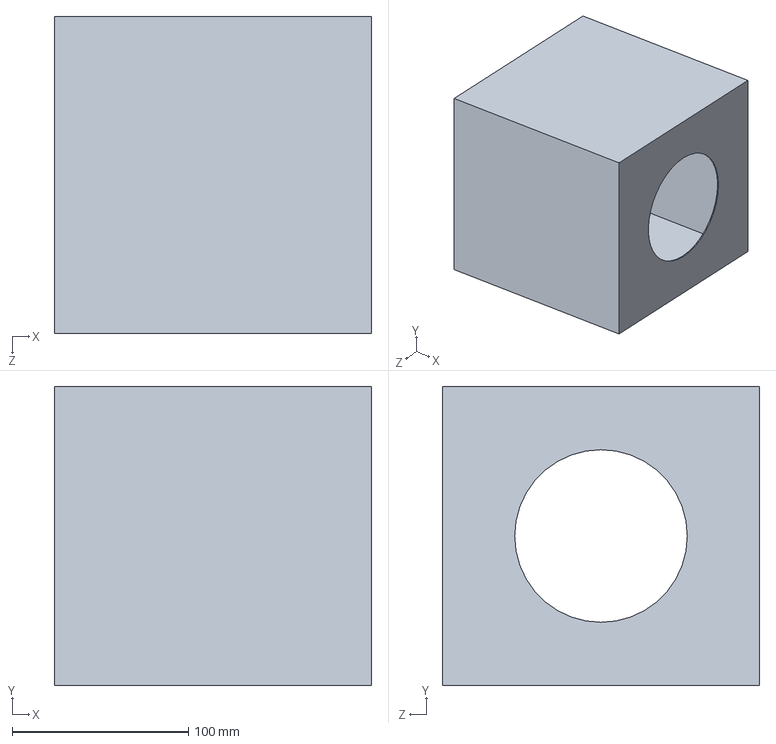
[picture p109: CAD file, 2019-05-30]
Solución/Diseño Máquina/Prueba Vertical/Descarga Concentrado.SLDPRT
180.0 x 170.0 x 180.0 mm
