steveamena/Graduacion/Solución/Diseño Máquina/Tolvas Romana/Chapa/Testing.SLDPRT

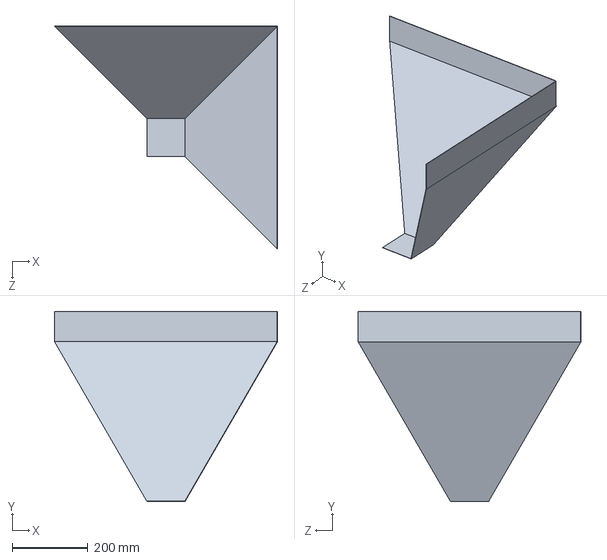
[picture p110: CAD file, 2019-03-11]
Solución/Diseño Máquina/Tolvas Romana/Chapa/Testing.SLDPRT
587.2 x 501.2 x 587.2 mm
