steveamena/Graduacion/Solución/Diseño Máquina/Tolvas Romana/Hinge/Hinger1.SLDPRT

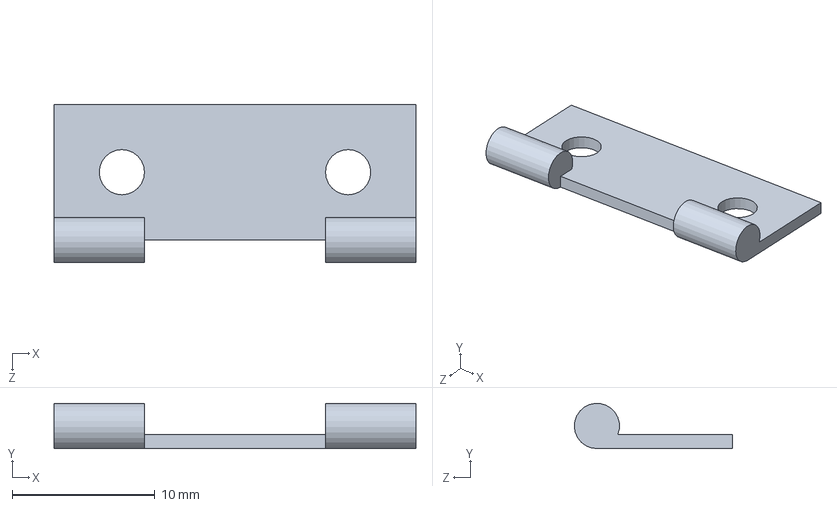
[picture p111: CAD file, 2019-03-11]
Solución/Diseño Máquina/Tolvas Romana/Hinge/Hinger1.SLDPRT
25.4 x 3.17 x 11.1 mm
