steveamena/Graduacion/Solución/Diseño Máquina/Tolvas Romana/Tolva Romana.SLDPRT

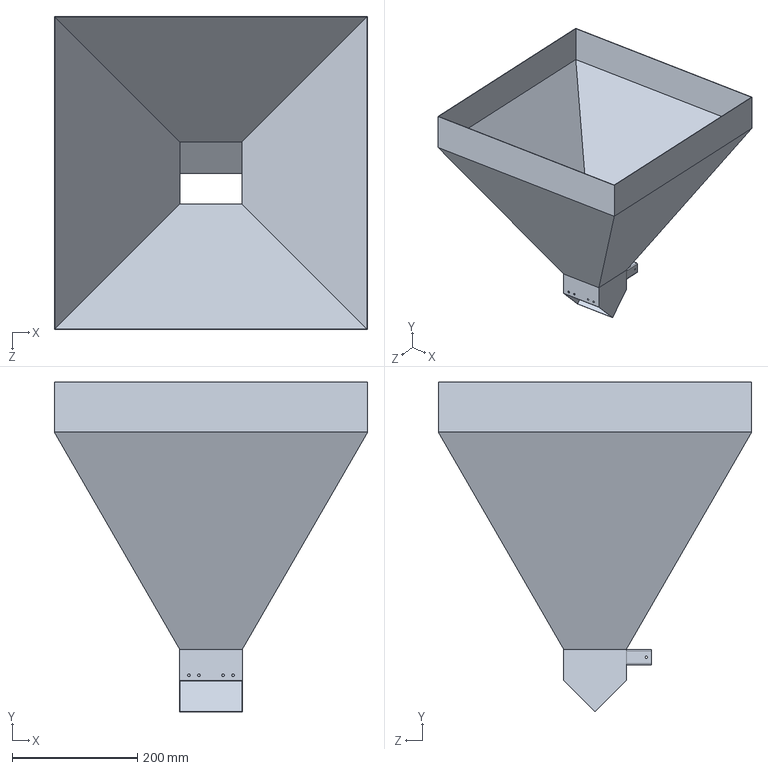
[picture p112: CAD file, 2019-05-14]
Solución/Diseño Máquina/Tolvas Romana/Tolva Romana.SLDPRT
500.0 x 526.4 x 500.0 mm
