steveamena/Graduacion/Resultados/Tolva Romana/PA-07.SLDPRT

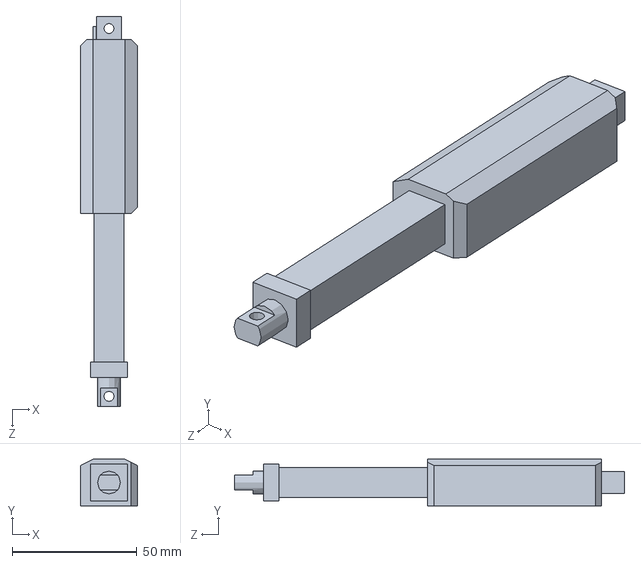
[picture p113: CAD file, 2018-11-02]
Resultados/Tolva Romana/PA-07.SLDPRT
22.9 x 18.8 x 156.5 mm
