steveamena/Graduacion/Solución/Diseño Mecánico/Caja Neumatica/Derecha.SLDPRT

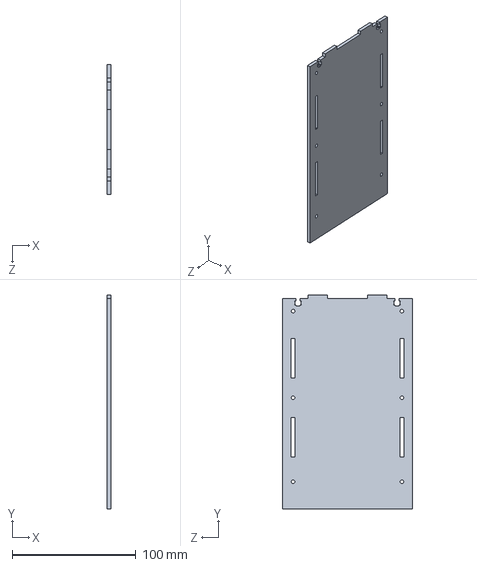
[picture p114: CAD file, 2019-02-25]
Solución/Diseño Mecánico/Caja Neumatica/Derecha.SLDPRT
3.00 x 173.0 x 105.0 mm
