steveamena/Graduacion/Solución/Diseño Mecánico/Diseños conceptuales/Propuesta 2/Piston/Compuerta Deslizante.SLDPRT

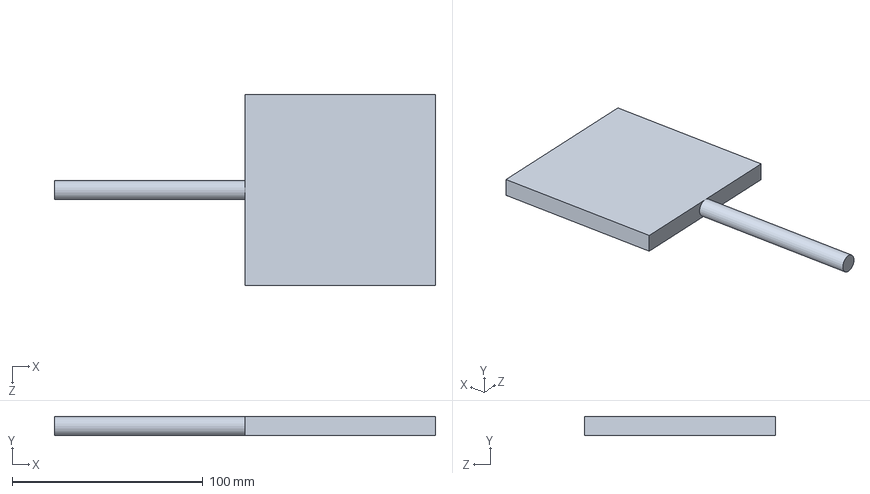
[picture p115: CAD file, 2018-10-02]
Solución/Diseño Mecánico/Diseños conceptuales/Propuesta 2/Piston/Compuerta Deslizante.SLDPRT
200.0 x 10.0 x 100.0 mm
