steveamena/Graduacion/Solución/Diseño Mecánico/Diseños conceptuales/Propuesta 2/Soporte Banda.SLDPRT

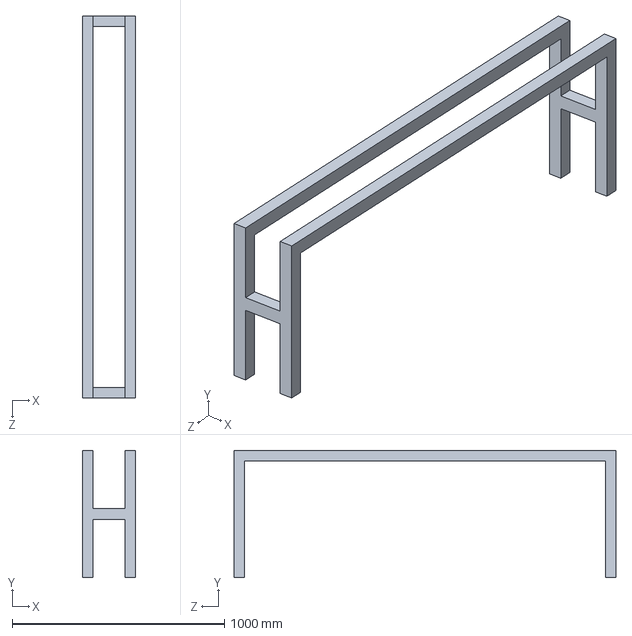
[picture p116: CAD file, 2018-10-02]
Solución/Diseño Mecánico/Diseños conceptuales/Propuesta 2/Soporte Banda.SLDPRT
250.0 x 600.0 x 1800.0 mm
