steveamena/Graduacion/Solución/Diseño Mecánico/Diseños conceptuales/Propuesta final Contenedores Angulo/Ensamble levadura/Almohadilla.SLDPRT

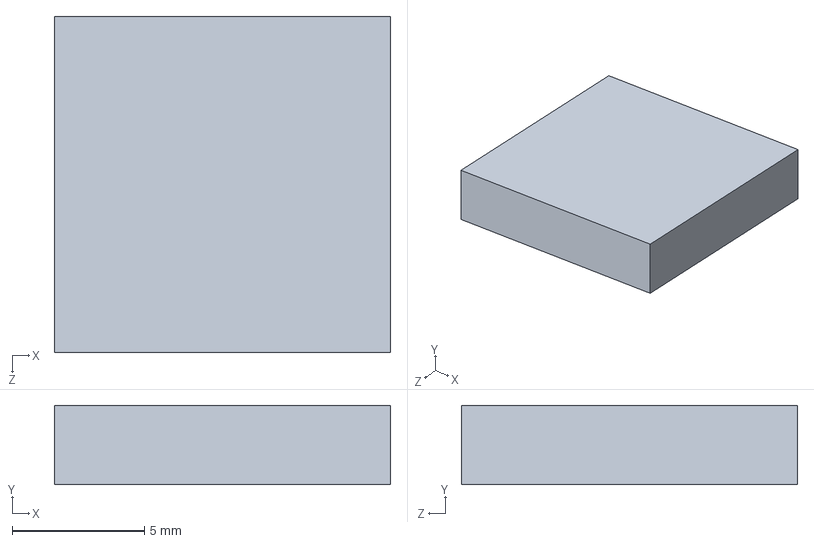
[picture p117: CAD file, 2018-11-02]
Solución/Diseño Mecánico/Diseños conceptuales/Propuesta final Contenedores Angulo/Ensamble levadura/Almohadilla.SLDPRT
12.7 x 3.00 x 12.7 mm
