steveamena/Graduacion/Solución/Diseño Mecánico/Diseños conceptuales/Propuesta prototipo construcción/Dosificador concentrado/Union Tee SCH40 4 in.SLDPRT

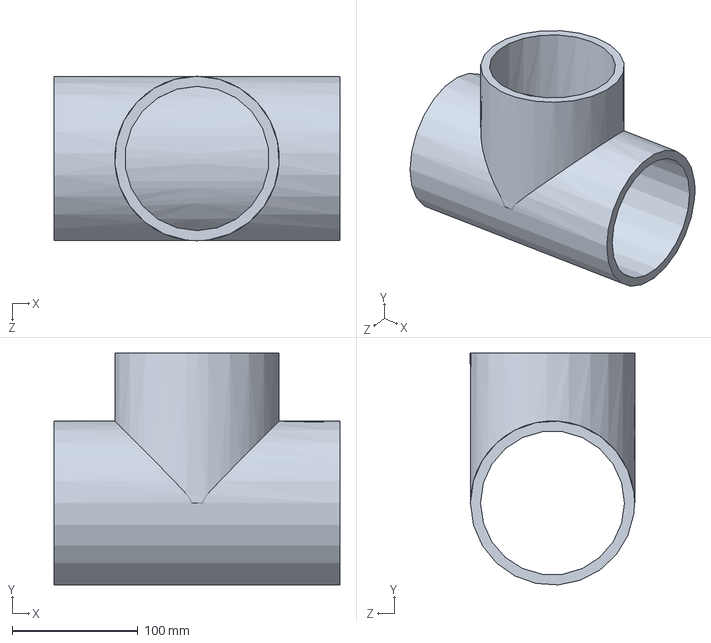
[picture p118: CAD file, 2019-02-25]
Solución/Diseño Mecánico/Diseños conceptuales/Propuesta prototipo construcción/Dosificador concentrado/Union Tee SCH40 4 in.SLDPRT
227.0 x 184.0 x 130.6 mm
