steveamena/Graduacion/Solución/Diseño Mecánico/Diseños conceptuales/Propuesta prototipo construcción/Dosificador Mineral/Tapa.SLDPRT

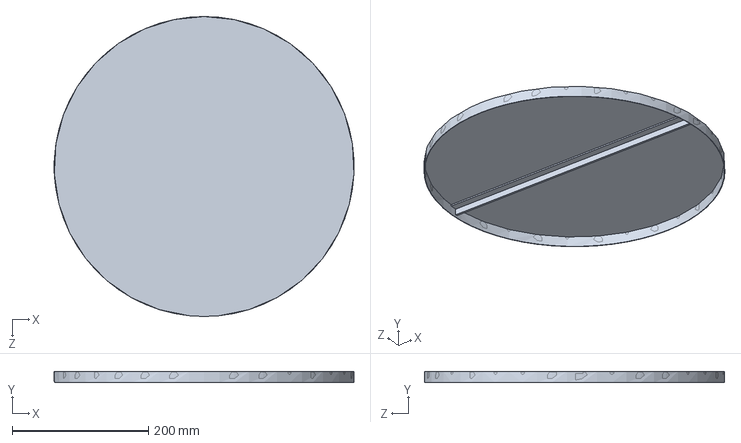
[picture p119: CAD file, 2019-02-25]
Solución/Diseño Mecánico/Diseños conceptuales/Propuesta prototipo construcción/Dosificador Mineral/Tapa.SLDPRT
440.5 x 16.7 x 440.6 mm
