steveamena/Graduacion/Solución/Diseño Mecánico/Diseños conceptuales/Propuesta prototipo construcción/Ensamble levadura/Tolva Levadura.SLDPRT

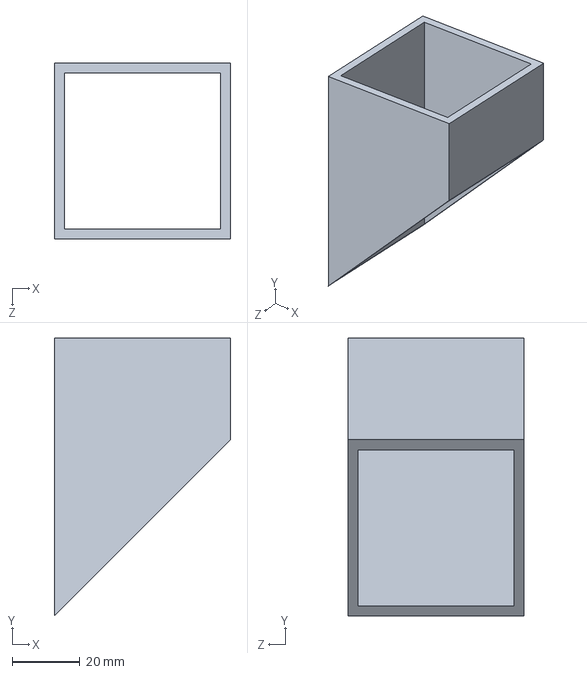
[picture p120: CAD file, 2018-10-02]
Solución/Diseño Mecánico/Diseños conceptuales/Propuesta prototipo construcción/Ensamble levadura/Tolva Levadura.SLDPRT
52.0 x 82.0 x 52.0 mm
