steveamena/Graduacion/Solución/Diseño Mecánico/Diseños conceptuales/Propuesta prototipo construcción/Suministrador/Recibidor.SLDPRT

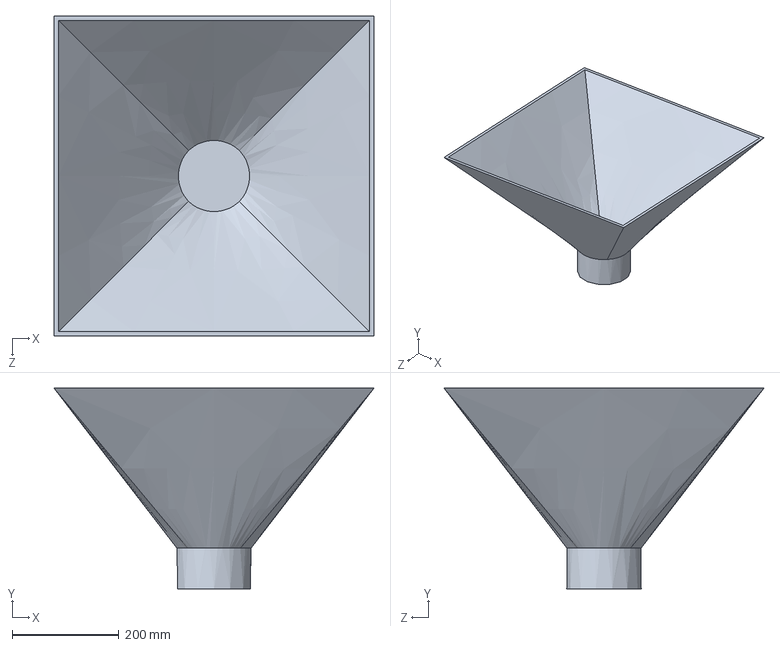
[picture p121: CAD file, 2018-10-03]
Solución/Diseño Mecánico/Diseños conceptuales/Propuesta prototipo construcción/Suministrador/Recibidor.SLDPRT
600.0 x 376.2 x 600.0 mm
