steveamena/Graduacion/Solución/Diseño Mecánico/Diseños conceptuales/Propuesta prototipo construcción/Tolva Mineral.SLDPRT

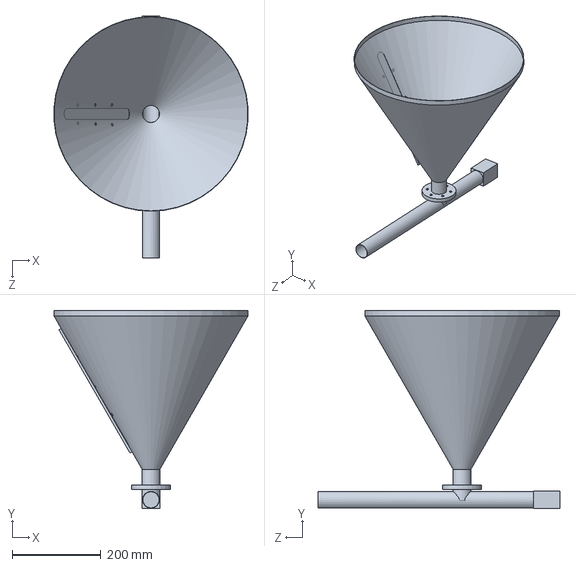
[picture p122: CAD file, 2019-02-25]
Solución/Diseño Mecánico/Diseños conceptuales/Propuesta prototipo construcción/Tolva Mineral.SLDPRT
438.0 x 447.7 x 546.0 mm
