steveamena/Graduacion/Solución/Diseño Mecánico/Diseños conceptuales/Propuesta prototipo construcción/Tolva Romana/Stepper Motor.SLDPRT

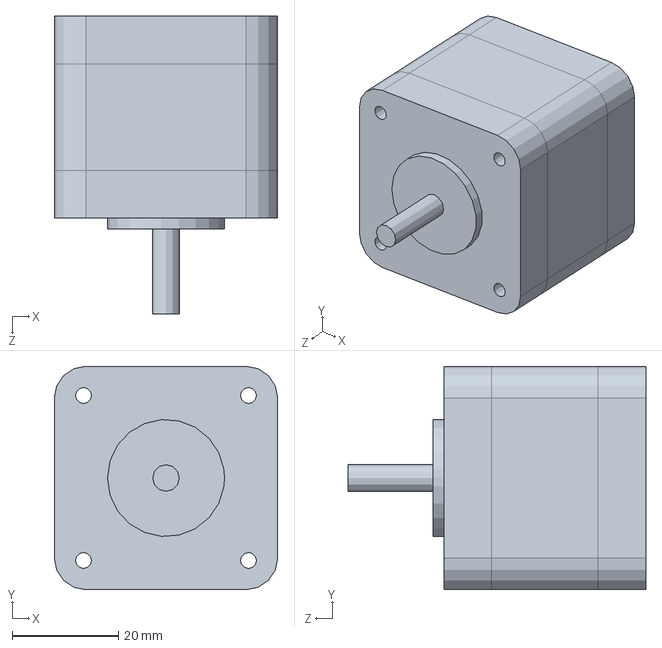
[picture p123: CAD file, 2018-10-02]
Solución/Diseño Mecánico/Diseños conceptuales/Propuesta prototipo construcción/Tolva Romana/Stepper Motor.SLDPRT
42.0 x 42.0 x 56.0 mm
