steveamena/Graduacion/Solución/Diseño Mecánico/Diseños conceptuales/Propuesta prototipo construcción/UberCow/Ruedas.SLDPRT

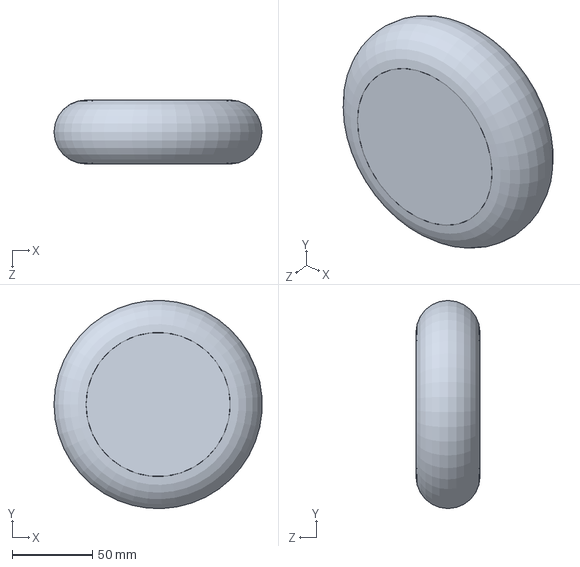
[picture p124: CAD file, 2018-10-03]
Solución/Diseño Mecánico/Diseños conceptuales/Propuesta prototipo construcción/UberCow/Ruedas.SLDPRT
129.8 x 129.9 x 40.0 mm
