steveamena/Graduacion/Solución/Diseño Mecánico/Esclusas/Adicional/EscAdicUnionTolva.SLDPRT

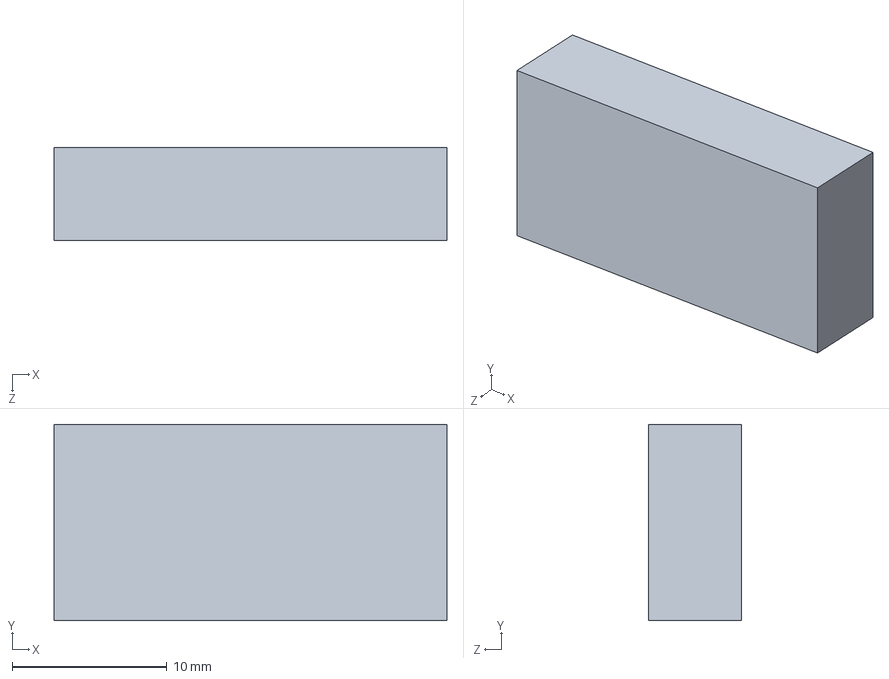
[picture p125: CAD file, 2018-09-04]
Solución/Diseño Mecánico/Esclusas/Adicional/EscAdicUnionTolva.SLDPRT
25.4 x 12.7 x 6.00 mm
