steveamena/Graduacion/Solución/Diseño Mecánico/Esclusas/Caja Rosita/LateralTapa.SLDPRT

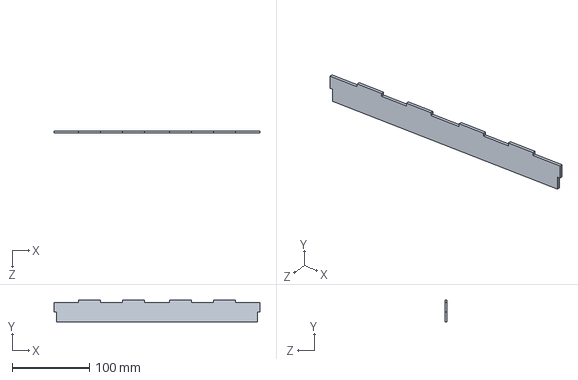
[picture p126: CAD file, 2018-09-20]
Solución/Diseño Mecánico/Esclusas/Caja Rosita/LateralTapa.SLDPRT
266.0 x 28.4 x 3.00 mm
