steveamena/Graduacion/Solución/Diseño Mecánico/Esclusas/Concentrado/EscConcSoporteSolenoide.SLDPRT

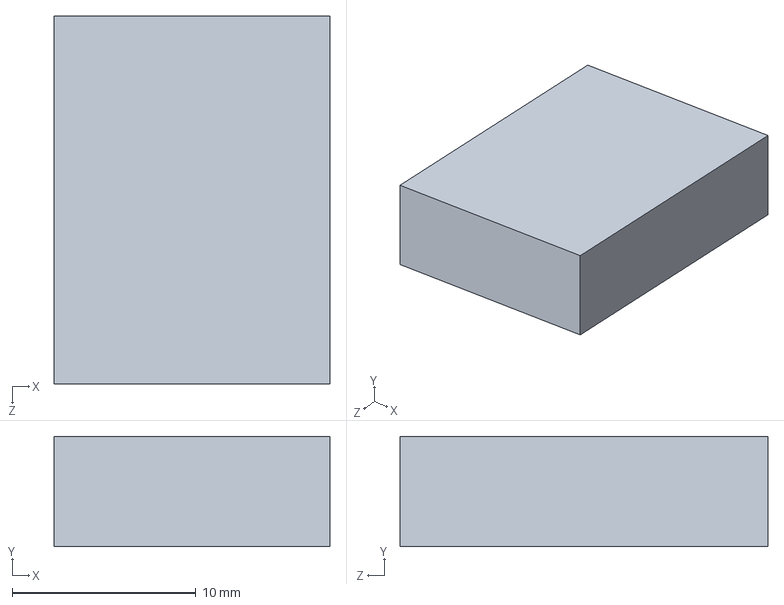
[picture p127: CAD file, 2018-09-04]
Solución/Diseño Mecánico/Esclusas/Concentrado/EscConcSoporteSolenoide.SLDPRT
15.0 x 6.00 x 20.0 mm
