steveamena/Graduacion/Solución/Diseño Mecánico/Esclusas/Levadura/LevEscSoporteCeldaDesarrollo.SLDPRT

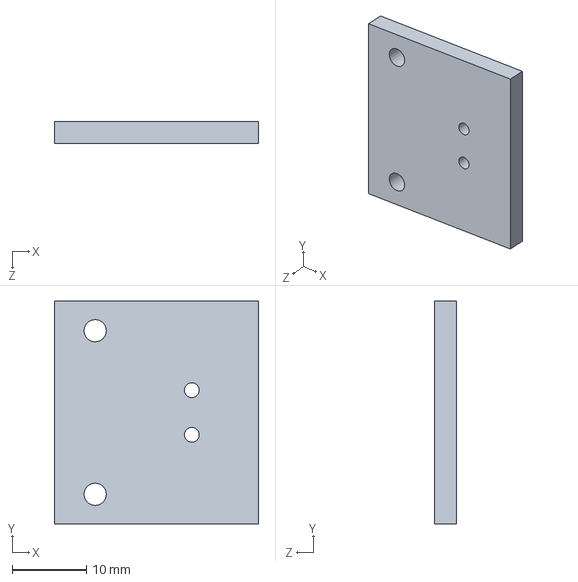
[picture p128: CAD file, 2018-09-20]
Solución/Diseño Mecánico/Esclusas/Levadura/LevEscSoporteCeldaDesarrollo.SLDPRT
27.5 x 30.0 x 3.00 mm
