steveamena/Graduacion/Solución/Diseño Mecánico/Esclusas/Mineral 2/Resbalon MAgnético.SLDPRT

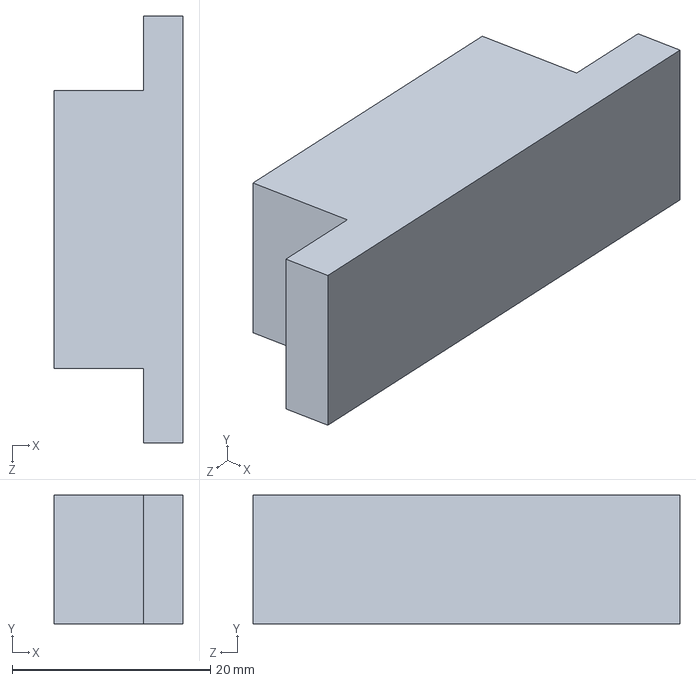
[picture p129: CAD file, 2019-02-25]
Solución/Diseño Mecánico/Esclusas/Mineral 2/Resbalon MAgnético.SLDPRT
13.0 x 13.0 x 43.0 mm
