steveamena/Graduacion/Solución/Diseño Mecánico/Esclusas/Mineral/micro servo.SLDPRT

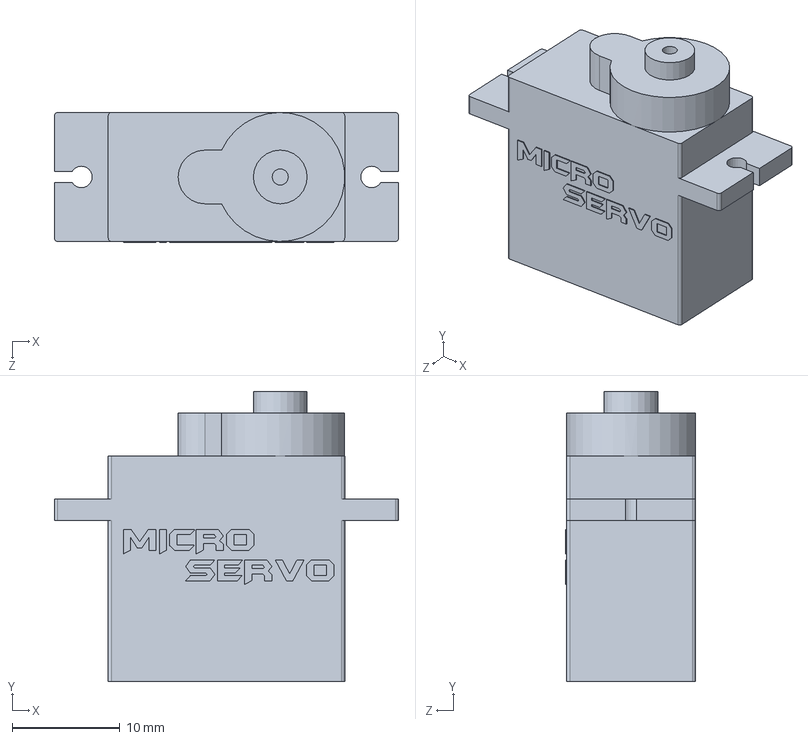
[picture p130: CAD file, 2018-09-20]
Solución/Diseño Mecánico/Esclusas/Mineral/micro servo.SLDPRT
32.0 x 27.0 x 12.1 mm
