steveamena/Graduacion/Solución/Diseño Mecánico/Transportadores/Adicional/TSF Adicional.SLDPRT

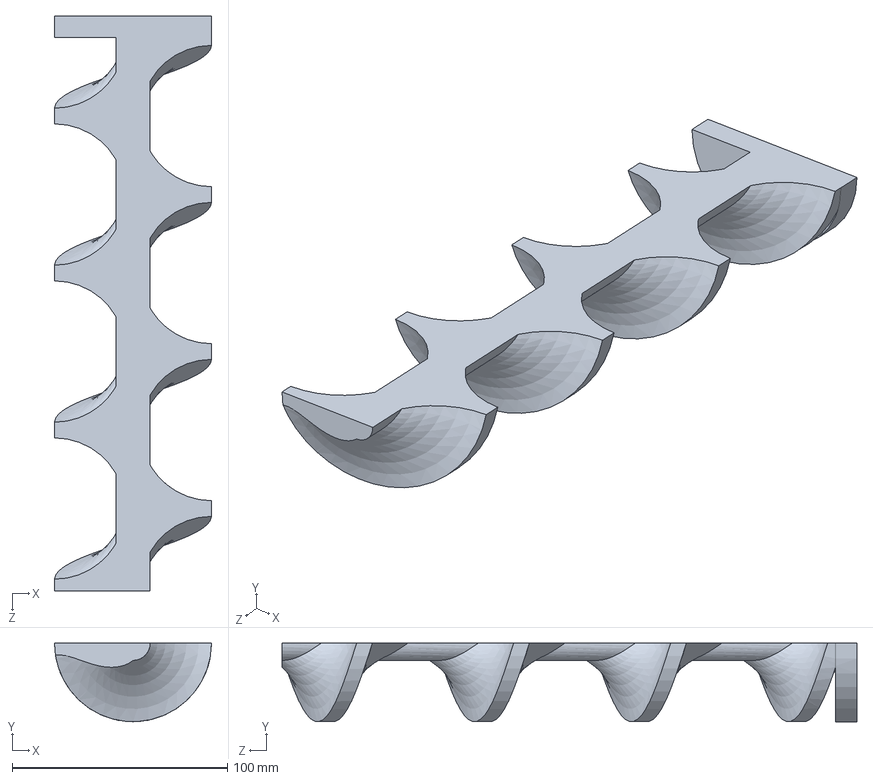
[picture p131: CAD file, 2018-11-02]
Solución/Diseño Mecánico/Transportadores/Adicional/TSF Adicional.SLDPRT
73.0 x 36.5 x 267.0 mm
