steveamena/Graduacion/Solución/Diseño Mecánico/Transportadores/Concentrado/Impresion 3D/Ensamble del TSF Concentrado/1 TSF Concentrado.SLDPRT

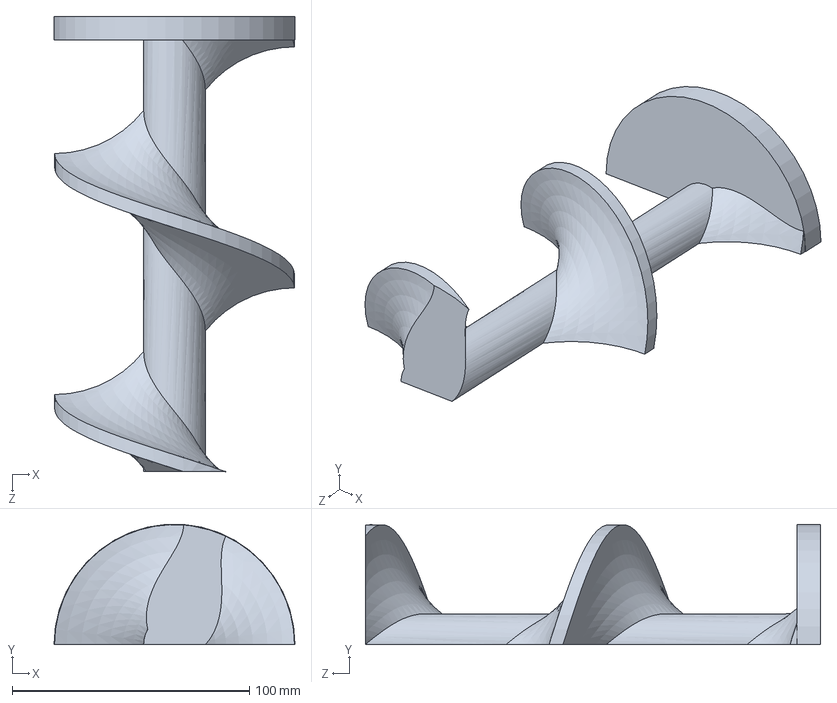
[picture p132: CAD file, 2018-11-02]
Solución/Diseño Mecánico/Transportadores/Concentrado/Impresion 3D/Ensamble del TSF Concentrado/1 TSF Concentrado.SLDPRT
101.6 x 50.7 x 192.0 mm
