steveamena/Graduacion/Solución/Diseño Mecánico/Transportadores/Concentrado/Impresion 3D/TSF Concentrado 1.STL

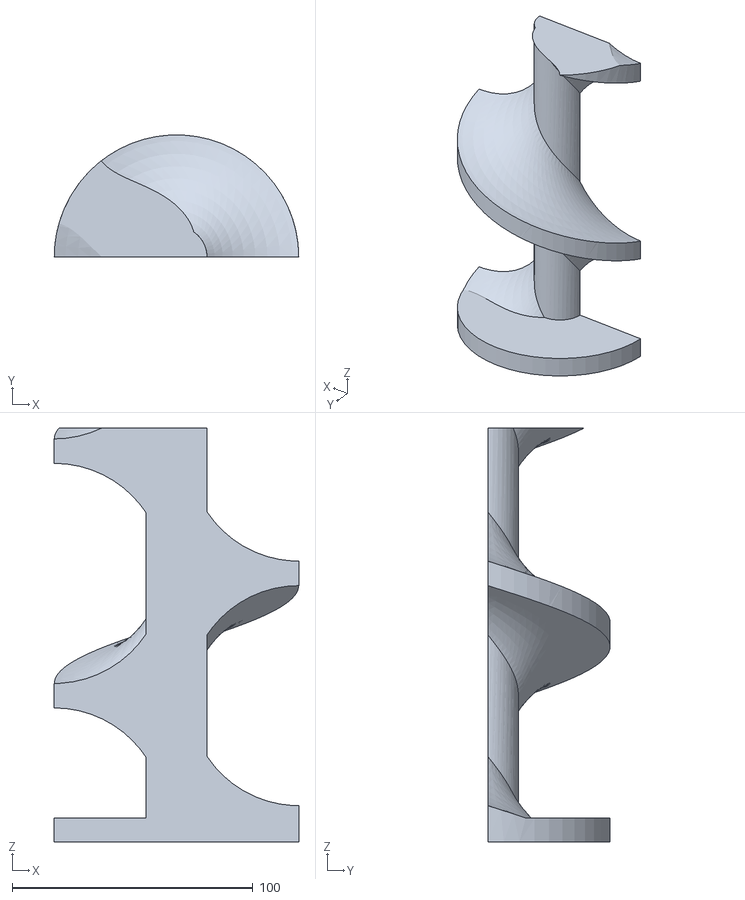
[picture p133: CAD file, 2018-11-02]
Solución/Diseño Mecánico/Transportadores/Concentrado/Impresion 3D/TSF Concentrado 1.STL
101.6 x 50.8 x 172.0
