steveamena/Graduacion/Solución/Diseño Mecánico/Transportadores/Concentrado/TSF Concentrado.SLDPRT

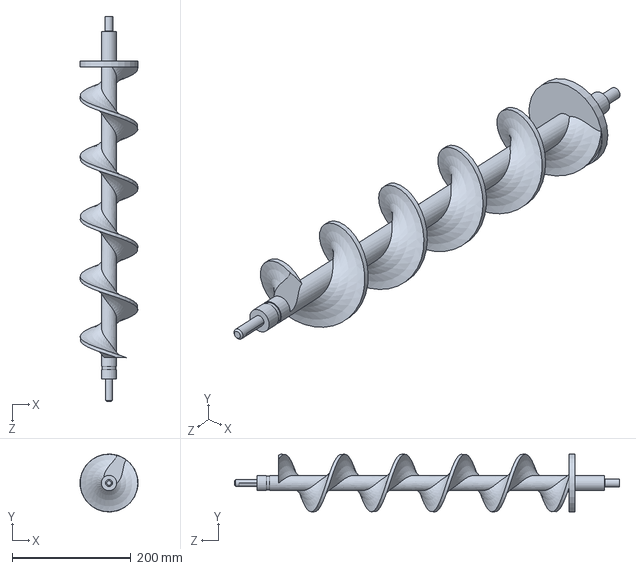
[picture p134: CAD file, 2018-11-02]
Solución/Diseño Mecánico/Transportadores/Concentrado/TSF Concentrado.SLDPRT
98.0 x 97.8 x 649.4 mm
