steveamena/Graduacion/Solución/Diseño Máquina/Esclusas finos/Hinge2.SLDPRT

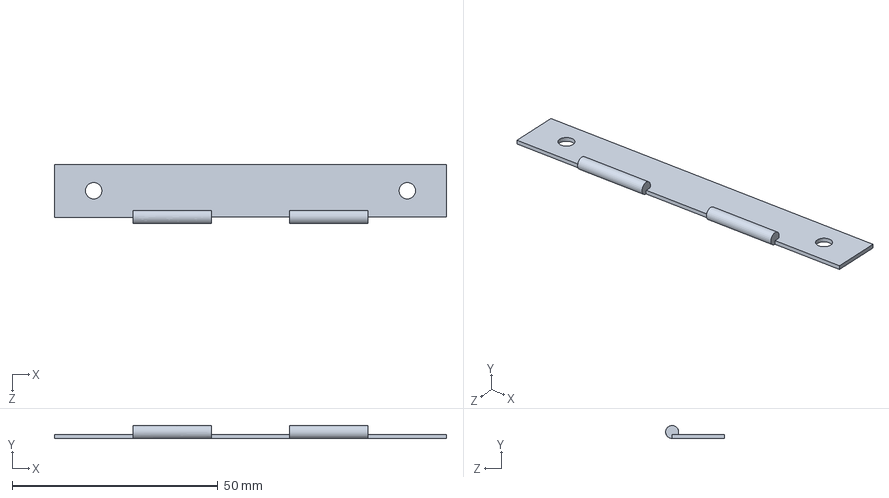
[picture p135: CAD file, 2019-05-12]
Solución/Diseño Máquina/Esclusas finos/Hinge2.SLDPRT
95.2 x 3.17 x 14.3 mm
