steveamena/Graduacion/Solución/Diseño Máquina/Mineral y Levadura/Tolva Lev.SLDPRT

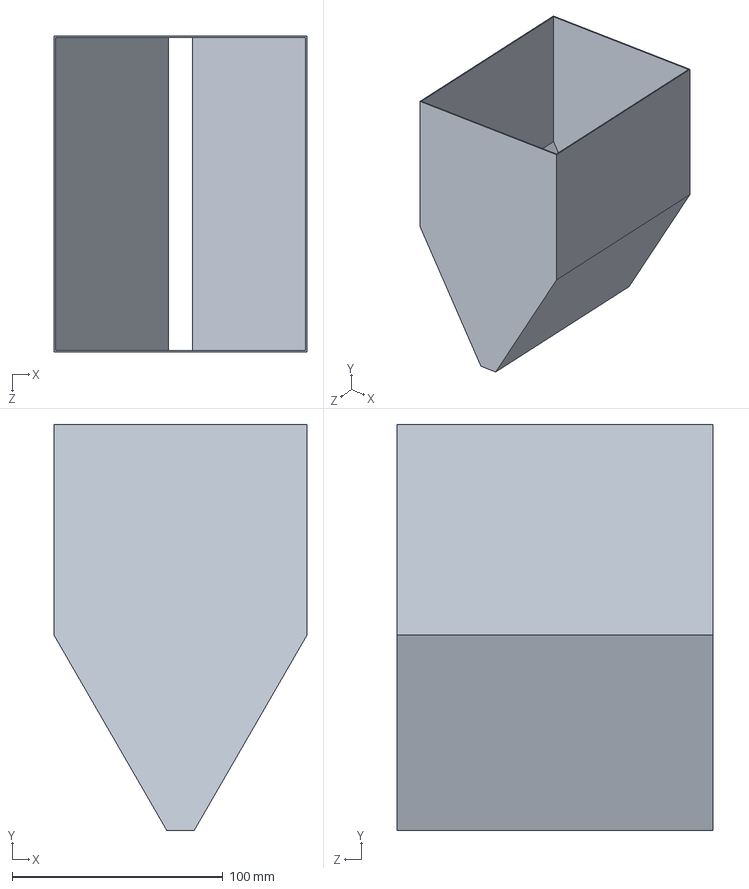
[picture p136: CAD file, 2019-05-12]
Solución/Diseño Máquina/Mineral y Levadura/Tolva Lev.SLDPRT
120.0 x 192.7 x 150.0 mm
