steveamena/Graduacion/Solución/Diseño Máquina/Prueba Vertical/Tubo 3 in.SLDPRT

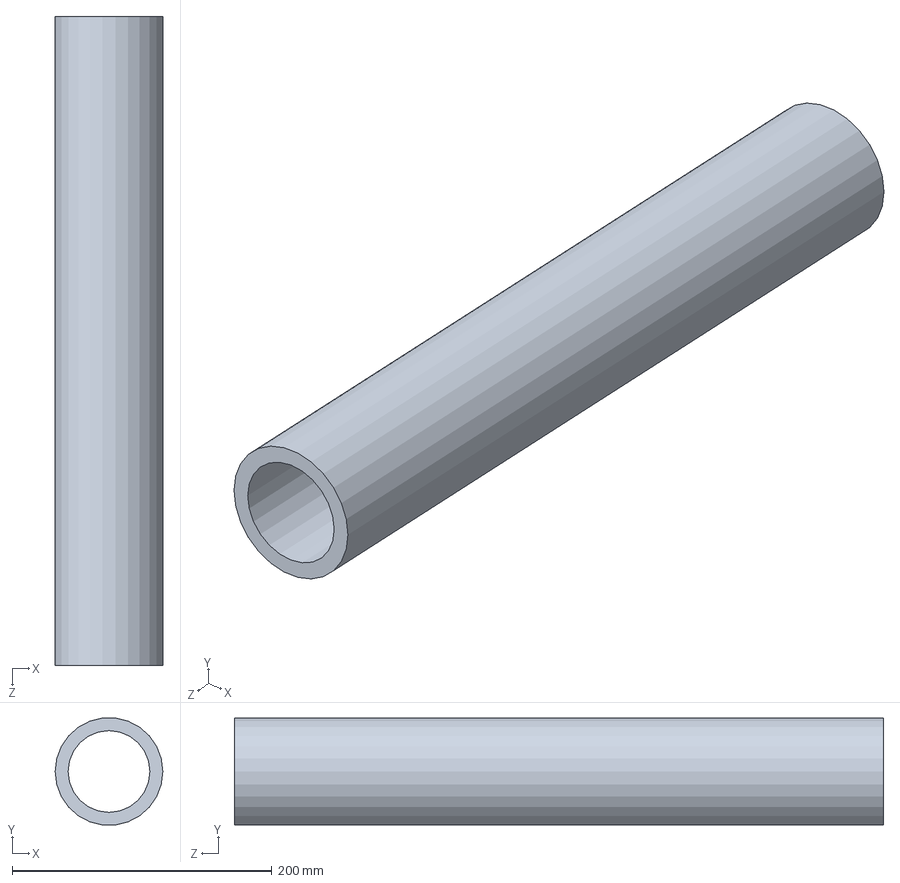
[picture p137: CAD file, 2019-05-30]
Solución/Diseño Máquina/Prueba Vertical/Tubo 3 in.SLDPRT
83.0 x 82.4 x 500.0 mm
