steveamena/Graduacion/Solución/Diseño Mecánico/Caja Neumatica/Izquierda.SLDPRT

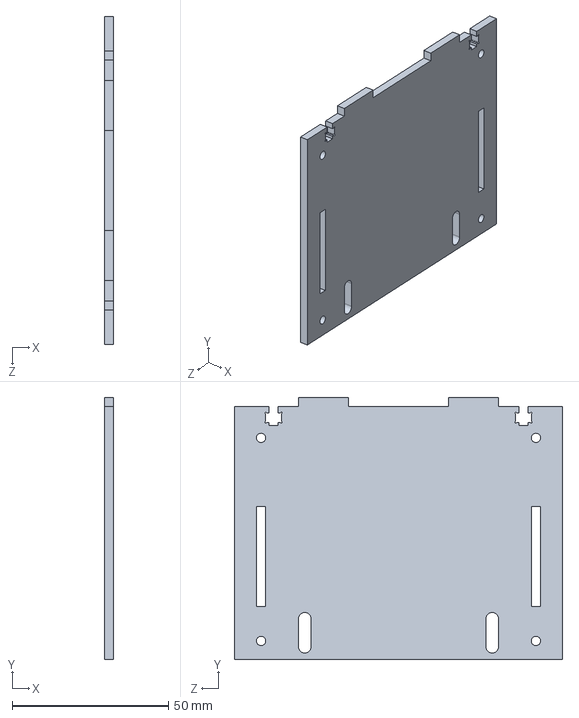
[picture p139: CAD file, 2019-02-25]
Solución/Diseño Mecánico/Caja Neumatica/Izquierda.SLDPRT
3.00 x 84.0 x 105.0 mm
