steveamena/Graduacion/Solución/Diseño Mecánico/Diseños conceptuales/Propuesta 1/TolvaGeneral.SLDPRT

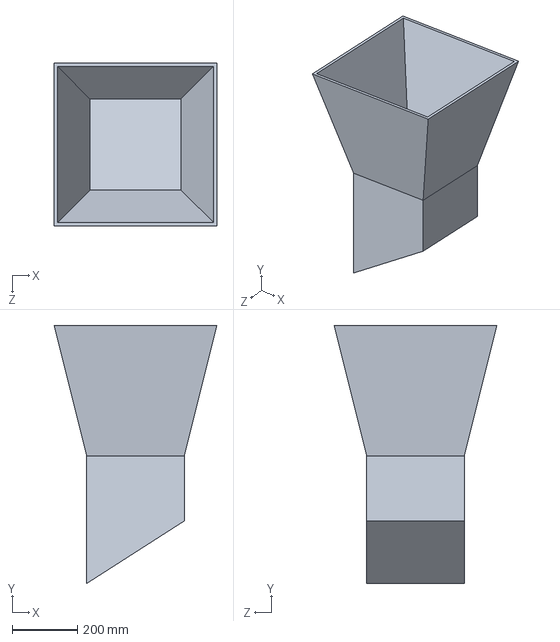
[picture p140: CAD file, 2018-10-02]
Solución/Diseño Mecánico/Diseños conceptuales/Propuesta 1/TolvaGeneral.SLDPRT
500.0 x 792.2 x 500.0 mm
