steveamena/Graduacion/Solución/Diseño Mecánico/Diseños conceptuales/Propuesta 2/Piston/Compuerta Fija.SLDPRT

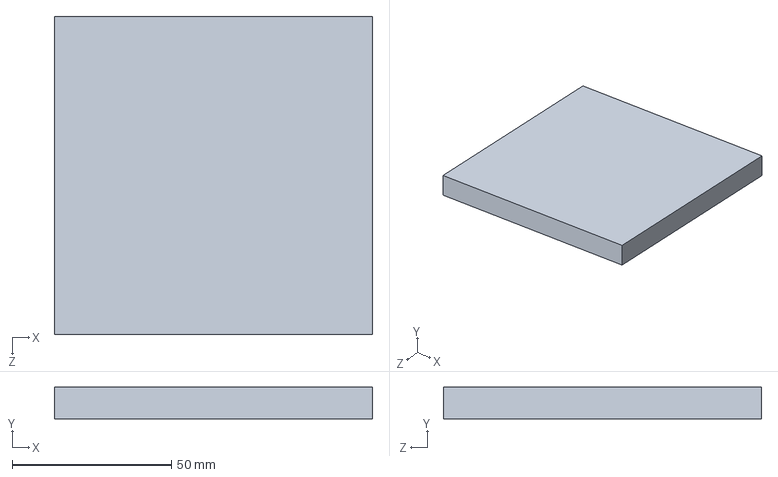
[picture p142: CAD file, 2018-10-02]
Solución/Diseño Mecánico/Diseños conceptuales/Propuesta 2/Piston/Compuerta Fija.SLDPRT
100.0 x 10.0 x 100.0 mm
