steveamena/Graduacion/Solución/Diseño Mecánico/Diseños conceptuales/Propuesta 2/Tolva Levadura.SLDPRT

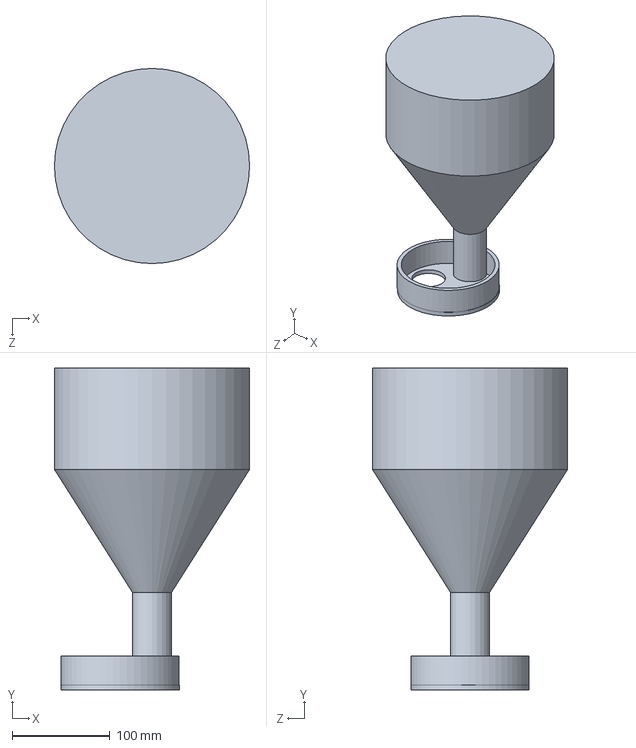
[picture p143: CAD file, 2018-10-02]
Solución/Diseño Mecánico/Diseños conceptuales/Propuesta 2/Tolva Levadura.SLDPRT
200.0 x 330.0 x 200.0 mm
