steveamena/Graduacion/Solución/Diseño Mecánico/Diseños conceptuales/Propuesta 3/Vibrador.SLDPRT

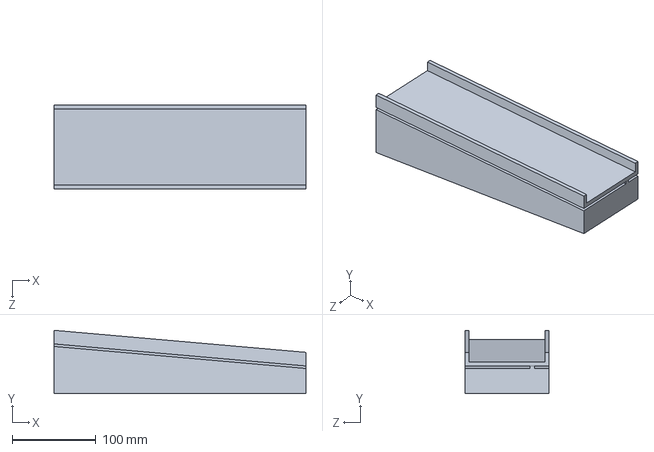
[picture p144: CAD file, 2018-10-02]
Solución/Diseño Mecánico/Diseños conceptuales/Propuesta 3/Vibrador.SLDPRT
300.0 x 75.5 x 100.0 mm
