steveamena/Graduacion/Solución/Diseño Mecánico/Diseños conceptuales/Propuesta final Contenedores Angulo/TSF Mineral.SLDPRT

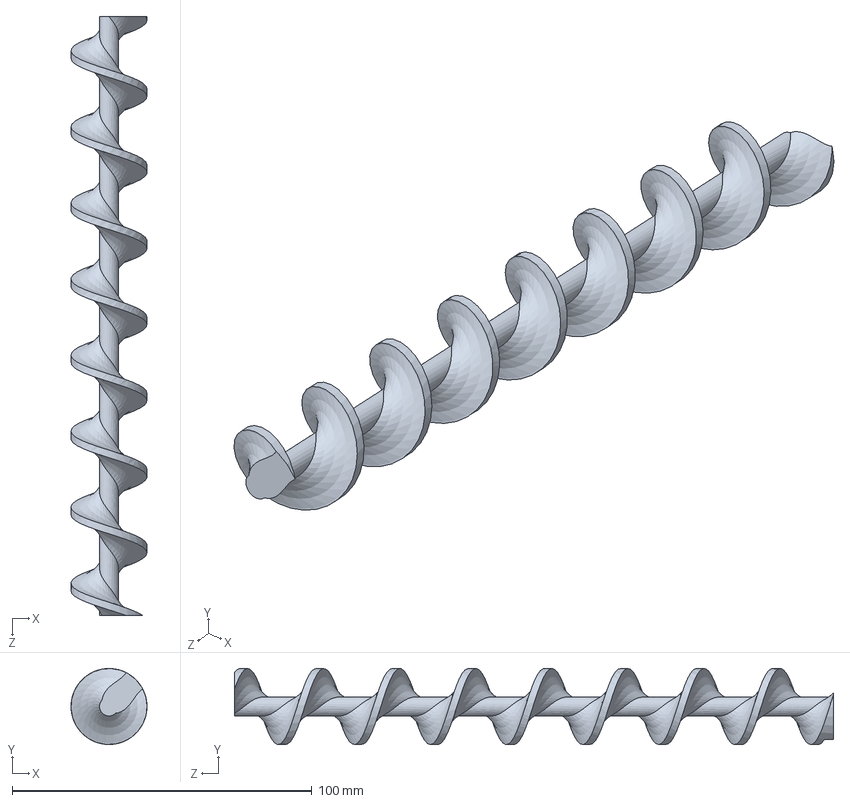
[picture p145: CAD file, 2018-11-02]
Solución/Diseño Mecánico/Diseños conceptuales/Propuesta final Contenedores Angulo/TSF Mineral.SLDPRT
25.4 x 25.4 x 200.0 mm
