steveamena/Graduacion/Solución/Diseño Mecánico/Diseños conceptuales/Propuesta prototipo construcción/Dosificador Citrocon/Tubo Principal 3in.SLDPRT

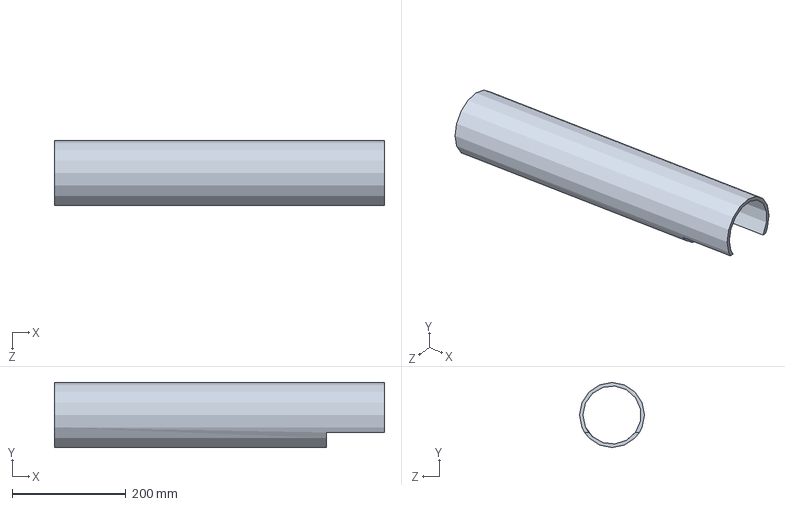
[picture p146: CAD file, 2019-02-25]
Solución/Diseño Mecánico/Diseños conceptuales/Propuesta prototipo construcción/Dosificador Citrocon/Tubo Principal 3in.SLDPRT
580.0 x 114.3 x 114.3 mm
