steveamena/Graduacion/Solución/Diseño Mecánico/Diseños conceptuales/Propuesta prototipo construcción/Ensamble levadura/Superior Stop.SLDPRT

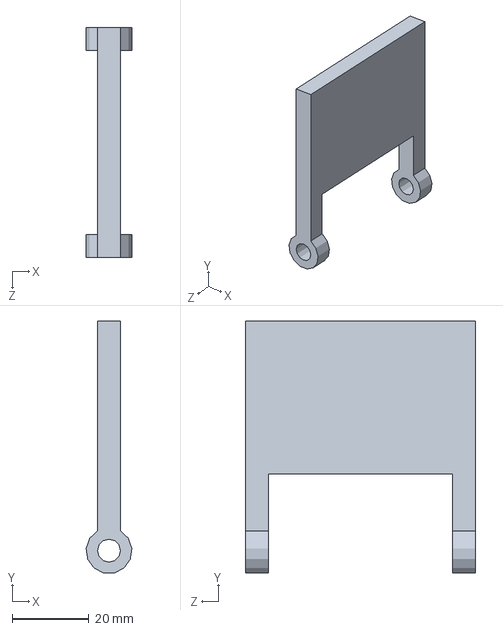
[picture p147: CAD file, 2018-10-02]
Solución/Diseño Mecánico/Diseños conceptuales/Propuesta prototipo construcción/Ensamble levadura/Superior Stop.SLDPRT
11.9 x 65.8 x 60.0 mm
