steveamena/Graduacion/Solución/Diseño Mecánico/Esclusas/Adicional/EscAdicPin.SLDPRT

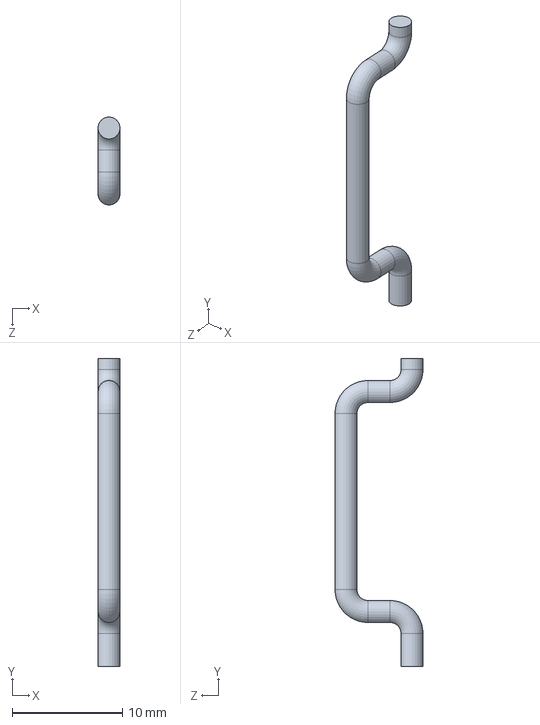
[picture p148: CAD file, 2018-09-04]
Solución/Diseño Mecánico/Esclusas/Adicional/EscAdicPin.SLDPRT
2.00 x 28.0 x 8.00 mm
