steveamena/Graduacion/Solución/Diseño Mecánico/Esclusas/Caja Rosita/FrontalCaja.SLDPRT

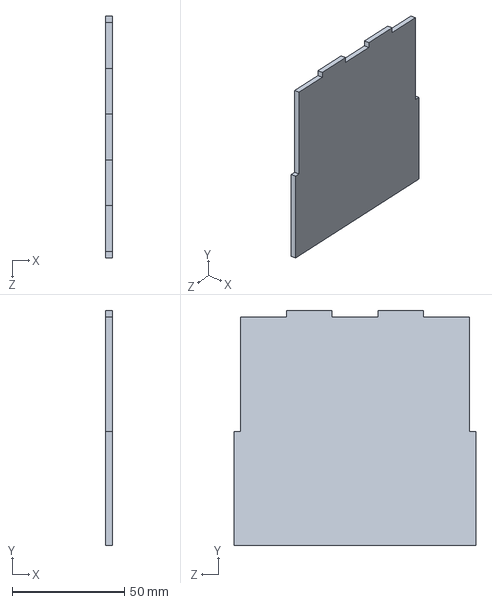
[picture p149: CAD file, 2018-09-20]
Solución/Diseño Mecánico/Esclusas/Caja Rosita/FrontalCaja.SLDPRT
3.00 x 104.6 x 107.6 mm
