steveamena/Graduacion/Solución/Diseño Mecánico/Esclusas/Concentrado/EscConcCompuerta.SLDPRT

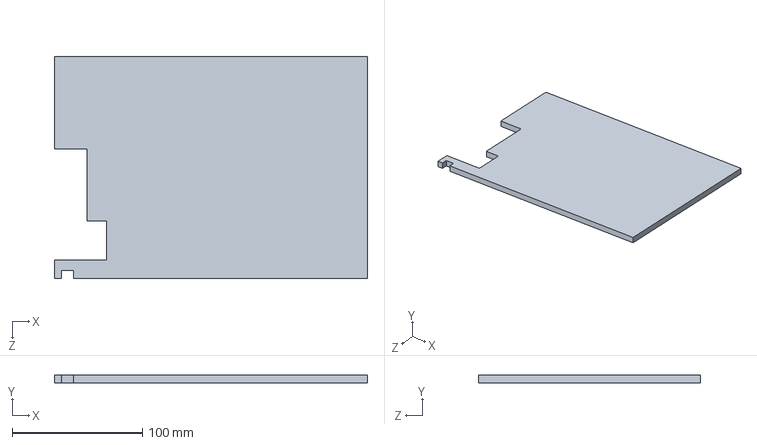
[picture p150: CAD file, 2018-09-04]
Solución/Diseño Mecánico/Esclusas/Concentrado/EscConcCompuerta.SLDPRT
240.0 x 6.00 x 170.0 mm
