steveamena/Graduacion/Solución/Diseño Mecánico/Esclusas/Levadura/LevEscSoporte.SLDPRT

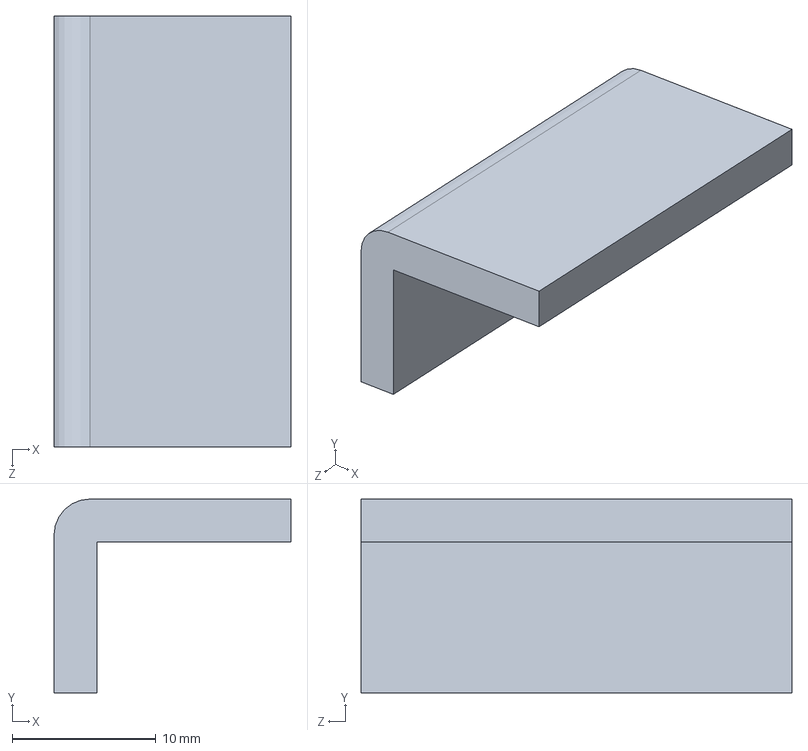
[picture p151: CAD file, 2018-09-20]
Solución/Diseño Mecánico/Esclusas/Levadura/LevEscSoporte.SLDPRT
16.5 x 13.5 x 30.0 mm
