steveamena/Graduacion/Solución/Diseño Mecánico/Esclusas/Mineral 2/Frontal.SLDPRT

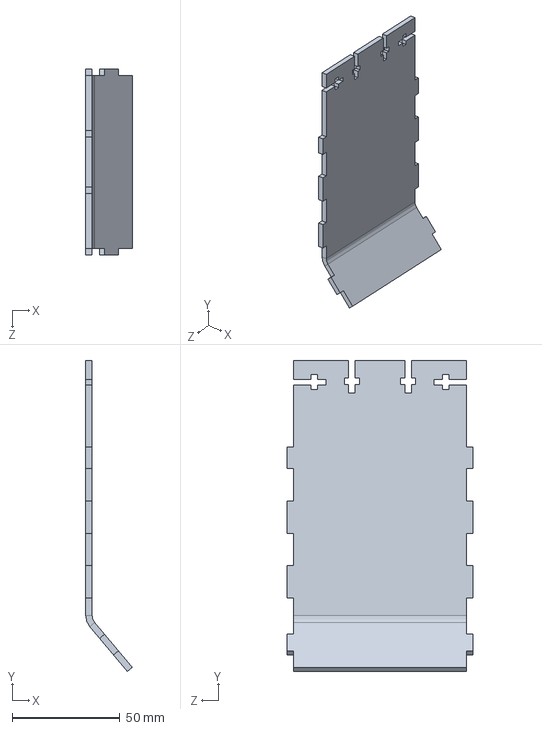
[picture p152: CAD file, 2019-02-25]
Solución/Diseño Mecánico/Esclusas/Mineral 2/Frontal.SLDPRT
21.6 x 144.0 x 86.0 mm
