steveamena/Graduacion/Solución/Diseño Mecánico/Esclusas/Mineral/MinEscUnionDesarrollo.SLDPRT

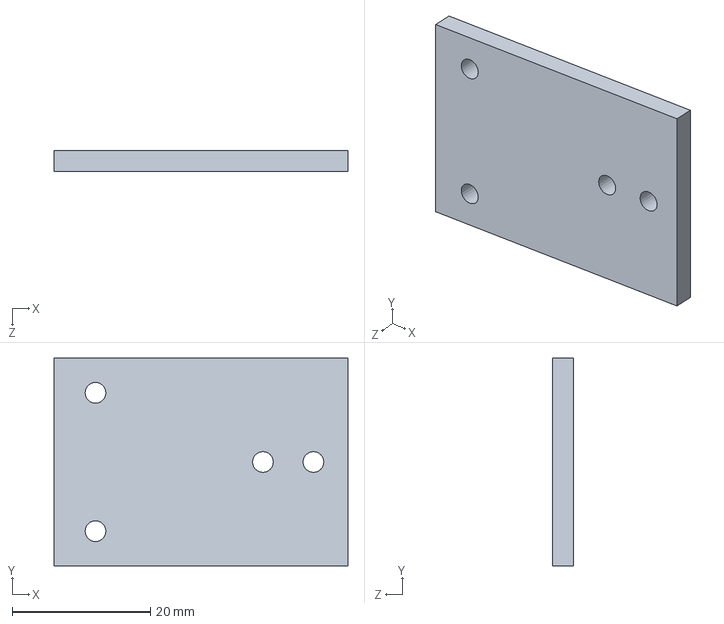
[picture p153: CAD file, 2018-09-20]
Solución/Diseño Mecánico/Esclusas/Mineral/MinEscUnionDesarrollo.SLDPRT
42.5 x 30.0 x 3.00 mm
