steveamena/Graduacion/Solución/Diseño Mecánico/Transportadores/Concentrado/Impresion 3D/Ensamble del TSF Concentrado/5 TSF Concentrado.SLDPRT

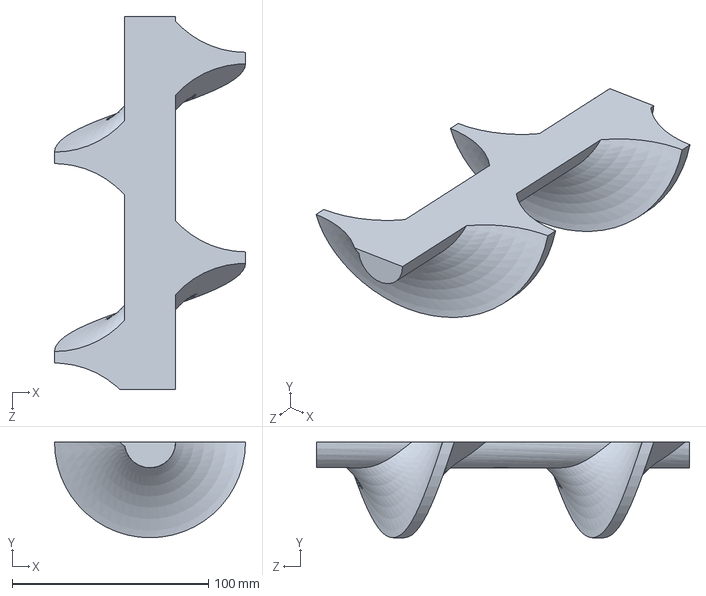
[picture p154: CAD file, 2018-11-02]
Solución/Diseño Mecánico/Transportadores/Concentrado/Impresion 3D/Ensamble del TSF Concentrado/5 TSF Concentrado.SLDPRT
97.3 x 48.7 x 190.0 mm
