steveamena/Graduacion/Solución/Diseño Mecánico/Transportadores/Concentrado/Impresion 3D/Tapa Tubo.STL

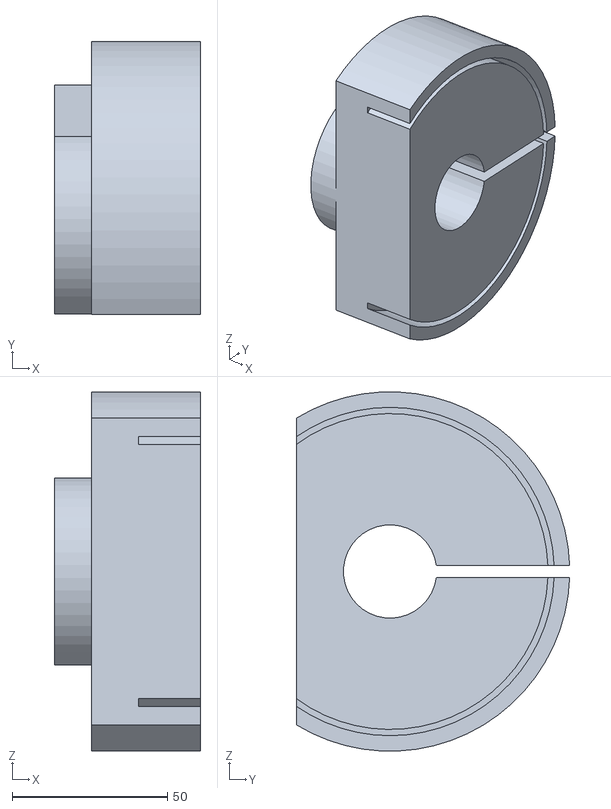
[picture p155: CAD file, 2018-11-02]
Solución/Diseño Mecánico/Transportadores/Concentrado/Impresion 3D/Tapa Tubo.STL
47.0 x 87.9 x 115.5
