steveamena/Graduacion/Solución/Diseño Mecánico/Transportadores/Concentrado/TSF Concentrado Simulation.SLDPRT

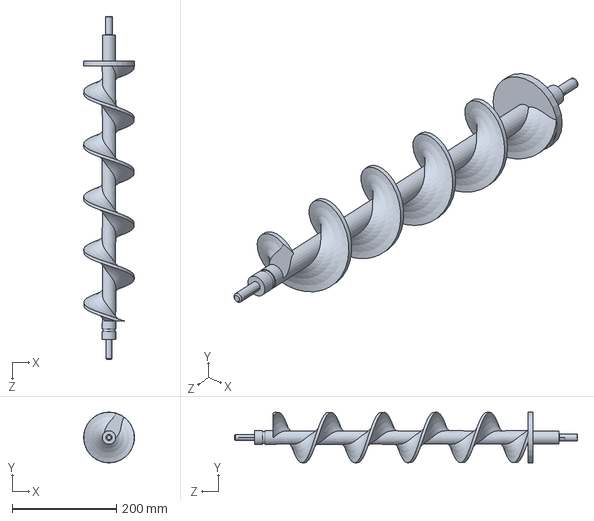
[picture p156: CAD file, 2018-11-02]
Solución/Diseño Mecánico/Transportadores/Concentrado/TSF Concentrado Simulation.SLDPRT
98.0 x 98.0 x 659.4 mm
