steveamena/Graduacion/Solución/Diseño Mecánico/Transportadores/TSF.IGS

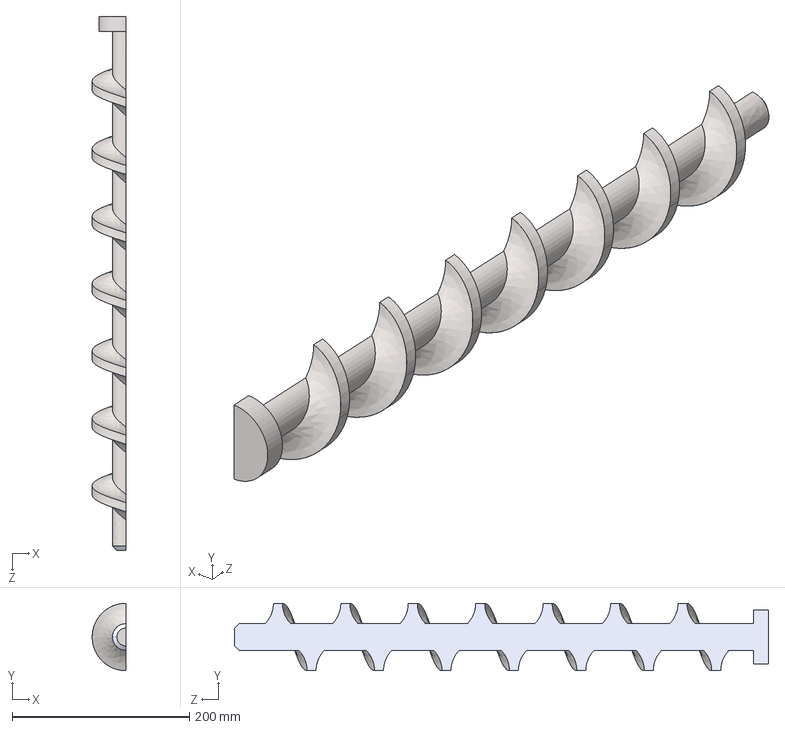
[picture p157: CAD file, 2018-09-20]
Solución/Diseño Mecánico/Transportadores/TSF.IGS
38.1 x 76.2 x 603.4 mm
