steveamena/Graduacion/Solución/Diseño Máquina/Concentrado/Tolva Con.SLDPRT

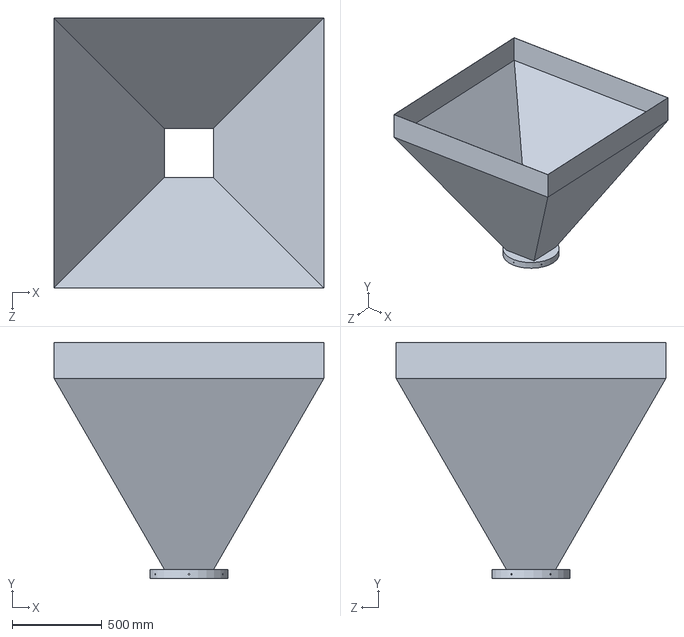
[picture p158: CAD file, 2019-05-12]
Solución/Diseño Máquina/Concentrado/Tolva Con.SLDPRT
1502.0 x 1315.2 x 1502.0 mm
