steveamena/Graduacion/Solución/Diseño Máquina/Esclusas finos/Min Contenedor.SLDPRT

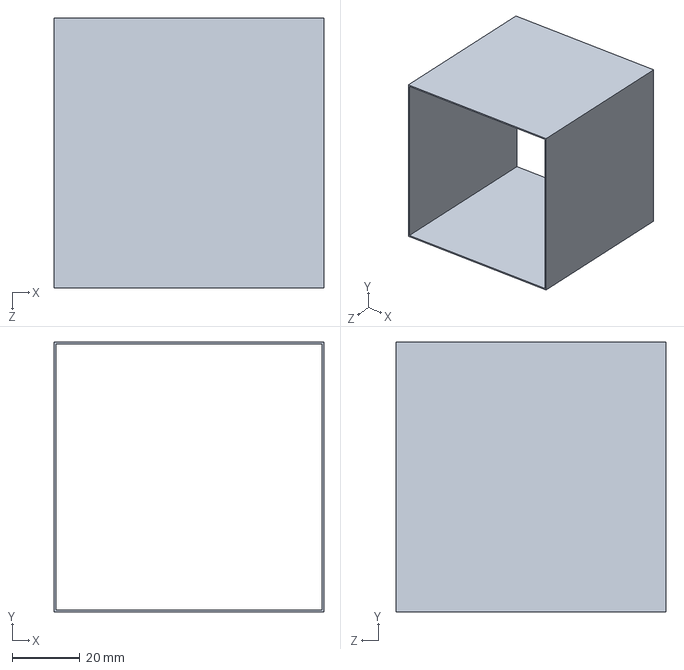
[picture p159: CAD file, 2019-05-12]
Solución/Diseño Máquina/Esclusas finos/Min Contenedor.SLDPRT
80.0 x 80.0 x 80.0 mm
