steveamena/Graduacion/Solución/Diseño Máquina/Prueba Vertical/MotoReductor.SLDPRT

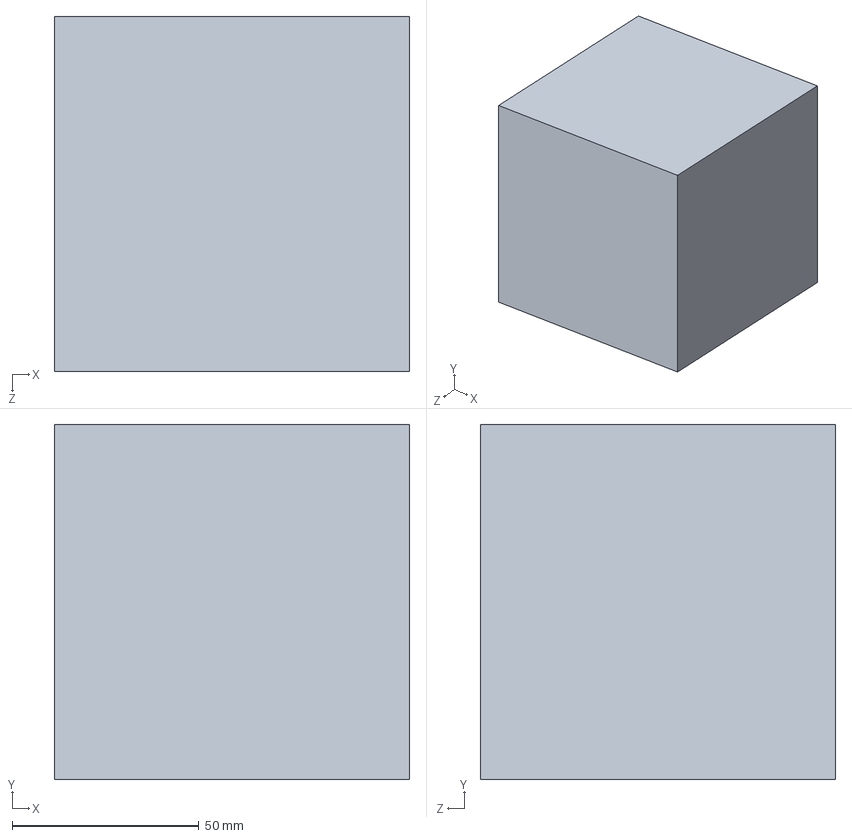
[picture p160: CAD file, 2019-05-30]
Solución/Diseño Máquina/Prueba Vertical/MotoReductor.SLDPRT
95.0 x 95.0 x 95.0 mm
