steveamena/Graduacion/Solución/Diseño Máquina/Tolvas Romana/Cilindro/16N2A10A050 Cilindro.sldprt

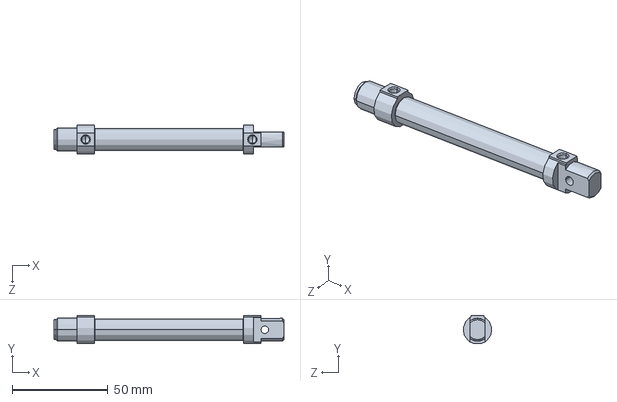
[picture p161: CAD file, 2019-05-08]
Solución/Diseño Máquina/Tolvas Romana/Cilindro/16N2A10A050 Cilindro.sldprt
120.0 x 14.8 x 14.9 mm
