steveamena/Graduacion/Solución/Diseño Máquina/Tolvas Romana/Tal 220.SLDPRT

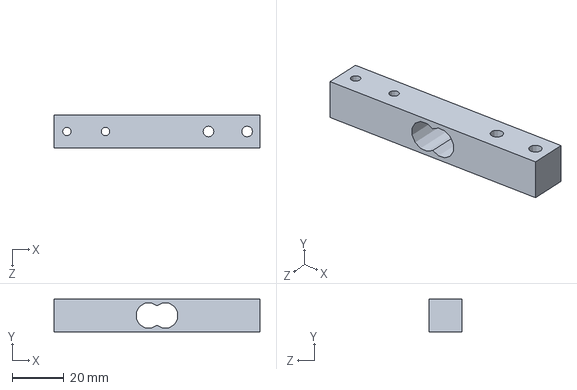
[picture p162: CAD file, 2019-05-08]
Solución/Diseño Máquina/Tolvas Romana/Tal 220.SLDPRT
80.0 x 12.7 x 12.7 mm
