steveamena/Graduacion/Solución/Diseño Mecánico/Diseños conceptuales/Propuesta 2/Bastidor adicional.SLDPRT

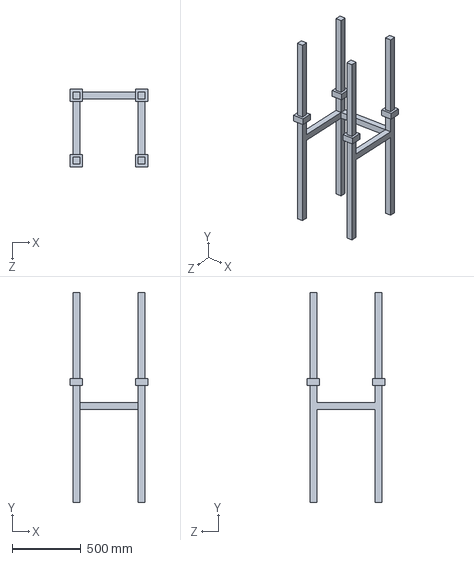
[picture p163: CAD file, 2018-10-02]
Solución/Diseño Mecánico/Diseños conceptuales/Propuesta 2/Bastidor adicional.SLDPRT
564.3 x 1528.0 x 564.3 mm
