steveamena/Graduacion/Solución/Diseño Mecánico/Diseños conceptuales/Propuesta 2/Piston Pequeño/Piston pequeño.SLDPRT

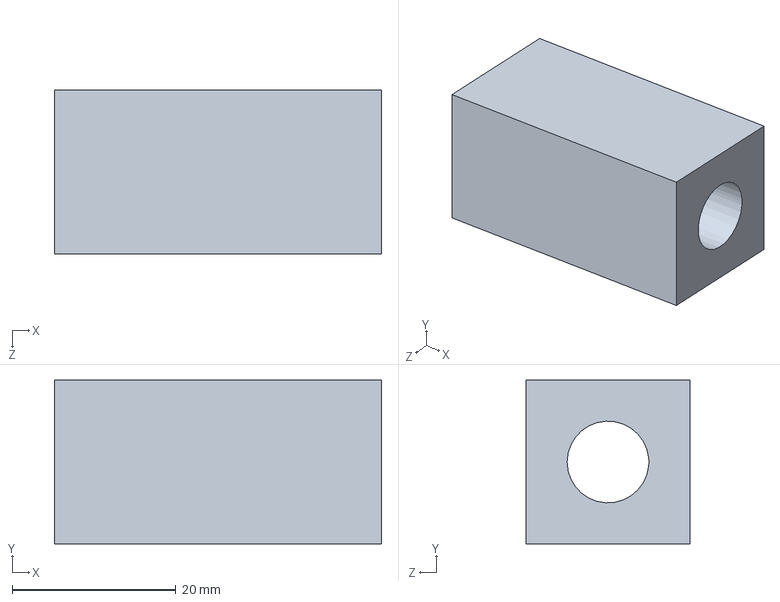
[picture p164: CAD file, 2018-10-02]
Solución/Diseño Mecánico/Diseños conceptuales/Propuesta 2/Piston Pequeño/Piston pequeño.SLDPRT
40.0 x 20.0 x 20.0 mm
