steveamena/Graduacion/Solución/Diseño Mecánico/Diseños conceptuales/Propuesta final Contenedores Angulo/Esclusa Mineral.SLDPRT

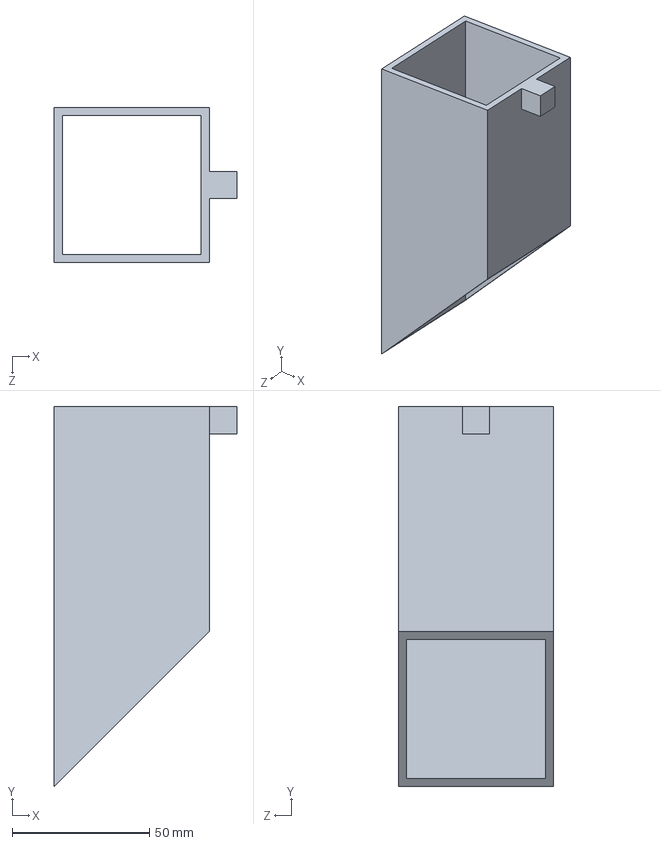
[picture p165: CAD file, 2018-11-02]
Solución/Diseño Mecánico/Diseños conceptuales/Propuesta final Contenedores Angulo/Esclusa Mineral.SLDPRT
66.5 x 138.4 x 56.5 mm
