steveamena/Graduacion/Solución/Diseño Mecánico/Diseños conceptuales/Propuesta prototipo construcción/Alternativa levadura/Stepper Motor.SLDPRT

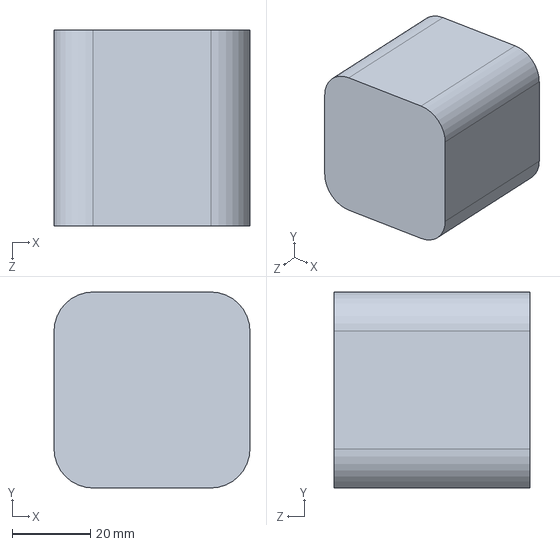
[picture p166: CAD file, 2018-10-02]
Solución/Diseño Mecánico/Diseños conceptuales/Propuesta prototipo construcción/Alternativa levadura/Stepper Motor.SLDPRT
50.0 x 50.0 x 50.0 mm
