steveamena/Graduacion/Solución/Diseño Mecánico/Diseños conceptuales/Propuesta prototipo construcción/Dosificador concentrado/Tapa Tubo.SLDPRT

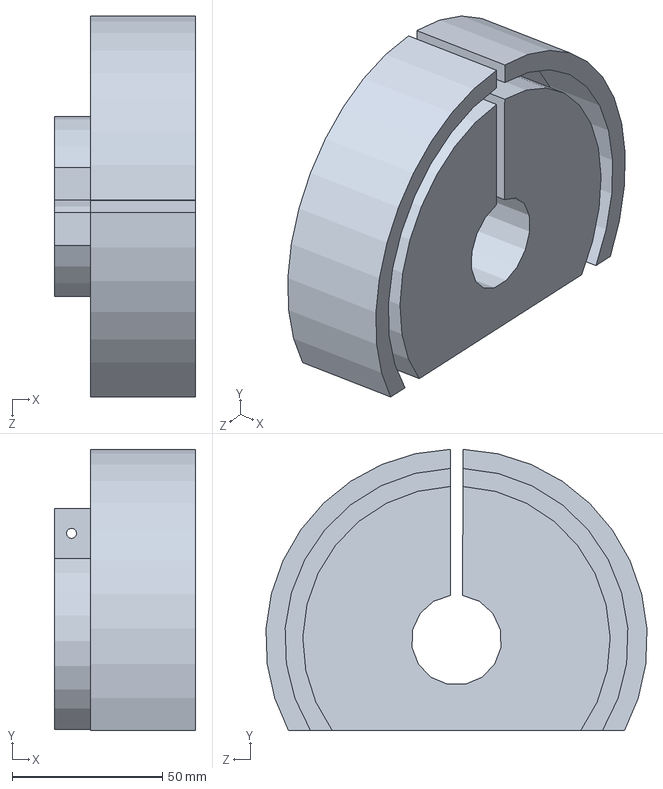
[picture p167: CAD file, 2019-02-25]
Solución/Diseño Mecánico/Diseños conceptuales/Propuesta prototipo construcción/Dosificador concentrado/Tapa Tubo.SLDPRT
47.0 x 93.6 x 126.8 mm
