steveamena/Graduacion/Solución/Diseño Mecánico/Diseños conceptuales/Propuesta prototipo construcción/Ensamble levadura/Bastidor.SLDPRT

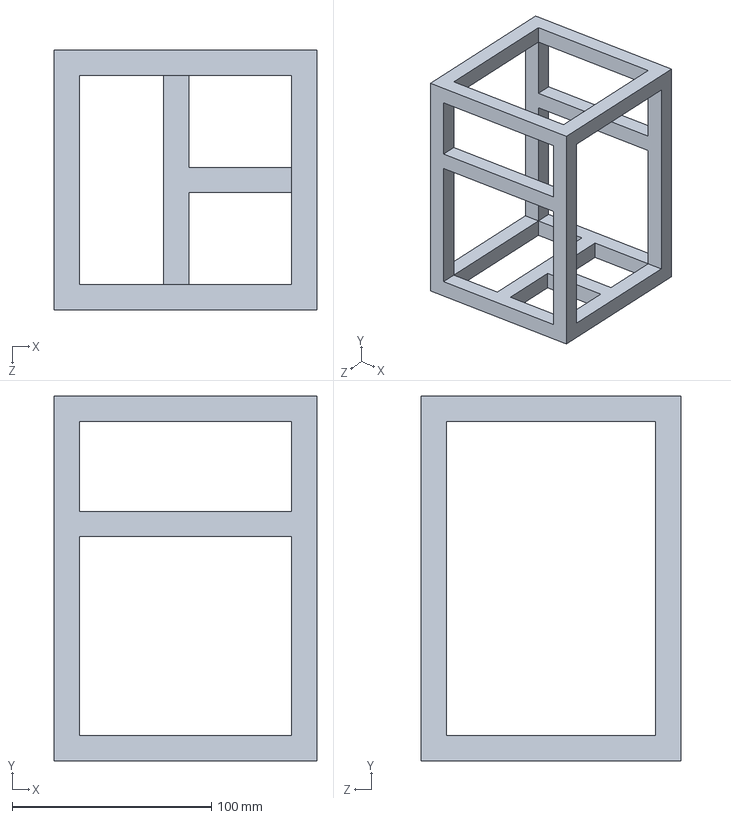
[picture p168: CAD file, 2018-10-02]
Solución/Diseño Mecánico/Diseños conceptuales/Propuesta prototipo construcción/Ensamble levadura/Bastidor.SLDPRT
132.0 x 183.4 x 130.6 mm
