steveamena/Graduacion/Solución/Diseño Mecánico/Diseños conceptuales/Propuesta prototipo construcción/Tolva Concentrado.SLDPRT

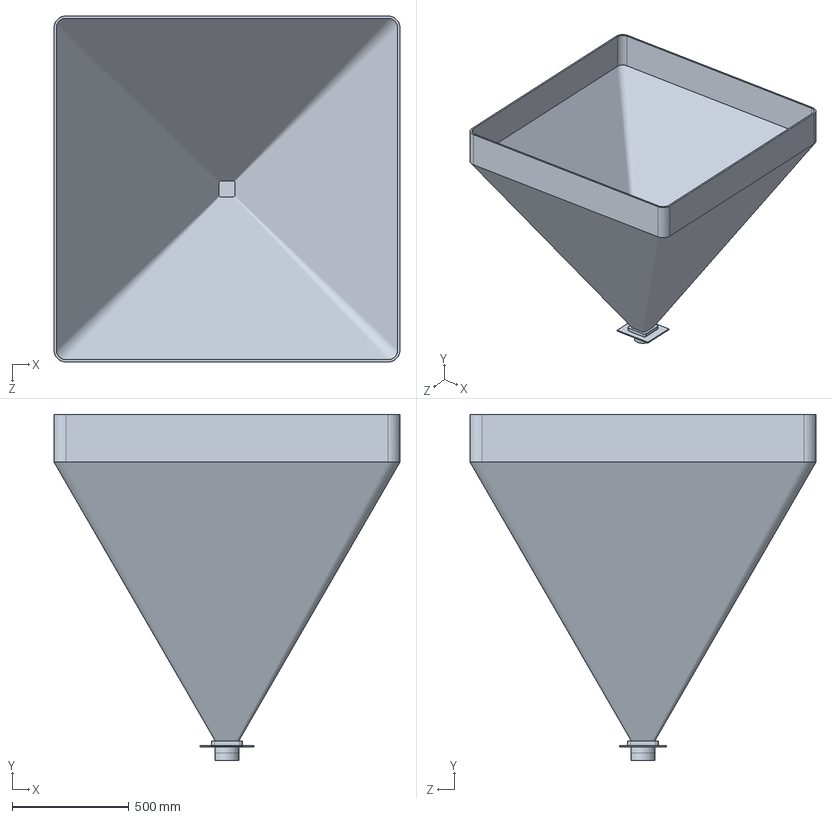
[picture p169: CAD file, 2019-02-25]
Solución/Diseño Mecánico/Diseños conceptuales/Propuesta prototipo construcción/Tolva Concentrado.SLDPRT
1483.6 x 1485.2 x 1483.6 mm
