steveamena/Graduacion/Solución/Diseño Mecánico/Diseños conceptuales/Propuesta prototipo construcción/Tolva Romana/Base Romana.SLDPRT

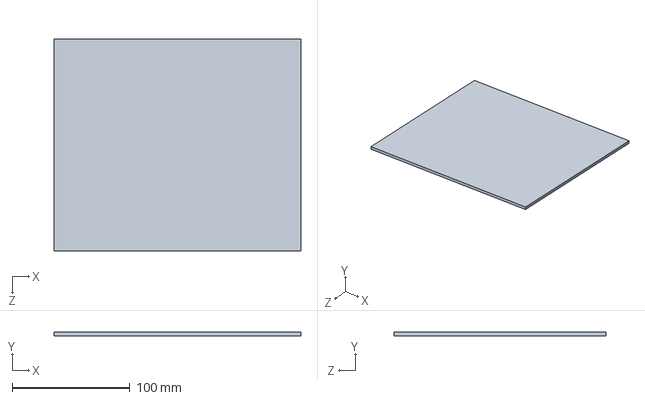
[picture p170: CAD file, 2018-10-02]
Solución/Diseño Mecánico/Diseños conceptuales/Propuesta prototipo construcción/Tolva Romana/Base Romana.SLDPRT
210.0 x 3.17 x 180.0 mm
