steveamena/Graduacion/Solución/Diseño Mecánico/Esclusas/Adicional/EscAdicServo.SLDPRT

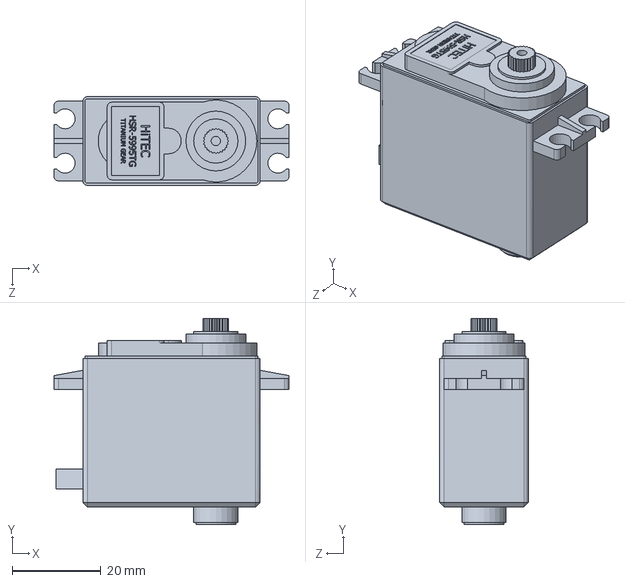
[picture p171: CAD file, 2018-09-04]
Solución/Diseño Mecánico/Esclusas/Adicional/EscAdicServo.SLDPRT
53.0 x 46.5 x 20.0 mm
