steveamena/Graduacion/Solución/Diseño Mecánico/Esclusas/Caja Rosita/LateralCaja.SLDPRT

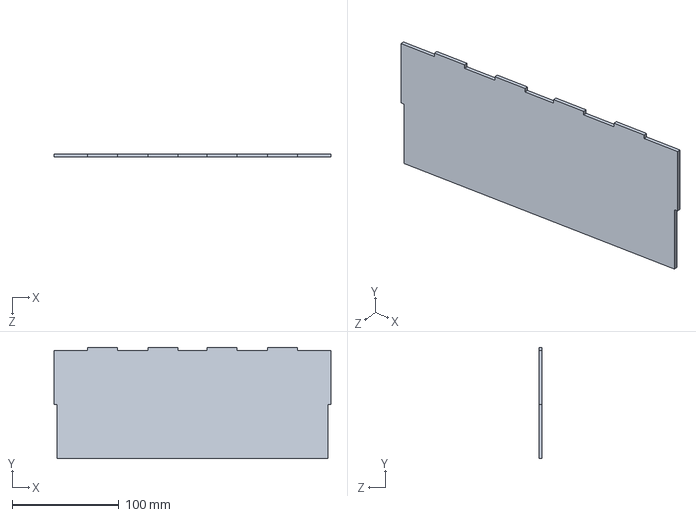
[picture p172: CAD file, 2018-09-20]
Solución/Diseño Mecánico/Esclusas/Caja Rosita/LateralCaja.SLDPRT
260.0 x 104.6 x 3.00 mm
