steveamena/Graduacion/Solución/Diseño Mecánico/Esclusas/Concentrado/EscConcPin.SLDPRT

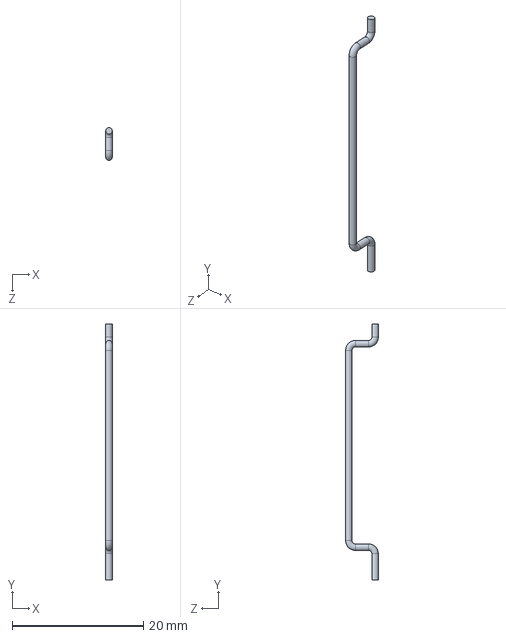
[picture p173: CAD file, 2018-09-04]
Solución/Diseño Mecánico/Esclusas/Concentrado/EscConcPin.SLDPRT
1.00 x 39.0 x 5.00 mm
