steveamena/Graduacion/Solución/Diseño Mecánico/Esclusas/Levadura/LevEscPin.SLDPRT

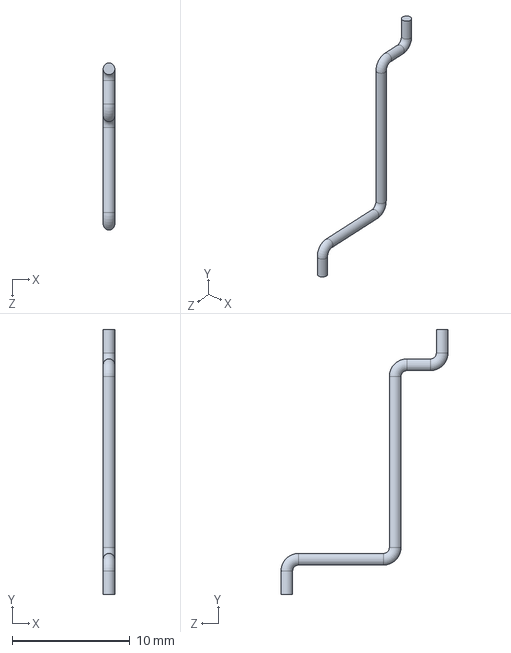
[picture p174: CAD file, 2018-09-20]
Solución/Diseño Mecánico/Esclusas/Levadura/LevEscPin.SLDPRT
1.00 x 22.5 x 14.2 mm
