steveamena/Graduacion/Solución/Diseño Mecánico/Diseños conceptuales/Propuesta 2/Piston Pequeño/Piston Ensamble Pequeño.SLDASM

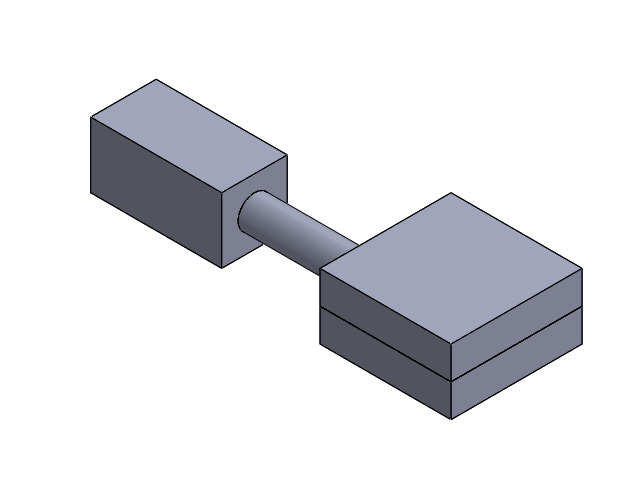
[picture p175: CAD file, 2018-10-02]
Solución/Diseño Mecánico/Diseños conceptuales/Propuesta 2/Piston Pequeño/Piston Ensamble Pequeño.SLDASM
Compuerta Fija Pequeña
Compuerta Deslizante Pequeña
Piston pequeño
