steveamena/Graduacion/(list of files, cad)

Other CAD files:
Solución/Diseño Máquina/Tolvas Romana/Cilindro/16N2A10A050___0N_.sldasm
Solución/Diseño Mecánico/Diseños conceptuales/Propuesta 2/Dosificadora Levadura.SLDASM
Pieza6.SLDPRT
Solución/Desarrollo Conceptos.dwg
Solución/Diseño Mecánico/Medición de masas/Análisis de la tolva.SLDPRT
Solución/Diseño Mecánico/Transportadores/Adicional/Impresion 3D/4 TSF Adicional.STL
Solución/Diseño Máquina/Esclusas finos/Perfiles/1-2 x 1-2.SLDPRT
0.75 x 0.75 x 1-16.SLDPRT
Solución/Diseño Mecánico/Diseños conceptuales/Propuesta prototipo construcción/Dosificador Citrocon/YAR 203_12-2F-24 CC.SLDPRT
Solución/Diseño Mecánico/Transportadores/Mineral/1-2 Mineral TSF.STL
Solución/Diseño Máquina/Tolvas Romana/Hinger2.SLDPRT
Solución/Diseño Mecánico/Diseños conceptuales/Propuesta prototipo construcción/Alternativa levadura/Tolva Levadura.SLDPRT
Solución/Diseño Mecánico/Diseños conceptuales/Propuesta prototipo construcción/Dosificador concentrado/YAR 203_12-2F-24.SLDPRT
Solución/Diseño Mecánico/Diseños conceptuales/Propuesta prototipo construcción/Tolva Romana/STEPPER - 17PM-K348B.stp
Solución/Diseño Mecánico/Transportadores/Mineral/TSF Mineral Superior.STL
Solución/Diseño Mecánico/Diseños conceptuales/Propuesta prototipo construcción/Dosificador Citrocon/Tapa PVC 3 in SCH40.SLDPRT
Screw Coveyor.dwg
Solución/Diseño Mecánico/Caja Neumatica/Cortes (2).SLDDRW
Solución/Diseño Mecánico/Caja Neumatica/Cortes.SLDDRW
Solución/Diseño Mecánico/Caja Neumatica/Frente (2).SLDPRT
Solución/Diseño Mecánico/Caja Neumatica/Frente.SLDPRT
Solución/Diseño Mecánico/Caja Neumatica/Lados.SLDPRT
Solución/Diseño Mecánico/Caja Neumatica/Piso.SLDPRT
Solución/Diseño Mecánico/Caja Neumatica/Superior.SLDPRT
Solución/Diseño Mecánico/Caja Neumatica/Tapa.SLDPRT
Solución/Diseño Mecánico/Diseños conceptuales/Propuesta 1/Alternativa levadura/Carrete Medidas Levadura.SLDPRT
Solución/Diseño Mecánico/Diseños conceptuales/Propuesta 1/Alternativa levadura/Dosificadora Levadura.SLDASM
Solución/Diseño Mecánico/Diseños conceptuales/Propuesta 1/Alternativa levadura/Stepper Motor.SLDPRT
Solución/Diseño Mecánico/Diseños conceptuales/Propuesta 1/Alternativa levadura/Tolva Levadura.SLDPRT
Solución/Diseño Mecánico/Diseños conceptuales/Propuesta 1/Celda de Carga.SLDPRT
Solución/Diseño Mecánico/Diseños conceptuales/Propuesta 1/Dosificadora Levadura.SLDASM
Solución/Diseño Mecánico/Diseños conceptuales/Propuesta 1/Esclusa Mineral.SLDPRT
Solución/Diseño Mecánico/Diseños conceptuales/Propuesta 1/Tolva Adicional.SLDPRT
Solución/Diseño Mecánico/Diseños conceptuales/Propuesta 1/Tolva Concentrado.SLDPRT
Solución/Diseño Mecánico/Diseños conceptuales/Propuesta 1/Tolva Levadura.SLDPRT
Solución/Diseño Mecánico/Diseños conceptuales/Propuesta 1/Tolva Mineral.SLDPRT
Solución/Diseño Mecánico/Diseños conceptuales/Propuesta 2/Banda Transportadora.SLDPRT
Solución/Diseño Mecánico/Diseños conceptuales/Propuesta 2/Bastidor concentrado.SLDPRT
Solución/Diseño Mecánico/Diseños conceptuales/Propuesta 2/Carrete Medidas Levadura.SLDPRT
Solución/Diseño Mecánico/Diseños conceptuales/Propuesta 2/Cono.SLDPRT
Solución/Diseño Mecánico/Diseños conceptuales/Propuesta 2/Piston Pequeño/Soporte Piston.SLDPRT
Solución/Diseño Mecánico/Diseños conceptuales/Propuesta 2/Piston/Soporte Piston.SLDPRT
Solución/Diseño Mecánico/Diseños conceptuales/Propuesta 2/Stepper Motor.SLDPRT
Solución/Diseño Mecánico/Diseños conceptuales/Propuesta 2/Tolva Adicional.SLDPRT
Solución/Diseño Mecánico/Diseños conceptuales/Propuesta 2/Tolva Concentrado.SLDPRT
Solución/Diseño Mecánico/Diseños conceptuales/Propuesta 2/Tolva Mineral.SLDPRT
Solución/Diseño Mecánico/Diseños conceptuales/Propuesta 3/Alternativa levadura/Carrete Medidas Levadura.SLDPRT
Solución/Diseño Mecánico/Diseños conceptuales/Propuesta 3/Alternativa levadura/Dosificadora Levadura.SLDASM
Solución/Diseño Mecánico/Diseños conceptuales/Propuesta 3/Alternativa levadura/Stepper Motor.SLDPRT
Solución/Diseño Mecánico/Diseños conceptuales/Propuesta 3/Alternativa levadura/Tolva Levadura.SLDPRT
Solución/Diseño Mecánico/Diseños conceptuales/Propuesta 3/Bastidor.SLDPRT
Solución/Diseño Mecánico/Diseños conceptuales/Propuesta 3/Celda de Carga.SLDPRT
Solución/Diseño Mecánico/Diseños conceptuales/Propuesta 3/Cono.SLDPRT
Solución/Diseño Mecánico/Diseños conceptuales/Propuesta 3/Dosificadora Levadura.SLDASM
Solución/Diseño Mecánico/Diseños conceptuales/Propuesta 3/Esclusa Concentrado.SLDPRT
Solución/Diseño Mecánico/Diseños conceptuales/Propuesta 3/Esclusa Mineral.SLDPRT
Solución/Diseño Mecánico/Diseños conceptuales/Propuesta 3/Mesa Vibrador.SLDPRT
Solución/Diseño Mecánico/Diseños conceptuales/Propuesta 3/Mesa de Trabajo.SLDPRT
Solución/Diseño Mecánico/Diseños conceptuales/Propuesta 3/MotorCompuerta.SLDPRT
Solución/Diseño Mecánico/Diseños conceptuales/Propuesta 3/Stepper Motor.SLDPRT
Solución/Diseño Mecánico/Diseños conceptuales/Propuesta 3/Tambor Rotatorio.SLDPRT
Solución/Diseño Mecánico/Diseños conceptuales/Propuesta 3/Tolva Adicional.SLDPRT
Solución/Diseño Mecánico/Diseños conceptuales/Propuesta 3/Tolva Concentrado.SLDPRT
Solución/Diseño Mecánico/Diseños conceptuales/Propuesta 3/Tolva Levadura.SLDPRT
Solución/Diseño Mecánico/Diseños conceptuales/Propuesta 3/Tolva Mineral.SLDPRT
Solución/Diseño Mecánico/Diseños conceptuales/Propuesta 3/TolvaGeneral.SLDPRT
Solución/Diseño Mecánico/Diseños conceptuales/Propuesta final Contenedores Angulo/Armazon Angulo.SLDPRT
Solución/Diseño Mecánico/Diseños conceptuales/Propuesta final Contenedores Angulo/Bastidor.SLDPRT
Solución/Diseño Mecánico/Diseños conceptuales/Propuesta final Contenedores Angulo/Cono.SLDPRT
Solución/Diseño Mecánico/Diseños conceptuales/Propuesta final Contenedores Angulo/Ensamble levadura/A Levadura.SLDASM
Solución/Diseño Mecánico/Diseños conceptuales/Propuesta final Contenedores Angulo/Ensamble levadura/Bastidor.SLDPRT
Solución/Diseño Mecánico/Diseños conceptuales/Propuesta final Contenedores Angulo/Ensamble levadura/Superior Stop.SLDPRT
Solución/Diseño Mecánico/Diseños conceptuales/Propuesta final Contenedores Angulo/Ensamble levadura/Tolva Levadura.SLDPRT
Solución/Diseño Mecánico/Diseños conceptuales/Propuesta final Contenedores Angulo/Ensamble levadura/Vibrador.SLDPRT
Solución/Diseño Mecánico/Diseños conceptuales/Propuesta final Contenedores Angulo/LevCelCarga.SLDPRT
Solución/Diseño Mecánico/Diseños conceptuales/Propuesta final Contenedores Angulo/Suministrador/A Suministrador.SLDASM
Solución/Diseño Mecánico/Diseños conceptuales/Propuesta final Contenedores Angulo/Suministrador/Basuca.SLDPRT
Solución/Diseño Mecánico/Diseños conceptuales/Propuesta final Contenedores Angulo/Tolva Adicional Angulo.SLDPRT
Solución/Diseño Mecánico/Diseños conceptuales/Propuesta final Contenedores Angulo/Tolva Concentrado Angulo.SLDPRT
Solución/Diseño Mecánico/Diseños conceptuales/Propuesta final Contenedores Angulo/Tolva Romana.SLDPRT
Solución/Diseño Mecánico/Diseños conceptuales/Propuesta final Contenedores Angulo/Tolva concentrado Plano.SLDDRW
Solución/Diseño Mecánico/Diseños conceptuales/Propuesta final Contenedores Angulo/Tolva concentrado.SLDPRT
Solución/Diseño Mecánico/Diseños conceptuales/Propuesta final Contenedores Angulo/UberCow/A UberCow.SLDASM
Solución/Diseño Mecánico/Diseños conceptuales/Propuesta final Contenedores Angulo/UberCow/BaseCarro.SLDPRT
Solución/Diseño Mecánico/Diseños conceptuales/Propuesta prototipo construcción/10 kg Load cell.SLDPRT
Solución/Diseño Mecánico/Diseños conceptuales/Propuesta prototipo construcción/Armazon.SLDPRT
Solución/Diseño Mecánico/Diseños conceptuales/Propuesta prototipo construcción/Bastidor.SLDPRT
Solución/Diseño Mecánico/Diseños conceptuales/Propuesta prototipo construcción/Celda de Carga.SLDPRT
Solución/Diseño Mecánico/Diseños conceptuales/Propuesta prototipo construcción/Cono.SLDPRT
Solución/Diseño Mecánico/Diseños conceptuales/Propuesta prototipo construcción/Dosificador Citrocon/Pieza3CC.SLDPRT
Solución/Diseño Mecánico/Diseños conceptuales/Propuesta prototipo construcción/Dosificador Citrocon/TSF CC.SLDPRT
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
