steveamena/Graduacion/Resultados/PFG/Datos/PFG/Main3/datosLevaSinMotor.txt

-5345.11029015	639.052710401	-0.369540174048
Mineral apagado
-5344.17802898	638.588259827	-0.196394120668
-5344.12319009	638.795840798	-0.20541575872
-5344.4887827	640.201514678	0.0975030881761
-5345.16512905	639.615738239	-0.097850074255
-5344.5436216	639.588250348	-0.0503129814432
-5344.34254566	639.723794087	0.0333106635762
-5344.15974935	640.084928105	0.249136004663
-5343.7758771	639.576876049	-0.0575996891005
-5344.41566418	639.792039886	-0.0572527030216
-5344.5436216	639.792987744	-0.00728670765729
-5344.4887827	639.888721434	0.107218698386
-5344.74469754	639.921896475	-0.0430262737859
-5346.31674579	648.410915536	1.95491956863
-5345.31136609	640.453644989	0.422629044123
-5346.62749951	639.150339807	-0.309164596316
-5344.4887827	639.275457105	-0.111382531333
-5344.98233274	642.250784353	-0.465655317909
-5344.68985864	647.441256481	-0.884120529084
-5344.19630861	639.983507265	-0.374050993074
-5345.60384018	640.229002569	0.106524726228
-5345.20168831	640.148434612	0.0392094269178
-5344.67157901	635.969327305	-2.11765603964
-5344.7812568	639.779717728	-1.63846826465
-5345.43932351	635.828096416	-2.24881677747
-5344.76297717	639.332328604	-0.483351607933
-5345.7317976	639.871659984	-0.14122333412
-5344.45222344	639.142756941	-0.656844647393
-5345.56728092	639.475455209	0.152326888645
-5344.79953643	638.842285855	-0.840053297062
-5345.29308646	639.618581814	-0.83415453372
-5345.09201052	638.827120122	-0.962886368999
-5345.00061237	638.346555957	-0.986134436286
-5344.56190123	638.253665842	-0.983358547655
-5344.59846049	638.380678856	-0.865730266902
-5345.7317976	639.523795983	-0.0395564129967
-5344.28770677	640.930417721	0.641230273841
-5344.26942713	642.168320679	0.536787464087
-5344.14146972	639.037544668	-0.969132118419
-5344.21458824	641.98254045	0.251217921137
-5344.74469754	641.810030237	0.278282835293
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
