steveamena/Graduacion/Procesamiento prueba de concepto.xlsx

Sheet: Pitón apertura y cierre
0.001138925552 | 3000 | 0.1398734425 | Ganancia
0.00840306282 | 9870 | 0.4601836259 | 21447.96
0.0199649334 | 10362110 | 483.1279991
0.08223390579 | -10710 | -0.4993481898
0.09364390373 | -3410 | -0.1589894797
0.1052069664 | -1620 | -0.07553165895
0.1169579029 | -3360 | -0.1566582556
0.1282660961 | -2790 | -0.1300823015
0.1394460201 | -4210 | -0.1962890643
0.1514270306 | -16590 | -0.7735001371
0.1626660824 | -24600 | -1.146962229
0.1740310192 | -8250 | -0.3846519669
0.1857481003 | -8890 | -0.4144916346
0.1971318722 | 130 | 0.006061182509
0.2089049816 | 1890 | 0.08812026878
0.2201159 | 2290 | 0.1067700611
0.2313520908 | -8020 | -0.3739283363
0.2433269024 | -10160 | -0.4737047253
0.2545778751 | -80 | -0.003729958467
0.2660219669 | -6950 | -0.3240401418
0.2775940895 | -18260 | -0.8513630201
0.2888031006 | -9140 | -0.4261477548
0.3010349274 | 9330 | 0.4350064062
0.312030077 | 4370 | 0.2037489813
0.3232679367 | -15110 | -0.7044959054
0.3351130486 | -14860 | -0.6928397852
0.3462538719 | -5570 | -0.2596983583
0.3579630852 | -7540 | -0.3515485855
0.3694829941 | 3700 | 0.1725105791
0.3807148933 | 1660 | 0.07739663819
0.3929460049 | -5390 | -0.2513059517
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
