steveamena/Graduacion/Resultados/PFG/Datos/Datos CC.xlsx

Sheet: Sheet1
0.05 | -360.390447 | 0 | 10
0.1 | 27.031317 | 0 | 11
0.15 | 21.914594 | 4.382919 | 12
0.2 | 22.142421 | 8.811403 | 13
0.25 | -553.532934 | 13.239887 | 14
0.3 | 32.051741 | 17.668372 | 15
0.35 | 21.332107 | 21.934793 | 16
0.4 | -40.235327 | 21.818295 | 17
0.45 | 19.449595 | 21.27973 | 18
0.5 | 24.284469 | 21.70814 | 19
0.55 | 23.799455 | 22.039546 | 20
0.6 | 27.498715 | 23.272868 | 21
0.65 | 25.173466 | 24.041139 | 22
0.7 | 23.444796 | 24.84018 | 23
0.75 | 27.269713 | 25.437228 | 24
0.8 | 21.174742 | 24.912286 | 25
0.85 | 29.482223 | 25.308987 | 26
0.9 | 23.804152 | 25.035125 | 27
0.95 | 23.388426 | 25.023851 | 28
1 | 24.85991 | 24.54189 | 29
1.05 | 22.100144 | 24.72697 | 30
1.1 | 21.099582 | 23.050442 | 31
1.15 | 27.963765 | 23.882365 | 32
1.2 | 24.302085 | 24.065097 | 33
1.25 | 26.417122 | 24.376539 | 34
1.3 | 23.080742 | 24.572659 | 35
1.35 | 27.362489 | 25.82524 | 36
1.4 | 19.1607 | 24.064627 | 37
1.45 | 23.999098 | 24.00403 | 38
1.5 | 23.629172 | 23.44644 | 39
1.55 | 24.946813 | 23.819654 | 40
1.6 | 26.852813 | 23.717719 | 41
1.65 | 24.205786 | 24.726736 | 42
1.7 | 18.998637 | 23.726644 | 43
1.75 | 28.751766 | 24.751163 | 44
1.8 | 24.953859 | 24.752572 | 45
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
