steveamena/Graduacion/Resultados/PFG/Datos/PFG/Main3/BALANCE.xlsx

Sheet: RESUMEN
COMPRAS SEMANALES | 2011-04-28 | 2011-05-18 | 2011-06-04 | 2011-06-27 | 2011-07-19 | 2011-08-08 | 2011-09-03 | 2011-10-01 | 2011-10-19 | 2011-10-29 | 2011-12-05 | 2011-12-30 | 2012-01-16 | 2012-01-28 | 2012-03-03 | 2012-04-07 | 2012-04-28 | 2012-05-18 | 2012-06-02 | 2012-07-02 | 2012-07-28 | 2012-09-01 | 2012-09-29 | 2012-10-20 | 2012-11-25 | 2012-12-22 | 2013-01-26 | 2013-02-19 | 2013-03-16 | 2013-03-30 | 2013-04-14 | 2013-05-01 | 2013-05-21 | 2013-06-01 | 2013-06-16 | 2013-06-30 | 2013-07-15 | 2013-08-03 | 2013-08-31 | 2013-09-15 | 2013-09-29 | 2013-10-20 | 2013-11-09 | 2013-12-16 | 2014-01-25 | 2014-02-22 | 2014-03-15 | 2014-03-29 | 2014-04-19 | 2014-05-10 | 2014-06-07 | 2014-09-15 | 2014-10-25 | 2014-11-23 | 2014-12-25 | 2015-02-02 | 2015-02-26 | 2015-03-19
TOTAL DE VACAS EN ORDEÑO | 154 | 157 | 164 | 163 | 164 | 159 | 169 | 166 | 170 | 176 | 160 | 156 | 156 | 144 | 156 | 151 | 153 | 160 | 163 | 161 | 157 | 147 | 151 | 162 | 168 | 161 | 140 | 148 | 152 | 150 | 155 | 154 | 153 | 153 | 150 | 146 | 146 | 135 | 140 | 138 | 138 | 149 | 150 | 144 | 138 | 143 | 144 | 148 | 153 | 161 | 165 | 153 | 156 | 149 | 144 | 143 | 145 | 147
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
