steveamena/Graduacion/Resultados/Tolva Romana/Tolva Romana-Analisis de cargas 15 kg-Imagen-1.jpg

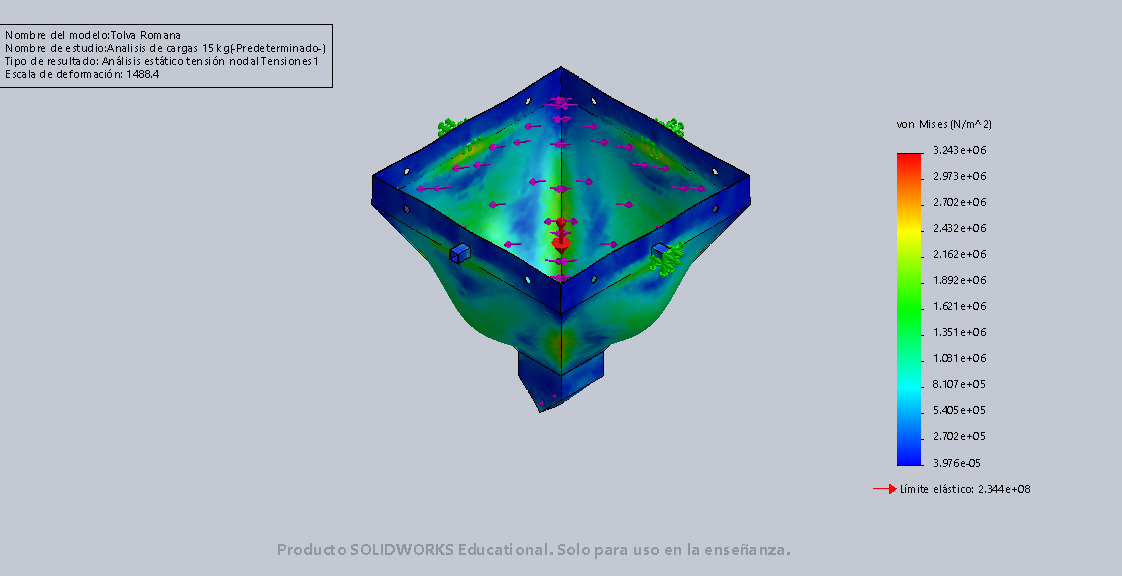
Resultados/Tolva Romana/Tolva Romana-Analisis de cargas 15 kg-Imagen-1.jpg
