steveamena/Graduacion/Solución/Diseño Máquina/Tolvas Romana/Tolva Romana-Carga 22 kg/Tolva Romana-Carga 22 kg-Resultados-Desplazamientos1.png

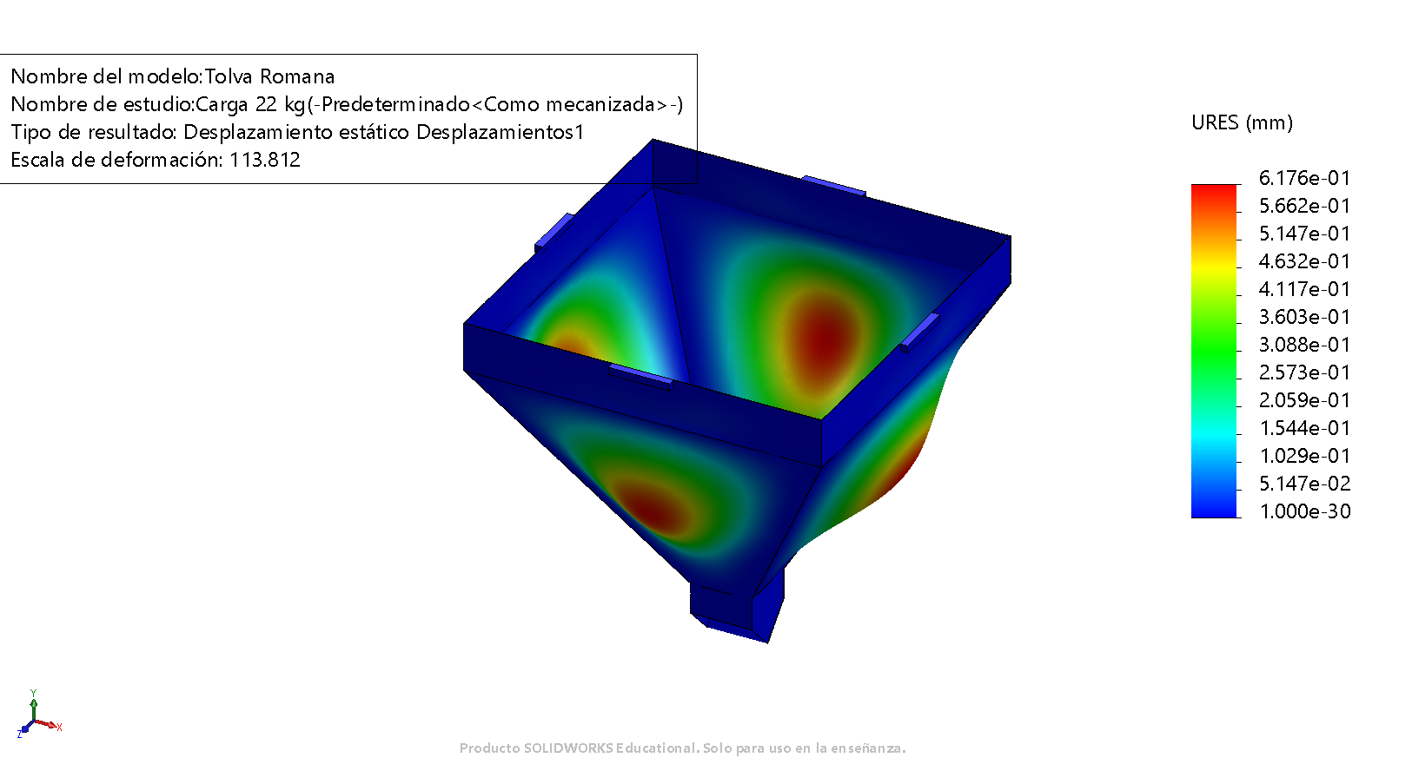
Solución/Diseño Máquina/Tolvas Romana/Tolva Romana-Carga 22 kg/Tolva Romana-Carga 22 kg-Resultados-Desplazamientos1.png
