steveamena/Graduacion/Solución/Diseño Mecánico/Transportadores/Concentrado/TSF Concentrado.PDF

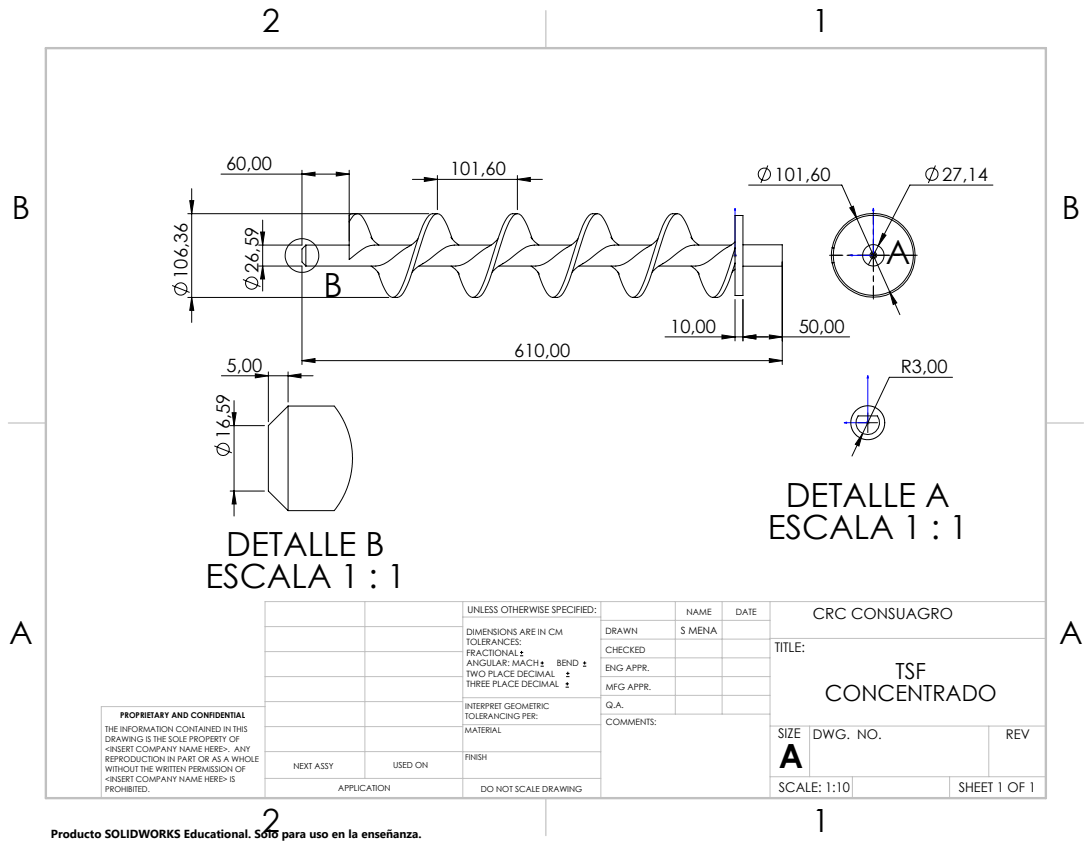
[picture p179: page 1]
DETALLE A ESCALA 1 : 1; DETALLE B ESCALA 1 : 1

UNLESS OTHERWISE SPECIFIED: | | NAME | DATE | CRC CONSUAGRO
DIMENSIONS ARE IN CM TOLERANCES: FRACTIONAL ANGULAR: MACH BEND TWO PLACE DECIMAL THREE PLACE DECIMAL | DRAWN | S MENA

CHECKED | | | TITLE: TSF CONCENTRADO

ENG APPR.
MFG APPR.

INTERPRET GEOMETRIC TOLERANCING PER: | Q.A.

PROPRIETARY AND CONFIDENTIAL
THE INFORMATION CONTAINED IN THIS
DRAWING IS THE SOLE PROPERTY OF
<INSERT COMPANY NAME HERE>. ANY
REPRODUCTION IN PART OR AS A WHOLE
WITHOUT THE WRITTEN PERMISSION OF
<INSERT COMPANY NAME HERE> IS
PROHIBITED.

USED ON | MATERIAL | | SIZE A | DWG. NO. | REV

NEXT ASSY | | FINISH

APPLICATION | DO NOT SCALE DRAWING | | SCALE: 1:10 | | SHEET 1 OF 1

Producto SOLIDWORKS Educational. Solo para uso en la enseñanza.
