steveamena/Graduacion/Solución/Diseño Mecánico/Caja Neumatica/Cortes Esclusas.PDF

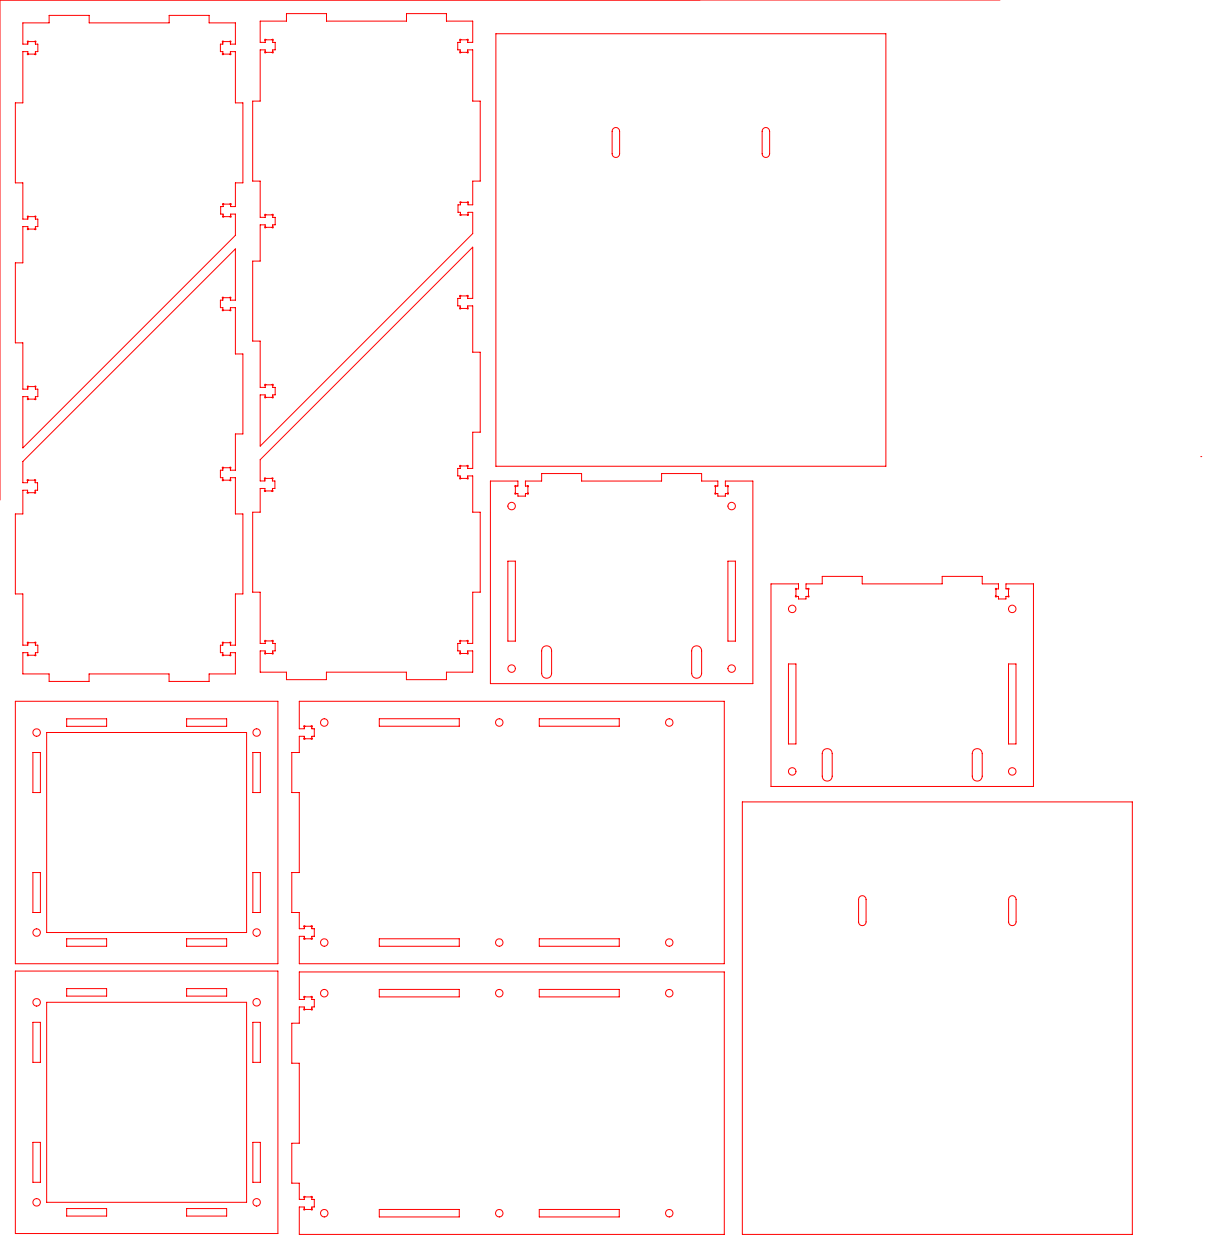
[picture p180: page 1]
