steveamena/Graduacion/Solución/Diseño Mecánico/Medición de masas/Dibujo Tolva Romana.PDF

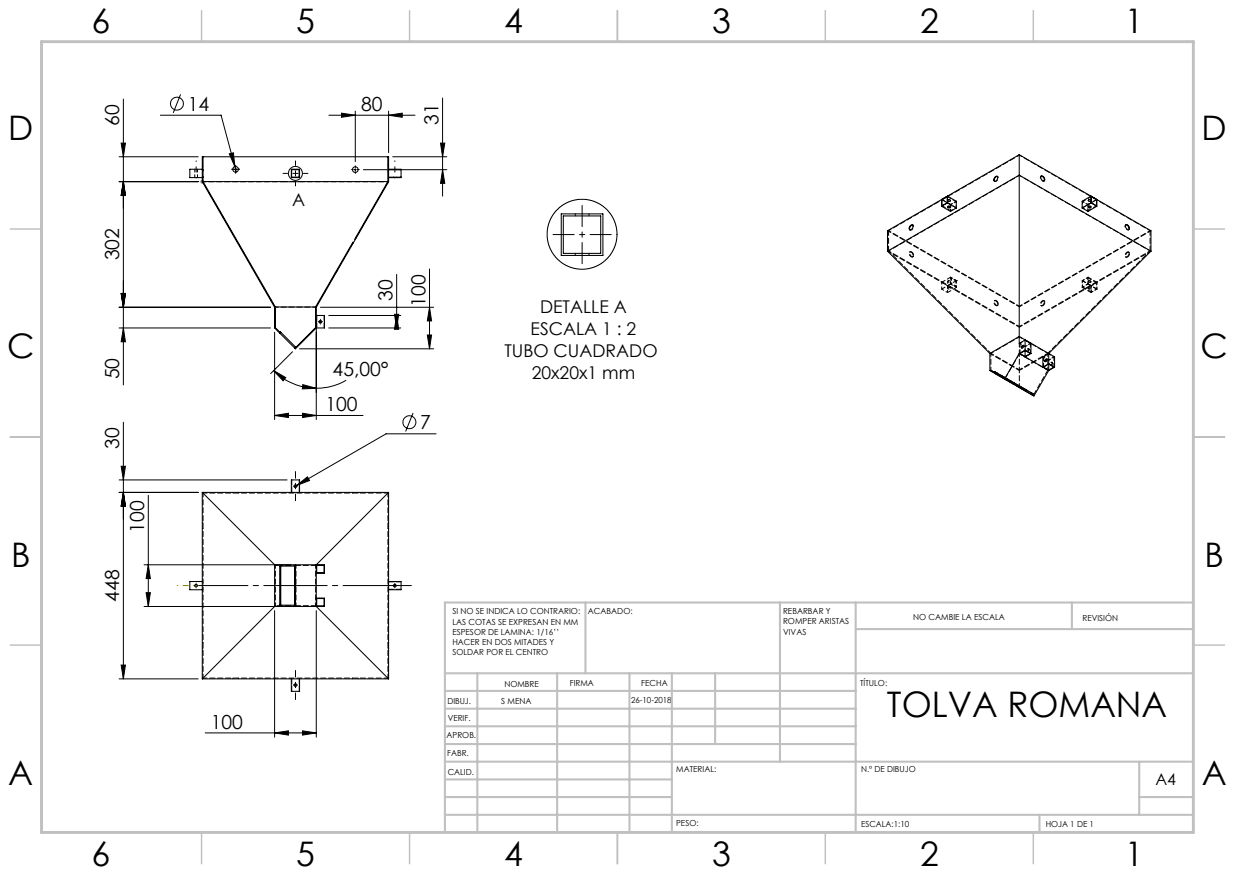
[picture p181: page 1]
DETALLE A ESCALA 1 : 2 TUBO CUADRADO 20x20x1 mm; ACABADO:; REBARBAR Y; ROMPER ARISTAS; NO CAMBIE LA ESCALA; REVISIÓN; ESCALA:1:10; HOJA 1 DE 1

SI NO SE INDICA LO CONTRARIO:
LAS COTAS SE EXPRESAN EN MM
ESPESOR DE LAMINA: 1/16’’
HACER EN DOS MITADES Y
SOLDAR POR EL CENTRO

DIBUJ. | S MENA | | 26-10-2018

NOMBRE | FIRMA | FECHA | | | | TÍTULO: TOLVA ROMANA

VERIF.
APROB.
FABR.
CALID. | | | | MATERIAL: | N.º DE DIBUJO | A4
