steveamena/Graduacion/Solución/Diseño Mecánico/Esclusas/Distribucion Lamina Acrilico.PDF

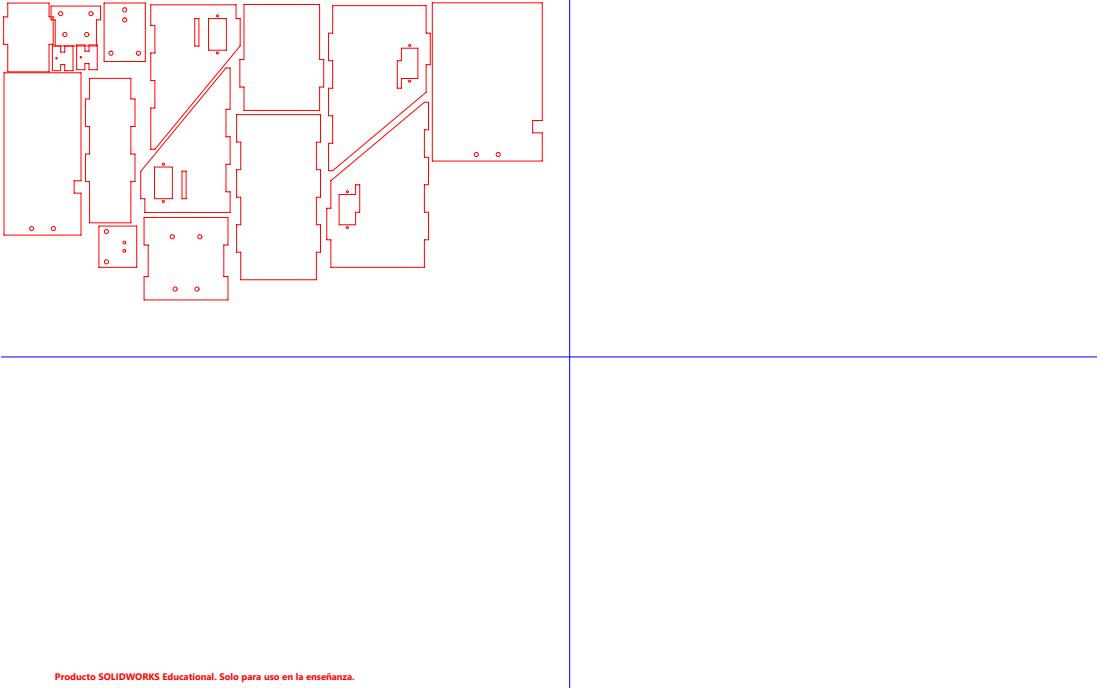
[picture p182: page 1]

Producto SOLIDWORKS Educational. Solo para uso en la enseñanza.
