steveamena/Graduacion/Solución/Diseño Mecánico/Esclusas/Caja Rosita/CajaCortes.PDF

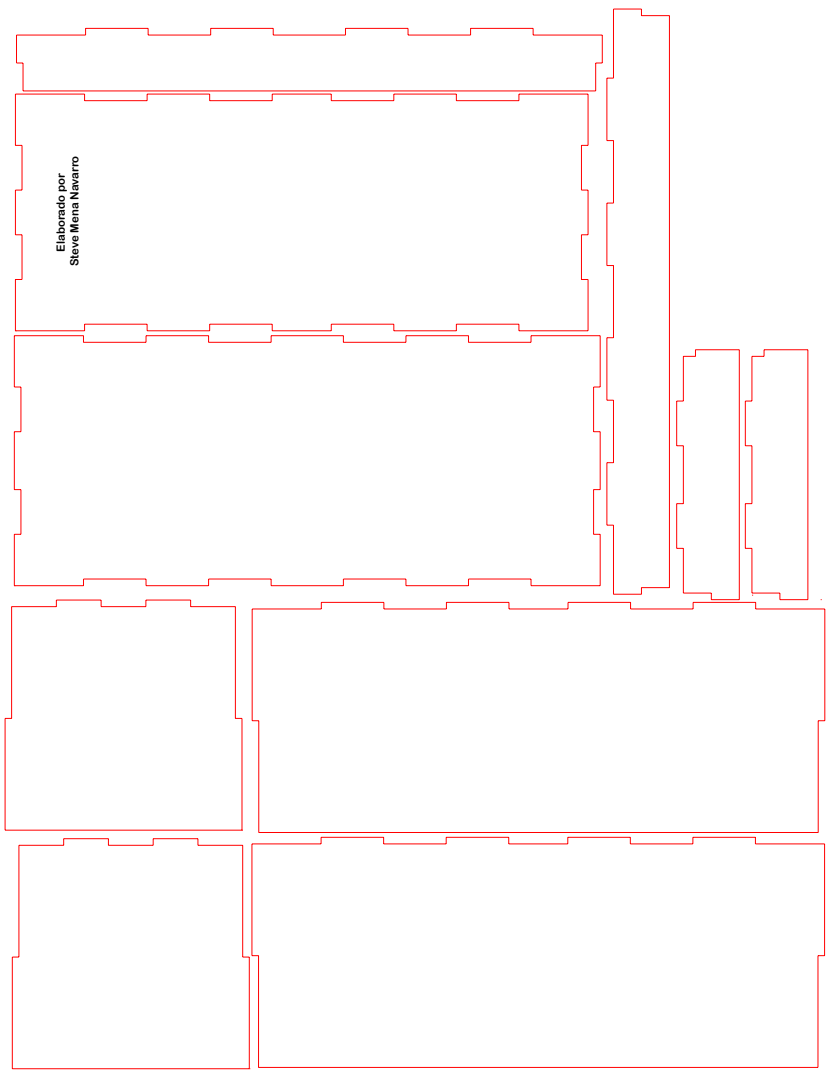
[picture p183: page 1]
Elaborado por

Steve Mena Navarro
