steveamena/Graduacion/Resultados/PFG/Datos/PFG/Main3/interrupt2.py

#!/usr/bin/env python2.7  
# script by Alex Eames https://raspi.tv  
  
import RPi.GPIO as GPIO  
GPIO.setmode(GPIO.BCM)  
global  contador 
contador = 0 
# GPIO 23 & 24 set up as inputs. One pulled up, the other down.  
# 23 will go to GND when button pressed and 24 will go to 3V3 (3.3V)  
# this enables us to demonstrate both rising and falling edge detection  
GPIO.setup(23, GPIO.IN, pull_up_down=GPIO.PUD_DOWN)  
GPIO.setup(24, GPIO.IN, pull_up_down=GPIO.PUD_DOWN)  
  
# now we'll define the threaded callback function  
# this will run in another thread when our event is detected  
def my_callback(channel):  
	global contador
	contador = contador + 1
	print contador
  
print "Make sure you have a button connected so that when pressed"  
print "it will connect GPIO port 23 (pin 16) to GND (pin 6)\n"  
print "You will also need a second button connected so that when pressed"  
print "it will connect GPIO port 24 (pin 18) to 3V3 (pin 1)"  
raw_input("Press Enter when ready\n>")  
  
# The GPIO.add_event_detect() line below set things up so that  
# when a rising edge is detected on port 24, regardless of whatever   
# else is happening in the program, the function "my_callback" will be run  
# It will happen even while the program is waiting for  
# a falling edge on the other button.  
GPIO.add_event_detect(24, GPIO.RISING, callback=my_callback)  

try:  
    print "Waiting for falling edge on port 23"  
    GPIO.wait_for_edge(23, GPIO.FALLING)  
    print "Falling edge detected. Here endeth the second lesson."  
  
except KeyboardInterrupt:  
    GPIO.cleanup()       # clean up GPIO on CTRL+C exit  
GPIO.cleanup()           # clean up GPIO on normal exit
