steveamena/Graduacion/Resultados/PFG/Datos/PFG/Main3/Testing/MineralLevadura.py

## Codigo para probar el funcionamiento de las celdas de carga del mineral y levadura
## Steve Mena Navarro PFG
## 16/5/2019
## GC@2019

from dosificadora import Dosificadora

TolvaRomana = Dosificadora()
TolvaRomana.probarCeldasMinLev(10)
