steveamena/Graduacion/(commit log)

2018-06-22 Anteproyecto V3
    [Presupuesto - Estimaciones iniciales.xlsx, Presupuesto.xlsx]
2018-06-26 Version 3
    [Presupuesto - Estimaciones iniciales proyecto completo.xlsx]
2018-08-03 Cotización células de carga
2018-08-08 Cambios se me olvido la llave maya
2018-08-08 Gantt para mi
2018-08-09 Diseño prueba de concepto tolva
    [Desarrollo Conceptos.dwg]
2018-08-17 16-08-2018 3
    [LevEscAtras.SLDPRT, LevEscAtras2.SLDPRT, LevEscCompuerta.SLDPRT, LevEscLateral.SLDPRT, ServoHorn.SLDPRT, asmLevEsc.SLDASM]
2018-08-20 Diseno esclusas Min Lev
    [HingeAsm.SLDASM, Hinger1.SLDPRT, Hinger2.SLDPRT, LevCelCarga.SLDPRT, LevEscAtras.SLDPRT, LevEscAtras2.SLDPRT, LevEscCompuerta.SLDPRT, LevEscFrontal.SLDPRT]
2018-08-24 Reacomodo carpetas
    [Calculo de tolva de adicional.xlsx, Calculo de tolvas.xlsx, Caracteización Alimentos.xlsx, Desarrollo Conceptos.dwg, EscAdic.SLDPRT, EscAdicCompuerta.SLDPRT, EscAdicPin.SLDPRT, EscAdicServo.SLDPRT]
2018-08-24 eliminacion de carpetas
    [HingeAsm.SLDASM, Hinger1.SLDPRT, Hinger2.SLDPRT, LevCelCarga.SLDPRT, LevEscAtras.SLDPRT, LevEscAtras2.SLDPRT, LevEscCompuerta.SLDPRT, LevEscFrontal.SLDPRT]
2018-08-25 Validacion de tolvas listo
    [4V-6V Linear Solenoid.SLDASM, 4V-6V Linear Solenoid.STEP, Calculo de tolvas.xlsx, Distribucion Lamina Acrilico.SLDDRW, EscAdic.SLDPRT, EscAdicDesarrollo.SLDPRT, EscAdicPin.SLDPRT, EscConSolenoideBase.SLDPRT]
2018-09-24 Creacion carpetas documentacion
    [Traking Horas Consuagro.xlsx]
2018-09-25 Propuesta 1 Ensamble
    [Bastidor.SLDPRT, Celda de Carga.SLDPRT, Cono.SLDPRT, Dosificadora Levadura.SLDASM, Esclusa Mineral.SLDPRT, Idea1.SLDASM, MotorCompuerta.SLDPRT, Propuesta de solucion 1.dwg]
2018-09-25 Propuesta 2
    [Banda Transportadora.SLDPRT, Carrete Medidas Levadura.SLDPRT, Cono.SLDPRT, Dosificadora Levadura.SLDASM, Idea 2.SLDASM, Idea1.SLDASM, Soporte Banda.SLDPRT, Stepper Motor.SLDPRT]
2018-09-26 Final entregables
    [Bastidor adicional.SLDPRT, Bastidor concentrado.SLDPRT, Bastidor.SLDPRT, Carrete Medidas Levadura.SLDPRT, Celda de Carga.SLDPRT, Compuerta Deslizante Pequeña.SLDPRT, Compuerta Deslizante.SLDPRT, Compuerta Fija Pequeña.SLDPRT]
2018-10-02 Avance 2 Oct 2018
    [A General.SLDASM, A Levadura.SLDASM, Asm Tolva Romana.SLDASM, Banda Transportadora.SLDPRT, Base Romana.SLDPRT, Bastidor adicional.SLDPRT, Bastidor concentrado.SLDPRT, Bastidor.SLDPRT]
2018-10-03 Propuesta angulo
    [A Adicional Angulo.SLDASM, A Concentrado.SLDASM, A General Angulo.SLDASM, A General.SLDASM, A Levadura.SLDASM, A Suministrador.SLDASM, A UberCow.SLDASM, Armazon.SLDPRT]
2018-11-02 Avance 21 Noviembre 2018
    [1 TSF Concentrado.SLDPRT, 1-2 Mineral TSF.STL, 2 TSF Concentrado.SLDPRT, 3 TSF Concentrado.SLDPRT, 4 TSF Adicional.SLDPRT, 4 TSF Adicional.STL, 4 TSF Concentrado.SLDPRT, 5 TSF Concentrado.SLDPRT]
2019-02-25 Proyecto Semana 4
    [10 kg Load cell.SLDPRT, A General.SLDASM, A Levadura.SLDASM, A Suministrador.SLDASM, A UberCow.SLDASM, Análisis experimento con perturbación.xlsx, Armazon.SLDPRT, Asm Dosificador Mineral.SLDASM]
2019-02-26 PFG 25-2-2019
    [Idea Version 4.dwg]
2019-03-11 Trabajo 11-3-2019
    [16N2A10A050 Cilindro.sldprt, 16N2A10A050 Piston.sldprt, 16N2A10A050___0N_.sldasm, Bastidor.SLDPRT, Calculo de tolvas.xlsx, EN Tolva Romana.SLDASM, HingeAsm.SLDASM, Hinger1.SLDPRT]
2019-03-12 Avance 11-3 Laimi 1
    [Calculo de cilindros.xlsx, Calculo de sensibilidades celda de carga.xlsx, Calculo de tolvas.xlsx, Caracteización Alimentos.xlsx]
2019-03-14 Laimi2 13 3 Mary
    [Calculo de tolvas.xlsx, Caracteización Alimentos.xlsx, Tal 220.SLDPRT, Tolva Acero Inoxidable.SLDPRT, Tolva Romana.SLDPRT]
2019-03-17 17-3 Laimi1 Manana
    [1-2 x 1-2.SLDPRT, Bastidor.SLDPRT, E Lev Esclusa.SLDASM, E Medicion de Masas General.SLDASM, E Min Esclusa.SLDASM, E Tolva Romana.SLDASM, Lev Bastidor.SLDPRT, Lev Contenedor.SLDPRT]
2019-03-17 17-3-2019 Laimi1 Tarde
    [16N2A10A050___0N_.sldasm, Bastidor.SLDPRT, E Lev Esclusa.SLDASM, E Medicion de Masas General.SLDASM, E Min Esclusa.SLDASM, E Tolva Romana.SLDASM, Piston 3 & 4.SLDASM, Soportes Esclusas.SLDPRT]
2019-03-21 20-3-2019 Electronica y software
    [CELDAS_CARGA.ms14, CRUCE_CERO.ms14, Calculo de sensibilidades celda de carga.xlsx, Celdas de Carga.ms14, Control RMS.ms14, Disparo_Triac.ms14, GENERAL.ms14, HX711.ms14]
2019-03-25 Laimi 2 25-3
    [Calculo de sensibilidades celda de carga.xlsx, Croquis don Miguel.SLDDRW, E Tolva Romana.SLDASM, E Tolva Romana.SLDDRW]
2019-03-26 Laimi 2 25-3-2
    [2x2x1-8.SLDPRT, A Mineral.SLDASM, A Tolva Contenedor.SLDASM, Acople Stepper.SLDPRT, Bastidor Concentrado.SLDPRT, Brida Inferior.SLDPRT, Brida PVC 1 in.SLDPRT, Brida Superior.SLDPRT]
2019-04-01 Laimi 2 1-4
    [Acople Tubo PVC Concentrado.SLDPRT, Bota Inferior.SLDPRT, Bota Lateral.SLDPRT, Bota Superior.SLDPRT, Control RMS.ms14, Disparo Triac Analogico.ms14, GENERAL.ms14, HX711.ms14]
2019-04-09 Laimi 1 8-04
    [Calculo de tolvas.xlsx, Calculo_de_tolvas_Version_Tesis.xlsx, Caracterización Alimentos Tesis.xlsx, Hoppers_AutoCAD.dwg]
2019-04-09 Laimi 2 8-4
    [Calculo_de_tolvas_Version_Tesis.xlsx]
2019-04-12 12-4-19 GC
    [A Tolva Contenedor.SLDASM, BALANCE.xlsx, Bastidor Concentrado.SLDPRT, Bastidor.SLDPRT, Bastidor_Mineral.SLDPRT, Bota Inferior.SLDPRT, Bota Lateral Aluminio.SLDPRT, Bota Lateral.SLDPRT]
2019-04-17 16-04-19 2
    [A Mineral.SLDASM, A Tolva Contenedor.SLDASM, Asm Dosificador Mineral.SLDASM, Banda.SLDPRT, Bastidor Concentrado.SLDPRT, Bastidor Mineral.SLDPRT, E Bota Concentrado.SLDASM, E General.SLDASM]
2019-04-23 22-4-19 Laimi 2
    [Calculo de tolvas.xlsx, Calculo_de_tolvas_Version_Tesis.xlsx]
2019-04-28 Laimi1 28-04
    [Esquema de proceso.dwg, Mediciones celdas de carga concentrado.xlsx]
2019-04-28 Laimi 1 28-4
    [Aproximación transporte de TSF 30%.xlsx, Calculo_de_tolvas_Version_Tesis.xlsx]
2019-05-07 Laimi2 6-05
    [A Levadura.SLDASM, A Medicion Mineral.SLDASM, A Mineral.SLDASM, A Stepper Motor.SLDASM, A Tolva Contenedor.SLDASM, A Transportador 1 in.SLDASM, A Transportador Lev in.SLDASM, Acople Stepper.SLDPRT]
2019-05-08 Laimi 1 planos
    [16N2A10A050 Cilindro.sldprt, 16N2A10A050 Piston.sldprt, A Levadura.SLDASM, A Medicion Mineral.SLDASM, A Stepper Motor.SLDASM, A Tolva Contenedor.SLDASM, A Transportador 1 in.SLDASM, Acople Stepper.SLDPRT]
2019-05-08 laimi 1 manana
    [Bastidor.SLDPRT, PLANO PFG.SLDDRW, Tolva Romana.SLDPRT]
2019-05-09 Laimi 1 8-5
    [A Tolva Contenedor.SLDASM, Acople Stepper.SLDPRT, Bastidor Concentrado.SLDPRT, Bota Inferior.SLDPRT, Bota Lateral Aluminio.SLDPRT, Bota Lateral.SLDPRT, Bota Superior.SLDPRT, Compuerta.SLDPRT]
2019-05-12 Laimi 1 12-5
    [1-2 x 1-2.SLDPRT, 16N2A10A050 Cilindro.sldprt, 16N2A10A050 Piston.sldprt, 16N2A10A050___0N_.sldasm, 2x2x1-8.SLDPRT, A Concentrado.SLDASM, A Hinge.SLDASM, Aproximación transporte de TSF 30%.xlsx]
2019-05-12 Laimi 1 12-05 2
    [A Tolva Contenedor.SLDASM, Acople Stepper.SLDPRT, Amarra Tubo Lev.SLDPRT, Amarra Tubo.SLDPRT, Bastidor.SLDPRT, Bota Inferior.SLDPRT, Bota Lateral.SLDPRT, E Bota Concentrado.SLDASM]
2019-05-14 Laimi 2 13-5
    [16N2A10A050 Cilindro.sldprt, 16N2A10A050 Piston.sldprt, A Tolva Contenedor.SLDASM, A Tolva Contenedor.SLDDRW, Acople Stepper.SLDPRT, Acople Tubo PVC Concentrado.SLDPRT, Amarra Tubo Lev.SLDPRT, Amarra Tubo.SLDPRT]
2019-05-15 Laimi 2 14-5
    [16N2A10A050 Cilindro.sldprt, 16N2A10A050 Piston.sldprt, A Levadura.SLDASM, A Medicion Mineral.SLDASM, A Stepper Motor.SLDASM, A Tolva Contenedor.SLDASM, A Tolva Contenedor.SLDDRW, Acople Stepper.SLDPRT]
2019-05-17 Laimi 1 16-5
    [A Levadura.SLDASM, A Medicion Mineral-Bastidor.SLDASM, A Medicion Mineral-Bastidor.SLDDRW, A Medicion Mineral.SLDASM, A Stepper Motor.SLDASM, A Tolva Contenedor.SLDASM, Amarra Tubo 1-2 in.SLDPRT, Bastidor Mineral.SLDPRT]
2019-05-17 Laimi2 16-5
    [16N2A10A050 Cilindro.sldprt, 16N2A10A050 Piston.sldprt, A Levadura.SLDASM, A Medicion Mineral.SLDASM, A Stepper Motor.SLDASM, A Tolva Contenedor.SLDASM, A Tolva Contenedor.SLDDRW, A Transportador 1 in.SLDASM]
2019-05-20 Home 20-5
    [A Medicion Mineral.SLDASM, A Stepper Motor.SLDASM, BALANCE.xlsx, Datos CC.xlsx, E Lev Esclusa.SLDASM, E Medicion de Masas General.SLDASM, E Min Esclusa.SLDASM, E Solo Tolva.SLDASM]
2019-05-20 Consuagro 20-5
    [16N2A10A050 Cilindro.sldprt, 16N2A10A050 Piston.sldprt, A Levadura.SLDASM, A Medicion Mineral.SLDASM, A Stepper Motor.SLDASM, A Transportador 1 in.SLDASM, Acople Stepper.SLDPRT, Acople Tubo PVC Concentrado.SLDPRT]
2019-05-22 laimi 1 21-5
    [A Levadura.SLDASM, A Medicion Mineral.SLDASM, A Stepper Motor.SLDASM, A Tolva Contenedor.SLDASM, A Tolva Contenedor.SLDDRW, Control de piezas.xlsx, E Bota Concentrado.SLDASM, E General.SLDASM]
2019-05-22 Laimi 2 21-05
    [A Levadura.SLDASM, A Medicion Mineral.SLDASM, A Stepper Motor.SLDASM, A Tolva Contenedor.SLDASM, A Tolva Contenedor.SLDDRW, A Transportador 1 in.SLDASM, Acople Stepper.SLDPRT, Control de piezas.xlsx]
2019-05-22 Consuagro 22-5
    [A Medicion Mineral-Bastidor.SLDASM, A Medicion Mineral-Bastidor.SLDDRW, A Medicion Mineral.SLDASM, A Stepper Motor.SLDASM, A Tolva Contenedor.SLDASM, A Tolva Contenedor.SLDDRW, BALANCE.xlsx, E Bota Concentrado.SLDASM]
2019-05-30 Limpieza 30-05-2019
    [0.75 x 0.75 x 1-16.SLDPRT, 1-2 x 1-2.SLDPRT, 16N2A10A050 Cilindro.sldprt, 16N2A10A050 Piston.sldprt, 16N2A10A050___0N_.sldasm, 2x2x1-8.SLDPRT, 35620082.dwg, 36700043.dwg]
